auselia/adc_test_board/doc/notes/head_circuit.tex

\documentclass[border=6pt]{standalone}
\usepackage{amsmath}
\usepackage[siunitx,americanvoltage]{circuitikz}
\usepackage{xcolor}
\definecolor{ink}{HTML}{14231B}
\ctikzset{bipoles/length=1.15cm, resistors/scale=0.9, capacitors/scale=0.9, inductors/scale=0.9, voltage/distance from node=.3}
\newcommand{\lab}[3]{\shortstack{$#1$\\{\footnotesize #2}\\{\scriptsize #3}}}
\begin{document}
\sffamily
\begin{circuitikz}[american, color=ink, font=\small]
  % ---------- op-amp U8
  \node[op amp, yscale=1, scale=1.0] (op) at (8,0) {};
  \node[font=\footnotesize, align=left, anchor=west] at ($(op.down)+(0.35,-0.3)$) {U8 OPA365};
  \draw (op.-) -- ++(-1.4,0) coordinate (X) node[circ] {};
  \draw (op.+) -- ++(-1.4,0) coordinate (VP);
  \draw (op.out) -- ++(1.4,0) coordinate (O) node[circ] {};
  \draw (op.up) -- ++(0,0.45) node[vcc, font=\footnotesize] {$V_+$};
  \draw (op.down) -- ++(0,-0.45) node[ground] {};
  % ---------- feedback Rf || Cf
  \coordinate (F1) at ($(X)+(0,1.7)$);
  \coordinate (F2) at ($(X)+(0,3.4)$);
  \draw (X) -- (F2);
  \draw (F1) to[R, l={\lab{R_f}{1\,M$\Omega$}{$\pm1\,\%$}}] (F1 -| O) -- (O);
  \draw (F2) to[C, l={\lab{C_f}{47\,pF C0G}{$\pm5\,\%$}}] (F2 -| O) -- (F1 -| O);
  \node[circ] at (F1) {};
  % ---------- piezo
  \coordinate (P) at ($(X)+(-5.8,0)$);
  \coordinate (Q) at ($(X)+(-3.2,0)$);
  \draw (X) -- (P);
  \node[ground] (g1) at ($(P)+(0,-2.6)$) {};
  \draw (g1) to[isource] (P);
  \node[left, font=\footnotesize, align=right] at ($(P)+(-0.55,-1.3)$) {charge\\source $Q$};
  \node[circ] at (Q) {};
  \draw (Q) to[C, l_={\lab{C_p}{1.6\,nF}{$\pm20\,\%$}}] ($(Q)+(0,-2.6)$) node[ground] {};
  \node[font=\footnotesize, align=center] at ($(P)!0.5!(Q)+(0,0.6)$) {piezo SMD05T04S311\\(5\,mm $\times$ 0.4\,mm)};
  \node[font=\footnotesize, above] at ($(X)+(-1.0,0)$) {$v_x$};
  % ---------- reference divider R29, R30, C35
  \coordinate (D1) at ($(X)+(-1.7,-1.6)$);
  \node[vcc, font=\footnotesize] at (D1) {$V_+$};
  \draw (D1) to[R, l_={\lab{R_{29}}{1\,M$\Omega$}{$\pm1\,\%$}}] ($(D1)+(0,-2.4)$) coordinate (D2);
  \draw (D2) to[R, l_={\lab{R_{30}}{1\,M$\Omega$}{$\pm1\,\%$}}] ($(D2)+(0,-2.4)$) node[ground] {};
  \node[circ] at (D2) {};
  \draw (D2) -- ($(D2)+(1.2,0)$) coordinate (D3);
  \draw (D3) to[C, l={\lab{C_{35}}{10\,$\mu$F X5R}{$\pm20\,\%$}}] ($(D3)+(0,-2.4)$) node[ground] {};
  \node[circ] at (D3) {};
  \draw (D3) -| (X |- VP) -- (VP);
  \node[font=\footnotesize, anchor=east] at ($(D2)+(-0.2,0)$) {$V_{REF}\approx1.45$ V};
  % ---------- output: R31, C38, SMA
  \draw (O) to[R, l={\lab{R_{31}}{49.9\,$\Omega$}{$\pm1\,\%$}}] ($(O)+(2.9,0)$) to[C, l={\lab{C_{38}}{100\,nF X7R}{$\pm10\,\%$}}] ($(O)+(5.7,0)$) coordinate (H) node[circ] {};
  \draw (H) -- ($(H)+(1.3,0)$) node[ocirc] (J) {};
  \node[font=\footnotesize, right, align=left] at (J) {J6 SMA\\to SENSOR IN};
  % ---------- supply from the coax: L1, C36, C37
  \draw (H) to[L, l_={\lab{L_1}{470\,$\mu$H}{$\pm10\,\%$, DCR 22.5\,$\Omega$, SRF 2\,MHz}}] ($(H)+(0,-2.8)$) coordinate (VN) node[circ] {};
  \draw (VN) -- ++(0,-0.5) coordinate (VB);
  \node[font=\footnotesize, left=3pt] at (VN) {$V_+\approx2.9$ V};
  \draw (VB) -- ++(-1.1,0) to[C, l_={\lab{C_{36}}{100\,nF X7R}{$\pm10\,\%$}}] ++(0,-2.3) node[ground] {};
  \draw (VB) -- ++(1.1,0) to[C, l={\lab{C_{37}}{10\,$\mu$F X5R}{$\pm20\,\%$}}] ++(0,-2.3) node[ground] {};
  \node[font=\footnotesize, align=left, anchor=west] at ($(H)+(1.55,-1.5)$) {3.3 V arrives on\\the coax centre};
\end{circuitikz}
\end{document}
