auselia/adc_test_board/doc/notes/slides/s10_circuit.tex

\documentclass[border=6pt]{standalone}
\usepackage{amsmath}
\usepackage[siunitx,americanvoltage]{circuitikz}
\usepackage{xcolor}
\definecolor{ink}{HTML}{14231B}
\ctikzset{bipoles/length=1.15cm, resistors/scale=0.9, capacitors/scale=0.9, inductors/scale=0.9}
\newcommand{\lab}[3]{\shortstack{$#1$\\{\footnotesize #2}\\{\scriptsize #3}}}
\begin{document}
\sffamily
\begin{circuitikz}[american, color=ink, font=\small]
  \node[draw,thick,align=center,font=\footnotesize,minimum width=2.6cm,minimum height=2.2cm] (J) at (1.5,0) {J7\\5-pin header\\(jumper 1--2)};
  \node[font=\footnotesize,anchor=west] at (2.95,1.0){1 Onboard $+$}; 
  \node[font=\footnotesize,anchor=west] at (2.95,0.4){2 Force $+$, 3 Sense $+$};
  \node[font=\footnotesize,anchor=west] at (2.95,-0.2){4 Sense $-$, 5 Force $-$ (GND)};
  \draw (-0.1,1.0) node[left,font=\footnotesize,align=right]{PMOD 6, 12\\3.3 V} -- (0.2,1.0);
  \draw (0.2,0.4) -- (-0.6,0.4) -- (-0.6,-1.6) -- (8.0,-1.6) coordinate (V) node[circ]{} node[above=4pt,font=\footnotesize]{+3V3};
  \draw (V) to[C, l={\lab{C_{23}}{10\,$\mu$F}{X5R}}] ++(0,-2.2) node[ground]{};
  \draw (V) -- ++(2.2,0) to[short] ++(1.2,0) node[above,font=\footnotesize]{JP3} -- ++(1.0,0) coordinate (CAP) node[circ]{} node[above=3pt,font=\footnotesize,xshift=12mm]{+3V3\_C: U1 U2 U3};
  \draw (CAP) -- ++(0,-1.8) to[R, l={\lab{R_{34}}{10\,$\Omega$}{$\pm1\,\%$}}] ++(2.4,0) coordinate (AV) node[circ]{} -- ++(0.8,0) node[right,font=\footnotesize]{AVDD};
  \draw (AV) to[C, l_={\lab{C_{21}}{10\,$\mu$F}{X5R}}] ++(0,-2.2) node[ground]{};
  \draw (V) ++(1.0,0) node[circ]{} -- ++(0,1.8) -- ++(1.6,0) node[right,font=\footnotesize]{+3V3: listener, DVDD};
\end{circuitikz}
\end{document}
