auselia/adc_test_board/doc/notes/slides/s10_power.tex

\documentclass[11pt,a4paper]{article}
\input{common}
\title{\textbf{Slide 10: power and rails}\\\large 3.3 V from the PMOD alone, split by current links}
\author{ADS7057 test board v3 \quad ---\quad study notes}\date{}
\begin{document}\maketitle\vspace{-1.2em}
\section{The power tree}
\begin{center}\end{center}
PMOD pins 6 and 12 bring 3.3 V. There is no regulator, no diode and no USB. The 5-pin header J7 is the power entry: 1 Onboard + (PMOD 3.3 V), 2 Force +, 3 Sense +, 4 Sense $-$, 5 Force $-$. A jumper from 1 to 2 powers the board from the ZedBoard. For a source-measure unit remove the jumper and connect Force to 2 and 5, Sense to 3 and 4: the SMU powers the board and reads its total current. JP3 (closed) joins the capture rail +3V3\_C (U1, U2, U3 and AVDD) to +3V3. Open it to switch or measure the chain alone. The listener and DVDD sit on +3V3.

\section{AVDD is the reference}
The ADS7057 uses AVDD as its reference, so noise on AVDD is noise in the code. AVDD comes from the rail through R34 ($10\,\Omega$) and C21 ($10\,\mu$F). First-order RC:
\[
f_c=\frac1{2\pi R_{34}C_{21}}=\frac{1}{2\pi\cdot10\,\Omega\cdot10\,\mu\text{F}}=\SI{1.59}{kHz}
\]
\[
|H(\SI{250}{kHz})|=\frac1{\sqrt{1+(250/1.59)^2}}=\frac1{157}=-43.9\ \text{dB}.
\]
\begin{center}\end{center}
C18 ($4.7\,\mu$F) and C22 (\SI{100}{nF}) sit at the ADC pin. The DC drop over R34 is small: the ngspice rail shows AVDD at \SI{3.271}{V} against \SI{3.299}{V} on +3V3.

\section{The two mid-rails}
VMID5 (the 1.65 V that the filters and the gain stage reference) is a divider R7, R8 ($2\times10\,$k$\Omega$ from +3V3\_C) with C7 ($1\,\mu$F), copied by U2B and filtered by R9 and C8. The divider and C7 give $\tau=(R_7\parallel R_8)C_7=5\,\text{k}\Omega\times1\,\mu\text{F}=\SI{5}{ms}$, so VMID5 needs about $5\tau=\SI{25}{ms}$ after power-up. VOCM (the driver's centre) is a second divider R14, R15 ($2\times1\,$k$\Omega$ from AVDD) with C13. It follows AVDD by ratio, as the datasheet asks (AVDD/2 $\pm0.1$ V). ngspice: VMID5 1.649 V, VOCM 1.636 V.

\section{Current budget}
\begin{center}\end{center}
The sum of the datasheet typical values is \SI{25.9}{mA}, which is \SI{85}{mW} at 3.3 V. The ngspice netlist with all links closed gives \SI{24.8}{mA}. The four OPA2365 channels dominate. The listener takes only \SI{22}{\micro A}. The 1.65 mA of the VOCM divider is the cheapest saving if the board ever runs from a battery (use $10\,$k$\Omega$ and a larger C13).

\begin{key}
Open item: the noise of the ZedBoard 3.3 V rail is not measured. Probe TP11 (+3V3) and TP12 (AVDD) on the first board.
\end{key}
\end{document}
