auselia/adc_test_board/doc/notes/slides/s08_circuit.tex

\documentclass[border=6pt]{standalone}
\usepackage{amsmath}
\usepackage[siunitx,americanvoltage]{circuitikz}
\usepackage{xcolor}
\definecolor{ink}{HTML}{14231B}
\ctikzset{bipoles/length=1.15cm, resistors/scale=0.9, capacitors/scale=0.9, inductors/scale=0.9}
\newcommand{\lab}[3]{\shortstack{$#1$\\{\footnotesize #2}\\{\scriptsize #3}}}
\begin{document}
\sffamily
\begin{circuitikz}[american, color=ink, font=\small]
  \node[font=\footnotesize,anchor=east] at (0,1.2){DRV\_OUTP}; \node[font=\footnotesize,anchor=east] at (0,-1.2){DRV\_OUTN};
  \draw (0,1.2) to[R, l={\lab{R_{16}}{10\,$\Omega$}{$\pm1\,\%$}}] ++(2.6,0) coordinate (A) node[circ]{} -- ++(3.0,0) node[above,font=\footnotesize,xshift=-6mm]{AINP};
  \draw (0,-1.2) to[R, l_={\lab{R_{17}}{10\,$\Omega$}{$\pm1\,\%$}}] ++(2.6,0) coordinate (B) node[circ]{} -- ++(3.0,0) node[below,font=\footnotesize,xshift=-6mm]{AINM};
  \draw (A) -- ++(0,0) ; \draw (A) to[C, l_={\lab{C_{14}..C_{17}}{4 $\times$ 100\,pF C0G}{400\,pF, $\pm5\,\%$}}] (B);
  \draw[thick,rounded corners=2pt] (5.6,-2.0) rectangle (10.4,2.0);
  \node[align=center,font=\footnotesize] at (8,2.5){U4 ADS7057 sampling input (model)};
  \draw (5.6,1.2) to[R, l={\lab{}{50\,$\Omega$}{}}] (7.6,1.2) to[C, l={\lab{}{16\,pF}{}}] (9.4,1.2) node[ground,rotate=0]{};
  \draw (5.6,-1.2) to[R, l_={\lab{}{50\,$\Omega$}{}}] (7.6,-1.2) to[C, l_={\lab{}{16\,pF}{}}] (9.4,-1.2) node[ground]{};
\end{circuitikz}
\end{document}
