auselia/adc_test_board/doc/notes/slides/s03_circuit.tex

\documentclass[border=6pt]{standalone}
\usepackage{amsmath}
\usepackage[siunitx,americanvoltage]{circuitikz}
\usepackage{xcolor}
\definecolor{ink}{HTML}{14231B}
\ctikzset{bipoles/length=1.15cm, resistors/scale=0.9, capacitors/scale=0.9, inductors/scale=0.9}
\newcommand{\lab}[3]{\shortstack{$#1$\\{\footnotesize #2}\\{\scriptsize #3}}}
\begin{document}
\sffamily
\begin{circuitikz}[american, color=ink, font=\small]
  % head side
  \node[font=\footnotesize, align=right, anchor=east] at (-0.2,0) {U8 output\\ $v_o$};
  \draw (0,0) to[R, l={\lab{R_{31}}{49.9\,$\Omega$}{$\pm1\,\%$}}] (3,0) to[C, l={\lab{C_{38}}{100\,nF X7R}{$\pm10\,\%$}}] (6,0) coordinate (H) node[circ]{};
  \draw (H) to[L, l_={\lab{L_1}{470\,$\mu$H}{$\pm10\,\%$, DCR 22.5\,$\Omega$}}] ($(H)+(0,-3)$) coordinate (VH) node[circ]{};
  \node[font=\footnotesize, left=3pt] at (VH) {$V_+\approx2.9$ V};
  \draw (VH) -- ++(0,-0.5) coordinate (VB);
  \draw (VB) -- ++(-1.0,0) to[C, l_={\lab{C_{36}}{100\,nF}{X7R}}] ++(0,-2.1) node[ground]{};
  \draw (VB) -- ++(1.0,0) to[C, l={\lab{C_{37}}{10\,$\mu$F}{X5R}}] ++(0,-2.1) node[ground]{};
  % coax
  \draw[line width=2.2pt, color=ink!70] (H) -- ++(6.6,0) coordinate (M);
  \node[above, font=\footnotesize] at ($(H)!0.5!(M)+(0,0.1)$) {coax, 50\,$\Omega$};
  \node[circ] at (M) {};
  % main board side
  \draw (M) to[C, l={\lab{C_{33}}{100\,nF X7R}{$\pm10\,\%$}}] ($(M)+(3,0)$) coordinate (S) node[circ]{};
  \draw (S) -- ++(1.3,0) node[right, font=\footnotesize, align=left] {SIG\_IN\\to the high-pass};
  \draw (S) to[R, l_={\lab{R_{27}}{1\,M$\Omega$}{$\pm1\,\%$}}] ($(S)+(0,-2.6)$) node[vcc, rotate=180, font=\footnotesize, anchor=south]{};
  \node[font=\footnotesize, right] at ($(S)+(0.15,-2.9)$) {$V_{MID5}$ 1.65 V};
  \draw (M) to[L, l_={\lab{L_2}{470\,$\mu$H}{$\pm10\,\%$, DCR 22.5\,$\Omega$}}] ($(M)+(0,-3)$) coordinate (P) node[circ]{};
  \node[font=\footnotesize, left=3pt] at (P) {JP1 closed};
  \draw (P) -- ++(0,-0.5) coordinate (PB);
  \draw (PB) -- ++(-1.1,0) to[R, l_={\lab{R_{26}}{47\,$\Omega$}{$\pm1\,\%$}}] ++(0,-2.1) node[vcc, rotate=180]{};
  \node[font=\footnotesize, below=14pt] at ($(PB)+(-1.1,-2.1)$) {3.3\,V};
  \draw (PB) -- ++(1.1,0) to[C, l={\lab{C_{32}}{10\,$\mu$F}{X5R $\pm10\,\%$}}] ++(0,-2.1) node[ground]{};
\end{circuitikz}
\end{document}
