auselia/adc_test_board/doc/notes/head_charge_amp.pdf

## The sensor head, from the equations up

Charge amplifier, OPA365, DC point and noise

ADS7057 test board v3 — study notes

All voltages are deviations from the DC operating point, written in lowercase (v). Capital V is a total or DC value. The Laplace variable is s = jω = j2πf.

## 1 The circuit and its three equations

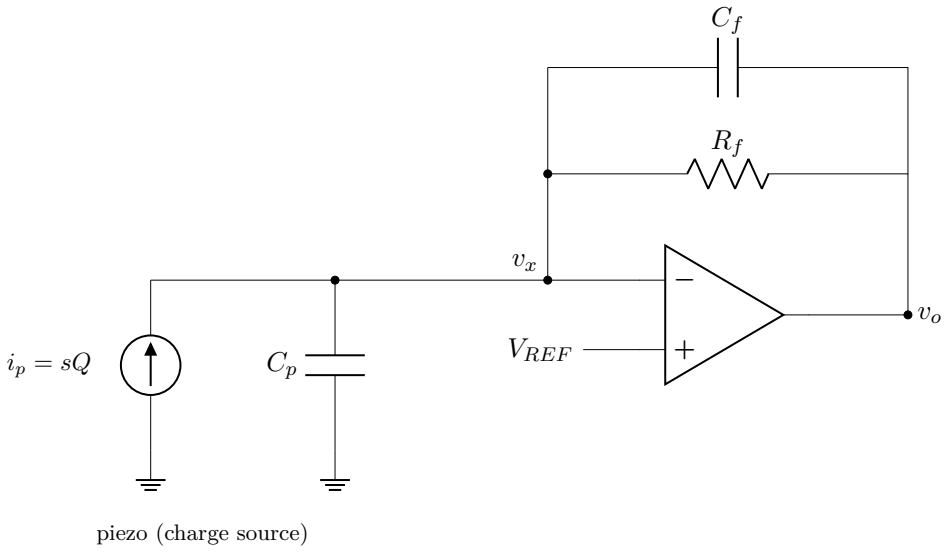
[picture p1: figure]
VREF; piezo (charge source)

The piezo is a charge source Q in parallel with its own capacitance Cp ≈ 1.6 nF. In the head, Cf = 47 pF and Rf = 1 MΩ are in parallel between the output and the summing node, and the + input sits at VREF ≈ 1.45 V.

Feedback impedance:

Zf =

Rf
1 + sRfCf

, Yf =

1
Zf

=

1
Rf

+ sCf .

Three equations describe the whole stage.

(1) Op-amp with finite gain (+ input at VREF , so 0 in deviations):

vo = A (0 − vx) = −A vx.

(2) KCL at the summing node. The piezo current leaves through Cp and through the feedback branch:
ip = sCp vx +

vx − vo
Zf

(3) The piezo:

ip =

dq
dt ←→ ip(s) = s Q(s).

We do not assume a virtual ground. vx is allowed to be non-zero.

## 2 Exact solution

From (1), vx − vo = (1 + A)vx. Putting this in (2):

ip = vx

h
sCp + (1 + A)Yf

i
⇒ vx =

ip
sCp + (1 + A)Yf

Then vo = −A vx:

vo = − ip Zf

1

1 +

1 + sCpZf
A

Read this as ideal result × error factor. The ideal part −ipZf is what you get as A → ∞ (the virtual ground). The numerator of the error term, 1 + sCpZf , is the noise gain.

## 3 Frequency response

A single-pole op-amp is modelled as
A(s) = ωt
s
, | ωt = 2π GBW, | GBW = 50 MHz (OPA365).

Substitute ip = sQ and A = ωt/s:

| vo Q = − | s Zf
| 1 +

s (1 + sCpZf )

| | ωt .

Numerator. With Zf = Rf /(1 + sRfCf ),

sZf =

1
Cf

·

s
s + ωL
| , | ωL =
| | 1 RfCf .

Denominator. For ω ≫ ωL, Zf ≈ 1/(sCf ), so 1 + sCpZf → 1 + Cp/Cf . Define the noise gain

Gn = 1 +

Cp
Cf
, | 1 +
| sGn ωt
= 1 +
| | s ωH
, | ωH =
| | ωt Gn .

Together:
vo
Q

≈ −

| 1 Cf s

# s + ωL | {z }

| high-pass | 1 1 + s/ωH
| {z }
| | low-pass
The head is a band-pass. Mid-band gain is −1/Cf .
Quantity | Formula | Value
Mid-band gain 1/Cf | 21.3 mV per pC
Low corner | fL =
| 1 2πRfCf | 3.39 kHz (τ = 47 µs)
Noise gain | Gn = 1 + Cp/Cf | 1 + 1600/47 = 35.0
High corner | fH = GBW/Gn | 1.43 MHz

At 250 kHz, the middle of the AE band:

s
s+ωL

≈ 0.9999,

1
1+j 250/1430
=

1
√
1 + 0.175²

= 0.985 (−0.13 dB).

The perfboard’s OPA1642 has GBW ≈ 11 MHz, so fH = 11/35 = 0.31 MHz and the factor at
250 kHz is 1/

√
1 + 0.8

2 = 0.78, that is −2.1 dB. This is the 0.2 dB versus 2.2 dB difference between the boards.

## 4 How good is the “virtual ground”?

From the solution, vx = −vo/A. At 250 kHz, A = GBW/f = 200. For a 100 mV output, vx = 0.5 mV. That is small but not zero. The charge that stays on Cp is

Cpvx = (1.6 nF)(0.5 mV) = 0.8 pC.

This is the origin of the error term Gnf /GBW = 0.175.

A large Cp compared with Cf means a large noise gain, less loop gain, and a larger error. A smaller Cf gives more volts per pC but more noise gain and less bandwidth. This is the design trade-off of the head.

## 5 Noise from the same model

Add the op-amp’s input voltage noise en in series with the + input. With the signal off, the loop gives

vo,n = en

1 +

Zf
ZCp
= en (1 + sCpZf )

ω≫ωL −−−−−→ en Gn.

This is the same quantity as in the error factor, which is why it is called the noise gain. With
en = 4.5 nV/

√
Hz:

enGn = 158 nV/

√
Hz, vn,rms = 158 nV/

√
Hz ·

√
400 kHz ≈ 100 µV.
The noise densities are per √
Hz because independent sources add as powers.

Thermal noise of Rf appears as a current noise

in,Rf =

s
4kT
Rf

= 0.129 pA/

√
Hz.
It flows through Zf . At 250 kHz, |Zf | ≈ 1/(2πfCf ) = 13.5 kΩ, so it adds about 1.7 nV/

√
Hz at the
output, about 1 % of the op-amp’s. It can be ignored.

Equivalent noise charge (noise referred to the input):

Qn = vn,rms Cf ≈ 100 µV × 47 pF = 4.7 fC.

The perfboard measurements show about 4 mV rms in the band, 40 times the amplifier’s own noise. So the noise you see comes from elsewhere (plant, cables, pickup), not from the op-amp.

## 6 DC operating point

Set s → 0 in the KCL. Cp and Cf are open circuits, so the only DC path is Rf . A real op-amp also has an input bias current Ib and an input offset voltage Vos:

Vout,DC = VREF

A
1 + A

+ IbRf + Vos ≈ VREF + IbRf + Vos.

For DC the stage is a unity-gain follower.

- With Ib of a few pA and Rf = 1 MΩ, IbRf is of order µV. Negligible.
- If Ib were 160 nA (as in the THS4531), IbRf would be 0.16 V. A high-bias part does not work with a megohm feedback resistor.

The reference comes from the divider R29, R30 (both 1 MΩ):

VREF = V+

R30

R29 + R30

=

2.9 V
2

= 1.45 V.

So the output rests at about 1.45 V, mid-supply. The available swing is about ±1.3 V:

Qmax ≈ 1.3 V × 47 pF ≈ 61 pC,

while events are 2 to 11 pC.

## 7 Supply down the coax (bias-T)

An inductor is the opposite of a capacitor: |ZL| = 2πfL. For L = 470 µH:

|ZL|(250 kHz) = 2π · 250 000 · 470 × 10−6 ≈ 740 Ω ≫ 50 Ω,

and ≈ 0 at DC. So the DC supply flows through the inductor, and the signal goes through the capacitor C38 instead (|ZC| = 1/(2πfC) = 6.4 Ω at 250 kHz for 100 nF). The drop across R26 (47 Ω) and the inductor’s own resistance, at about 4.3 mA, takes roughly 0.4 V off 3.3 V, so V+ at the amplifier is about 2.9 V.

## 8 Stability

The loop gain is T(s) = A(s) β(s) with feedback factor β = 1/Gn. At high frequency β ≈ Cf /(Cf + Cp) = 1/35, which is flat. The crossover (|T| = 1) is at fH = 1.43 MHz. There the op-amp’s single pole has used 90◦ of phase, leaving about 90◦ minus whatever the output stage (R31 and the load) adds. Cf in the feedback path is what keeps this stable: without it, Cp at the − node would add a feedback zero and could peak.

## 9 OPA365: the specs that matter

Spec | Value | Why it matters here
Gain-bandwidth | 50 MHz | Sets the head bandwidth, GBW/Gn = 1.4 MHz. The perfboard’s 11 MHz cost 2 dB.
Input voltage noise | 4.5 nV/

√
| Hz | Sets the noise floor: 100 µV rms at the output, 4.7 fC equivalent.
Supply range | 2.2 to 5.5 V | The head runs at about 2.9 V, inside the range.
Rail-to-rail in/out | yes | The output can use the full swing around 1.45 V.
Zero-crossover input | yes | No offset jump when the input sits near mid- supply, where our reference is.
Quiescent current | about 4.6 mA | Almost all of the head’s 4.3 mA. Reason for the OPA314 (150 µA) low-power option.
Input bias current | pA class (verify) | Allows Rf = 1 MΩ without a DC error.
Input offset voltage | a few hundred µV (verify) | Shifts the rest level slightly. Harmless with AC coupling.
Slew rate | about 25 V/µs (ver- ify) | A 150 mV burst at 250 kHz needs 2πfV = 0.24 V/µs. Large margin.

The entries marked verify are quoted from memory. Check them against the datasheet.

## 10 The design in five steps

1. KCL at the summing node with ip = sQ gives vo = −Q sZf (ideal).
2. Zf = Rf ∥ Cf : mid-band gain −1/Cf , high-pass at 1/(2πRfCf ) = 3.4 kHz.
3. Finite A = ωt/s adds the error factor with noise gain Gn = 1 + Cp/Cf = 35, which gives a low-pass at GBW/Gn = 1.4 MHz.
4. The same Gn multiplies en: about 100 µV rms at the output, 4.7 fC equivalent.
5. DC: a unity-gain follower to VREF , plus IbRf + Vos.
