auselia/adc_test_board/doc/notes/slides/s07_circuit.pdf

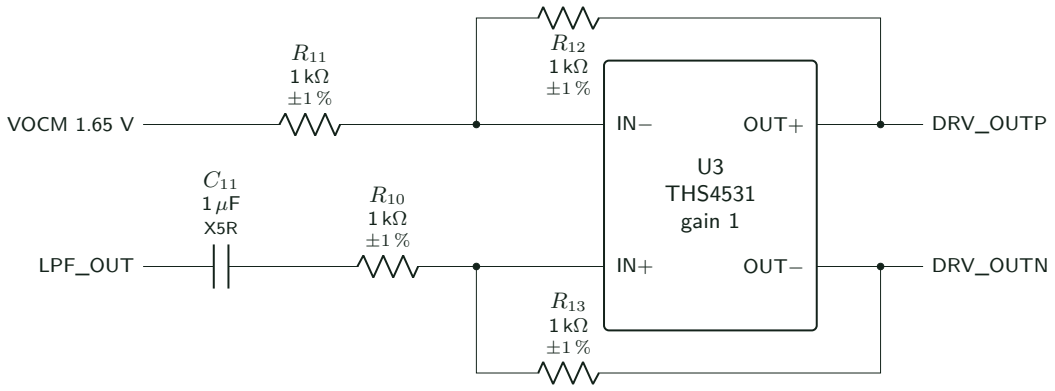
[picture p6: figure]
U3 THS4531 gain 1; OUT; LPF_OUT; VOCM 1.65 V; DRV_OUTP; DRV_OUTN
