auselia/adc_test_board/doc/notes/slides/s07_driver.pdf

## Slide 7: the driver (THS4531)

Turn one wire into the two the ADC needs

ADS7057 test board v3 — study notes

## 1 Why two wires

The ADS7057 measures the difference VAINP − VAINM, not a voltage to ground. Noise that reaches both inputs equally cancels. The low-pass output (LPF_OUT) is one wire. The driver U3 makes the second wire as a mirror image of the first, around the mid-rail VOCM = 1.65 V.

## 2 The circuit

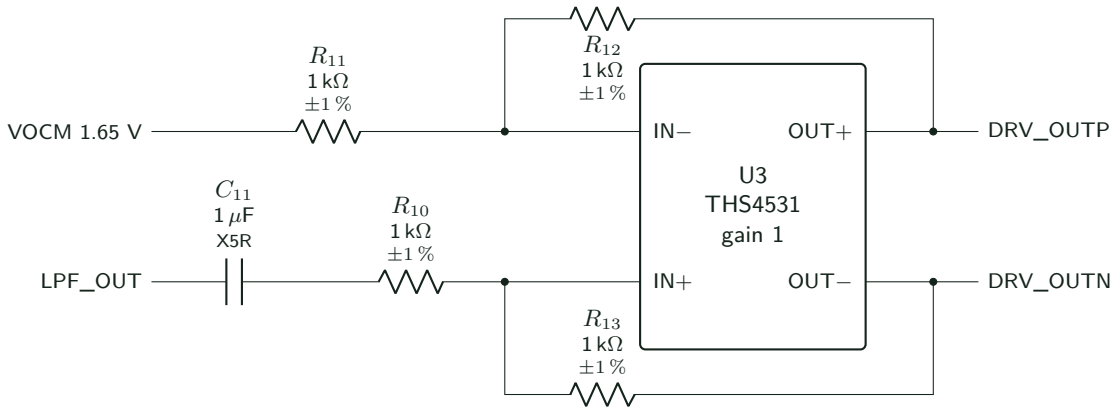
[picture p7: figure]
U3 THS4531 gain 1; OUT+; LPF_OUT; OUT−; VOCM 1.65 V; DRV_OUTP; DRV_OUTN

All four resistors are 1 kΩ. C11 blocks DC. VOCM sets the centre of the two outputs (R14, R15 divide AVDD, C13 smooths it).

## 3 Derivation

An ideal fully differential amplifier keeps its two inputs at the same voltage, vP = vN = v, and forces the average of its outputs to VOCM:

vo+ + vo−
2

= VOCM.

Write the current balance at the two input nodes (R = 1 kΩ for all four resistors, no current enters the amplifier):

node P: vin − v
R

+

vo− − v
R

= 0 node N: VOCM − v
R

+

vo+ − v
R

= 0.

Subtract the second equation from the first. The v terms cancel:

vin − VOCM + vo− − vo+ = 0 ⇒ vo+ − vo− = vin − VOCM

1

For the signal alone (deviation from DC, so VOCM does not move) the differential output equals the input: the gain is R13/R10 = 1. With the common-mode condition each output carries half:

vo± = VOCM ±

vin
2

DC. C11 is open at DC, so only R13 and R11 act. Both outputs sit at VOCM (ngspice: DRV_OUTP and DRV_OUTN at 1.64 V). Nothing is amplified at DC and nothing clips.

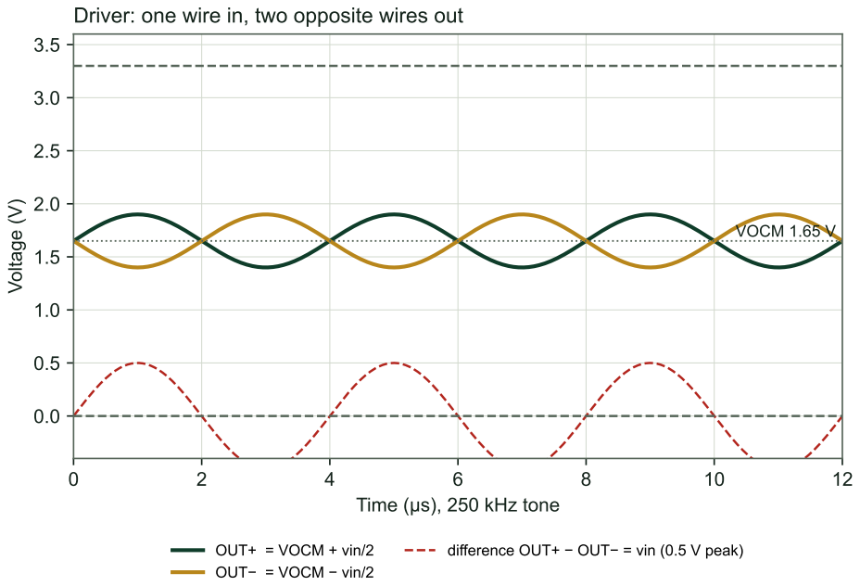
[picture p8: figure]
Time (µs), 250 kHz tone; Voltage (V); VOCM 1.65 V; OUT+ = VOCM + vin/2 OUT− = VOCM − vin/2

Driver: one wire in, two opposite wires out

difference OUT+ − OUT− = vin (0.5 V peak)

## 4 The input corner

The signal source sees C11 in series with the amplifier’s input resistance. The two feedback paths act on both input nodes, so the input resistance is not R10 alone. Solve node P with vo+ = 2v, vo− = −2v (ac, outputs in opposition): v = vin/4, so

iin =

vin − v
R

=

3
4

vin
R

⇒ Rin =

4R
3

= 1.33 kΩ, fc =

1
2πRinC11

= 119 Hz.

Correction to the manual (step 17): it gives 159 Hz, which uses R10 alone. With the feedback included the corner is 119 Hz. Both are far below the 100 kHz band, so nothing else changes.

## 5 Numbers to remember

Item | Value

Supply and VOCM range (3.3 V) 2.5 to 5.5 V; VOCM 0.95 to 2.3 V
Gain, band | differential gain 1; bandwidth far above the band
Event of 120 mV at the head | about 0.5 V between AINP and AINM
Load between the outputs | 400 pF behind 20 Ω, the datasheet suggests about 2 pF
(open risk, slide 13)

2
