auselia/adc_test_board/doc/notes/slides/s09_circuit.pdf

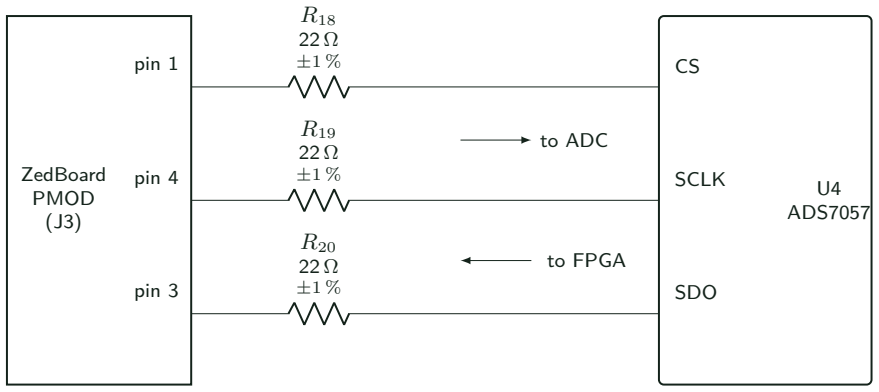
[picture p11: figure]
ZedBoard PMOD (J3); U4 ADS7057; pin 1; pin 4; SCLK; pin 3; SDO; to ADC; to FPGA

PMOD pins 5, 11 GND; 6, 12 3.3 V; 7 BIG_N; 10 WAKE_N; 2, 8, 9 not used
