auselia/adc_test_board/doc/notes/slides/s09_graph.pdf

CS

### SCLK

SDO | 0 | D13 D12 D11 D10 D9 | D8 | D7 | D6 | D5 | D4 | D3 | D2 | D1 | D0 | 0 | 0 | 0

CS falls: the ADC samples here

18 clocks: leading 0, 14 data bits (MSB first), 3 zeros. After the 18th clock CS rises; at least 95 ns of acquisition follow.
