auselia/adc_test_board/doc/notes/slides/s10_graph.pdf

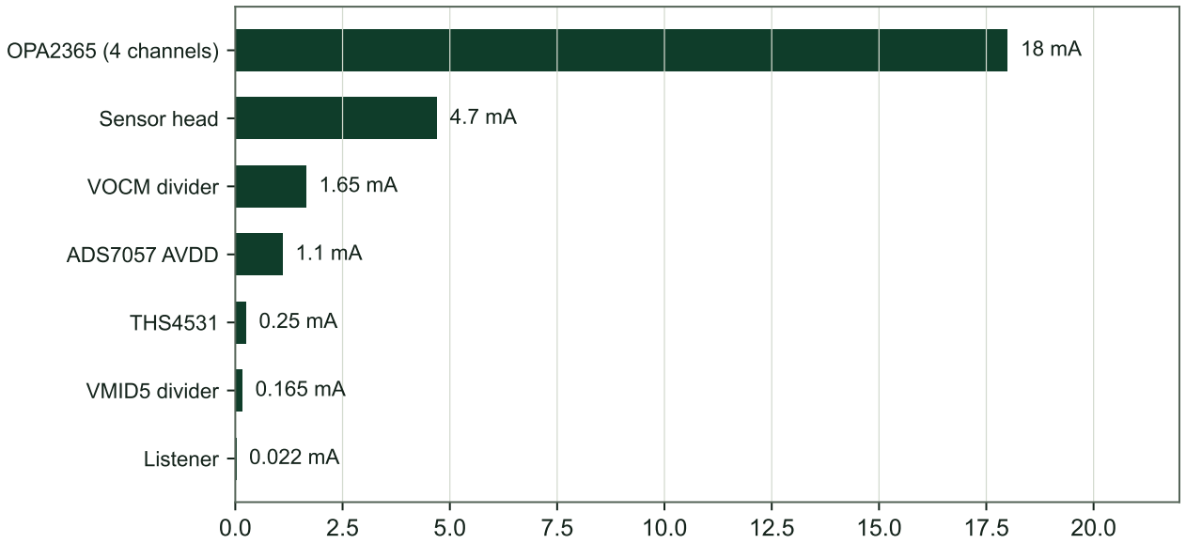
[picture p14: figure]
OPA2365 (4 channels); Sensor head; VOCM divider; ADS7057 AVDD; THS4531; VMID5 divider; Listener

Current from the 3.3 V of the PMOD (mA)

Current budget: 25.9 mA (datasheet typical values), ngspice 24.8 mA
