auselia/adc_test_board/doc/notes/slides/s13_graph.pdf

DC operating point, all rails (18 checks) | PASS | ngspice, as-built netlist
Gain 12.3 dB at 250 kHz; −40.5 dB at 10 kHz; −24 dB at 2 MHz | PASS | ngspice
Listener thresholds: WAKE_N 35 mV, BIG_N 111 mV at SIG_IN | PASS | ngspice, 5 burst levels
ERC, DRC, schematic against board | PASS | KiCad, 0 errors
Head and bias-T at 3.3 V; listener on 25 real captures | SIMULATED | ngspice, Python
ZedBoard 3.3 V rail noise (TP11, TP12) | OPEN | measure
PMOD fit on adjacent ports | OPEN | print 1:1, test
THS4531 stable with 400 pF + 20 Ω | OPEN | LTspice / bench
First board on the bench | OPEN | manual steps 49 to 52

# What is checked and what is open
