auselia/adc_test_board/hw/backplane/out/FMC_Adapter.pdf

1 | 2 | 3 | 4 | 5 | 6 | 7 | 8 | 9 | 10 | 11 | 12 | 13 | 14 | 15 | 16
1 | 2 | 3 | 4 | 5 | 6 | 7 | 8 | 9 | 10 | 11 | 12 | 13 | 14 | 15 | 16

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
## IJK Date: 2026-10-12

Size: A1 | Rev: A
KiCad E.D.A. 10.0.6 | Id: 1/1

# Title: ZedBoard FMC to backplane adapter (3 V level shifters, two 50-pin ribbon outputs)

## File: FMC_Adapter.kicad_sch

## Sheet: /

### Universidad de los Andes - Auselia VCCA 1 DIR 2

A1 3
A2 4
A3 5
A4 6
A5 7
A6 8
A7 9
A8 10 | GND 11 | GND 12 | GND 13 | B8 14 B7 15 B6 16 B5 17 B4 18 B3 19 B2 20 B1 21 OE 22 | VCCB 23 | VCCB 24 U5

SN74LVC8T245

C1
100nF

TP2 +3V3_FMC

TP3

VADJ

TP1 GND | VCCA 1 DIR 2

A1 3
A2 4
A3 5
A4 6
A5 7
A6 8
A7 9
A8 10 | GND 11 | GND 12 | GND 13 | B8 14 B7 15 B6 16 B5 17 B4 18 B3 19 B2 20 B1 21 OE 22 | VCCB 23 | VCCB 24 U1
SN74LVC8T245 | R6 47RR7 47R R5 47R R8 47R

C2

# 100nF R3 47R R2 47R R4 47R

D1

3V3 OK R27 1k | C20

100nF C19

100nF C18

10uF C17

10uF | GND C14 | GND C58 | GND C9
LA06_P C10 | LA06_NC11 GNDC12 | GNDC13
LA10_P C14 | LA10_NC15 GNDC16 | GNDC17
LA14_P C18 | LA14_NC19 GNDC20 | GNDC21
LA18_P_CC C22 | LA18_N_CCC23 GNDC24 | GNDC25
LA27_P C26 | LA27_NC27 GNDC28 | GNDC2932 | GNDC336 | GNDC38 | 3P3V C39 C40 | GND D2 | GND D3 | GND D67
LA01_P_CC D8 | LA01_N_CC GND | D9 D10
LA05_P D11 | LA05_ND12 GNDD13
LA09_P D14 | LA09_ND15 GNDD16
LA13_P D17 | LA13_ND18 GNDD19
LA17_P_CC D20 | LA17_N_CCD21 GNDD22
LA23_P D23 | LA23_ND24 GNDD25
LA26_P D26 | LA26_ND27 GND D28 | TDI D30 | TDO D313P3V D36GND D37 | 3P3V D39 | D3840GND G1 | GND G4 | GND G5
LA00_P_CC G6 | LA00_N_CC G7 GND G8
LA03_P G9 | LA03_NG10 GND G11
LA08_P G12 | LA08_NG13 GND G14
LA12_P G15 | LA12_NG16 GND G17
LA16_P G18 | LA16_NG19 GND G20
LA20_P G21 | LA20_NG22 GND G23
LA22_P G24 | LA22_NG25 GND G26
LA25_P G27 | LA25_NG28 GND G29
LA29_P G30 | LA29_NG31 GND G32
LA31_P G33 | LA31_NG34 GND G35
LA33_P G36 | LA33_NG37 GND G38 | VADJ G39GND G40 | PRSNT_M2C_L H3 | H2 GND H6
LA02_P H7 | LA02_N H8 GND H9
LA04_P H10 | LA04_NH11 GND H12
LA07_P H13 | LA07_NH14 GND H15
LA11_P H16 | LA11_NH17 GND H18
LA15_P H19 | LA15_NH20 GND H21
LA19_P H22 | LA19_NH23 GND H24
LA21_P H25 | LA21_NH26 GND H27
LA24_P H28 | LA24_NH29 GND H30
LA28_P H31 | LA28_NH32 GND H33
LA30_P H34 | LA30_NH35 GND H36
LA32_P H37 | LA32_NH38 GND H39 | VADJ H40

J1

ASP-134602-01 | C15
100nF | VCCA 1 DIR
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
10 | GND 11 | GND 12 | GND 13 | B8

14 B7

15 B6

16 B5

17 B4

18 B3

19 B2

20 B1

21 OE 22 | VCCB 23 | VCCB 24 U8
SN74LVC8T245 | C16

100nF

H4M3 H1M3 | H3M3

C14

100nF C13

# 100nF VCCA 1 DIR

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
10 | GND 11 | GND 12 | GND 13 | B8

14 B7

15 B6

16 B5

17 B4

18 B3

19 B2

20 B1

21 OE 22 | VCCB 23 | VCCB 24 U7
SN74LVC8T245 | R18 47R R17 47R
1 | 2
3 | 4
5 | 6
7 | 8
9 | 10
11 | 12
13 | 14
15 | 16
17 | 18
19 | 20
21 | 22
23 | 24
25 | 26
27 | 28
29 | 30
31 | 32
33 | 34
35 | 36
37 | 38
39 | 40
41 | 42
43 | 44
45 | 46
47 | 48
49 | 50

J3 RIBBON B R1 47R

1 | 2
3 | 4
5 | 6
7 | 8
9 | 10
11 | 12
13 | 14
15 | 16
17 | 18
19 | 20
21 | 22
23 | 24
25 | 26
27 | 28
29 | 30
31 | 32
33 | 34
35 | 36
37 | 38
39 | 40
41 | 42
43 | 44
45 | 46
47 | 48
49 | 50
J2 RIBBON | A

C3

100nF | C4

100nF VCCA 1 DIR
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
10 | GND 11 | GND 12 | GND 13 | B8

14 B7

15 B6

16 B5

17 B4

18 B3

19 B2

20 B1

21 OE 22 | VCCB 23 | VCCB 24 U2
SN74LVC8T245 | R16 47R R14 47R R13 47R R15 47R

R26

100k R25

100k R24

100k R23

# 100k R12 47R R10 47RR11 47R R9 47R

C8

100nF C7

# 100nF VCCA 1 DIR

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
10 | GND 11 | GND 12 | GND 13 | B8

14 B7

15 B6

16 B5

17 B4

18 B3

19 B2

20 B1

21 OE 22 | VCCB 23 | VCCB 24 U4

SN74LVC8T245 C6

# 100nF R20

100k R19

100k C5
100nF | R22

100k R21

# 100k VCCA 1 DIR

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
10 | GND 11 | GND 12 | GND 13 | B8

14 B7

15 B6

16 B5

17 B4

18 B3

19 B2

20 B1

21 OE 22 | VCCB 23 | VCCB 24 U3

SN74LVC8T245 VCCA 1 DIR

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
10 | GND 11 | GND 12 | GND 13 | B8

14 B7

15 B6

16 B5

17 B4

18 B3

19 B2

20 B1

21 OE 22 | VCCB 23 | VCCB 24 U6

SN74LVC8T245 C11

100nF

H2M3

C12

100nF C10

100nF C9

100nF GND | GND

LA08_N
LA07_P
LA07_N

GND

LA12_P
LA12_N
LA11_P
LA11_N GND VADJ | GND GND
RB_WAKE0 RB_WAKE1 RB_WAKE2 RB_WAKE3 RB_WAKE4+3V3_FMC | VADJ GND | +3V3_FMC | +3V3_FMC
RB_BIG5 RB_BIG6 RB_BIG7 GND | +3V3_FMC GND GND

GND
LA16_P
LA16_N
LA15_P
LA15_N GND VADJ RB_WAKE7 | RB_BIG0 RB_BIG1 RB_BIG2 RB_BIG3 RB_BIG4

LA20_P
LA20_N
LA19_P | GND | GND | GND
LA19_N
RB_WAKE6 | GND
RB_WAKE1 RB_WAKE3 RB_WAKE4 RB_WAKE5 | RB_WAKE6 RB_WAKE7 RB_BIG0 RB_BIG2 RB_BIG5 | GND

RB_BIG1 RB_BIG3 RB_BIG4 RB_BIG6 GND

GND

GND
GND
GND

GND
GND
GND
GND VADJ GND | +3V3_FMC | +3V3_FMC
RB_WAKE5 | GND | GND +3V3_FMC | RA_SDO3 +3V3_FMC

GND
LA18_P_CC
LA18_N_CC
LA23_P
LA23_N
LA27_P
LA26_P
LA27_N

# LA26_N GND VADJ

GND

RA_BIG5 RA_BIG6 RA_BIG7 GND | +3V3_FMC GND | GND | GND RA_SDO0 | RA_SDO1 | RA_SDO2 GND | GND VADJ

LA30_N

RA_BIG0 RA_BIG1 RA_BIG2 RA_BIG3 RA_BIG4

LA29_N | VADJ VADJ | +3V3_FMC | +3V3_FMC

GND
LA00_P_CC
LA00_N_CC
LA02_P
LA02_N
LA03_P
LA03_N
LA04_P
LA04_N
LA28_N | GND VADJ | GND | GND | GND

LA27_N

T_RB_CS0
T_RB_CS1
T_RB_CS2
T_RB_CS3
T_RB_CS4

T_RB_CS0

T_RB_CS1

# T_RB_CS7 +3V3_FMC GND

T_RB_CS6

LA26_N

T_RB_CS5
T_RB_CS6
T_RB_CS7

T_RB_CS4

T_RB_CS5

T_RB_CS2 | RB_CS0 RB_CS2 RB_CS1

LA25_N

RB_CS3

LA24_N

LA23_N

LA22_N | GND RB_SDO0 GND | RB_SDO1

LA21_N

LA20_N | GND RB_SDO2 | RB_SDO3 GND

LA19_N

LA18_N_CC

RB_CS5 RB_CS7

LA17_N_CC

RB_CS6

# LA16_N GND

RB_CS4

LA33_N | VADJ GND | +3V3_FMC | +3V3_FMC
RA_WAKE5 RA_WAKE6 RA_WAKE7 GND | GND | GND

LA32_N

# RA_WAKE0 RA_WAKE1 RA_WAKE2 RA_WAKE3 RA_WAKE4+3V3_FMC GND

LA31_N

LA13_N
LA14_N
LA17_P_CC
LA17_N_CC GND VADJ VADJ

GND
LA10_N
LA09_N
LA13_P
LA14_P

# RB_SDO1 GND

GND
GND
GND | GND VADJ

RA_SCLK
RA_SDO0 RA_SDO1 RA_SDO2 RA_SDO3 GND

GND
GND
RA_CS1 GND

RA_CS0 GND

RA_CS3 GND
RA_CS6 RA_CS4 RA_CS5 RA_CS7 RA_WAKE0 RA_WAKE2 | GND

RA_WAKE1 RA_WAKE3 RA_WAKE4 RA_WAKE6 GND

RA_BIG1 RA_BIG3 RA_BIG4 RA_BIG6 GND

GND

GND

# GND+3V3_FMC

GND
GND
GND

RA_SDO0 RA_SDO1 GND

RA_SDO2 RA_SDO3

LA08_P

RB_SDO2 RB_SDO3 | RB_SCLK

GND
GND
GND
GND | GND

RA_SCLK JTAG_BYP

RB_SCLK
RB_SDO0 RB_SDO1 RB_SDO2 RB_SDO3 GND

GND
GND
RB_CS1 RB_CS2 | RB_CS0 GND
| RB_CS3 GND
RB_CS6 RB_CS4 RB_CS5 RB_CS7 RB_WAKE0 RB_WAKE2 JTAG_BYP +3V3_FMC
RA_WAKE5 RA_WAKE7 RA_BIG0 VADJ | +3V3_FMC
RA_BIG2 RA_BIG5 RA_BIG7 GND | GND | GND +3V3_FMC

GND

GND
GND
LA22_P
LA22_N
LA21_P
LA21_N
LA25_P
LA25_N
LA24_P
LA24_N | GND VADJ GND +3V3_FMC | +3V3_FMC
T_RA_SCLK | RB_BIG7
T_RB_SCLK

RA_CS2

RA_CS1

T_RA_SCLK

T_RB_SCLK
VADJ GND

LA29_P
LA29_N
RA_CS2 RA_CS0 RA_CS3 GND | +3V3_FMC GND GND | VADJ | +3V3_FMC | +3V3_FMC

RA_CS7

GND
GND
GND
GND
GND | GND GND
GND | GND VADJ | GND GND GND GND | GND | GND | GND GND | GND | GND

LA00_P_CC
LA01_P_CC
LA02_P
LA03_P
LA04_P
LA05_P
LA06_P
LA07_P
LA08_P
LA09_P
LA10_P
LA11_P
LA12_P
LA13_P

LA29_P
LA30_P
LA31_P
LA32_P
LA33_P | GND | GND | GND

LA14_P
LA15_P
LA16_P
LA17_P_CC
LA18_P_CC
LA19_P
LA20_P
LA21_P
LA22_P
LA23_P
LA24_P
LA25_P
LA26_P
LA27_P
LA28_P | GND | GND | GND | GND

LA00_N_CC

LA02_N

LA01_N_CC

LA03_N
LA04_N
LA05_N
LA06_N
LA07_N
LA08_N
LA09_N
LA10_N
LA11_N
LA12_N
LA13_N
LA14_N
LA15_N GND | GND | GND | GND | GND | GND | GND | GND VADJ VADJ GND | +3V3_FMC GND | GND | GND GND VADJ | +3V3_FMC GND | GND +3V3_FMC | LED_AGND | LED_A | GND

T_RA_CS3

T_RA_CS1

T_RA_CS2

T_RA_CS0 GND

T_RA_CS0
T_RA_CS1
T_RA_CS2
T_RA_CS3
T_RA_CS4

# T_RA_CS7 +3V3_FMC GND

T_RA_CS6 GND GND

T_RA_CS5
T_RA_CS6
T_RA_CS7

T_RA_CS4

T_RA_CS5 GND GND

GND
LA01_P_CC
LA01_N_CC
LA06_P
LA06_N
LA05_P
LA05_N
LA10_P
LA09_P GND | GND GND | +3V3_FMC | GND
RA_CS4 RA_CS6 RA_CS5 VADJ VADJ | +3V3_FMC | +3V3_FMC GND VADJ | GND | GND

RB_SDO0

PRSNT_M2C_L (H2) is grounded and TDI is tied to TDO (D30-D31), as the FMC standard asks a mezzanine without JTAG devices; the ZedBoard adds the FMC to the JTAG chain when it sees PRSNT.

58 lines: 18 outputs (16 chip selects, 2 SCLK) and 40 inputs (16 WAKE_N, 16 BIG_N, 8 SDO lanes). Outputs have 47 R series resistors for the ribbon. SDO lane inputs have 100 k pull-downs (SDO is Hi-Z while no card is selected).

Plugs into the ZedBoard FMC LPC connector (J1 in the ZedBoard schematic). Eight SN74LVC8T245 level shifters: A side = VADJ (any of 1.8 / 2.5 / 3.3 V, so no J18 change is needed), B side = 3.3 V from the FMC 3P3V pins.

FMC adapter for the ADS7057 backplane | R9 47R R11 47R R10 47R R12 47R

R24

100k R25

# 100k R15 47R R13 47RR14 47R R16 47R

J2 RIBBON | A 1 | 2
3 | 4
5 | 6
7 | 8
9 | 10
11 | 12
13 | 14
15 | 16
17 | 18
19 | 20
21 | 22
23 | 24
25 | 26
27 | 28
29 | 30
31 | 32
33 | 34
35 | 36
37 | 38
39 | 40
41 | 42
43 | 44
45 | 46
47 | 48
49 | 50 | R17 47RR18 47R

U7

# SN74LVC8T245 VCCA 1 DIR

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
10 | GND 11 | GND 12 | GND 13 | B8

14 B7

15 B6

16 B5

17 B4

18 B3

19 B2

20 B1

21 OE 22 | VCCB 23 | VCCB 24 R4 47R R2 47RR3 47R R8 47R R5 47R R7 47R R6 47R R1 47R
