auselia/adc_test_board/doc/notes/slides/s03_biast.pdf

## Slide 3: input and bias-T

One coax carries the signal in and the power out

ADS7057 test board v3 — study notes

## 1 What the circuit must do

The sensor head has no battery. It needs about 4.3 mA of DC from the main board. The same coax must also bring the AE signal (100 to 500 kHz) back, without the supply wires loading it. A bias-T does this with two parts that behave in opposite ways:

- an inductor passes DC and blocks AC (|ZL| = 2πfL),
- a capacitor blocks DC and passes AC (|ZC| = 1/2πfC).

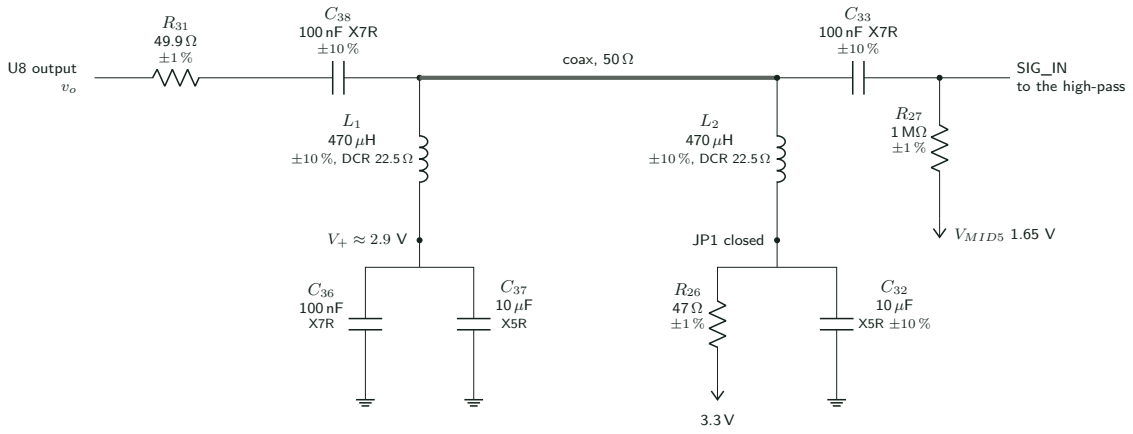
[picture p15: figure]
U8 output vo; L1 470 µH ±10 %, DCR 22.5 Ω; coax, 50 Ω; SIG_IN to the high-pass; VMID5 1.65 V; L2 470 µH ±10 %, DCR 22.5 Ω; JP1 closed

## 2 The DC path: how much voltage reaches the head

DC flows from +3.3 V through R26, the closed jumper JP1, L2, the coax centre, and L1 into the head. At DC the capacitors are open and the inductors are only their winding resistance, DCR = 22.5 Ω each (LCSC C75644). So

RDC = R26+DCRL2+DCRL1 = 47+22.5+22.5 = 92 Ω, ∆V = I RDC = 4.3 mA×92 Ω = 0.40 V,

V+ = 3.3 − 0.40 = 2.90 V.

This is the supply of the OPA365. The head amplifier works from 2.2 to 5.5 V, so there is margin. The inductor is rated 40 mA, ten times the load.

R26 and C32 form a supply filter with a corner at 1/(2π · 47 · 10 µF) = 339 Hz. It removes ripple from the 3.3 V rail before it enters the coax.

1

## 3 The AC path: what the signal sees

The head output drives R31 (49.9 Ω) and C38. Both inductors hang from the coax line to an AC ground (their far ends sit on large capacitors). Two branches Zb = RDCR + jωL are in parallel, so the line is loaded by
ZL =

1/2(RDCR + jωL).
The source impedance is Zs = R31 + 1/(jωC38). The line voltage is a plain divider:

H(s) = ZL
ZL + Zs

=

s

2 LC
2 + s

RC
2
s

2 LC

2 + s C( R

2 + R31)
+ 1

Read it as a second-order high-pass with

ω0 =

√
2
LC , f0 =

1
2π

√
2
470 µH · 100 nF = 32.8 kHz, Q =

1
ω0 C (R/2 + R31)

≈ 0.79.

Below about 33 kHz the inductors short the line to ground, so the bias-T rejects low-frequency noise by itself. At 10 kHz the loss is 18.5 dB by hand and 18.7 dB in ngspice. At 250 kHz, the middle of the AE band, the hand model gives about 0 dB and ngspice gives 0.17 dB. The extra 0.1 dB comes from the cable and the filter loading, which the hand model leaves out.

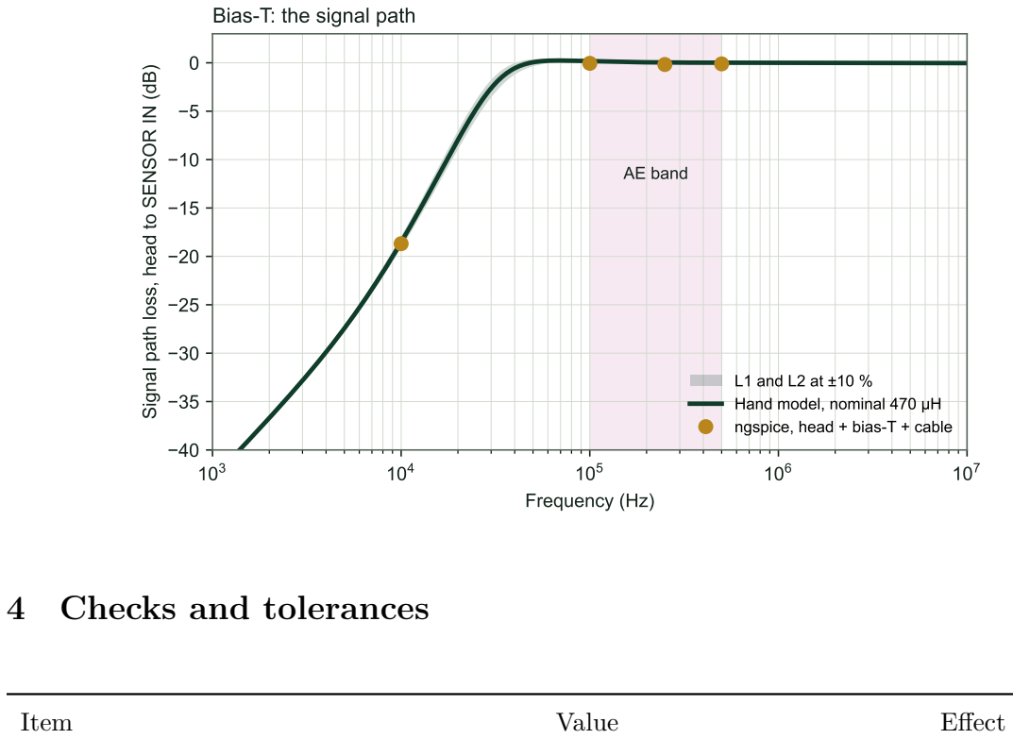
[picture p16: figure]
Frequency (Hz); AE band; Bias-T: the signal path; L1 and L2 at ±10 %; Hand ngspice, head; model, nominal 470 µH; + bias-T +; cable; 4 Checks and tolerances; Item; Value; Effect

Signal path loss, head to SENSOR IN (dB)

L1, L2: 470 µH ±10 % | f0 moves ±5 % (31 to 34.5 kHz) small, shown as the grey band
Wavelength at 250 kHz | about 800 m in the cable | a 1 m cable is a lumped element
Cable capacitance (RG174, about 100 pF/m) 6.4 kΩ at 250 kHz | adds a small load
Inductor self-resonance | 2 MHz | above the band, so L stays an inductor to 500 kHz
C33 and R27 at SIG_IN | 100 nF into 1 MΩ | 1.6 Hz corner, DC blocked

2
