auselia/adc_test_board/doc/notes/slides/s03_graph.pdf

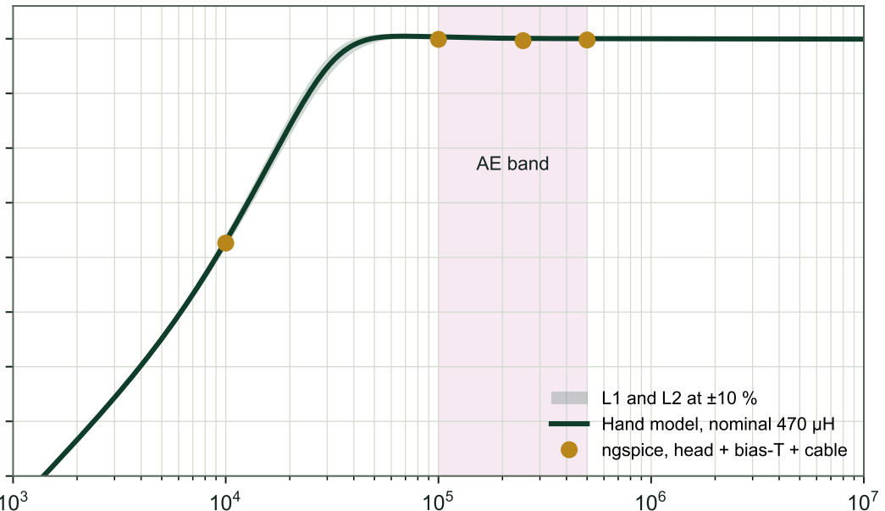
[picture p17: figure]
AE band; Hand ngspice, head; model, nominal 470 µH; + bias-T +; cable

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
### Frequency (Hz)

−40 −35 −30 −25 −20 −15 −10−50
Signal path loss, head to SENSOR IN (dB)

### Bias-T: the signal path

L1 and L2 at ±10 %
