auselia/adc_test_board/doc/notes/slides/s04_circuit.pdf

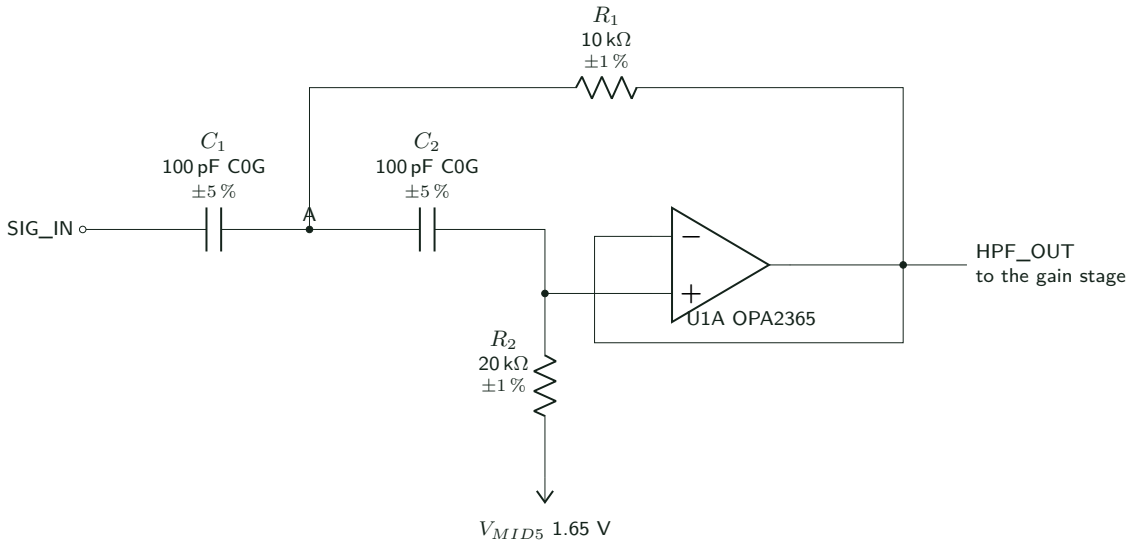
[picture p18: figure]
+ U1A OPA2365; HPF_OUT to the gain stage; SIG_IN; VMID5 1.65 V
