auselia/adc_test_board/doc/notes/slides/s04_hpf.pdf

## Slide 4: high-pass filter

Cut the plant noise below the AE band

ADS7057 test board v3 — study notes

## 1 Why the board needs a high-pass

Eight baseline records, taken with no event, show where the noise sits. Below 100 kHz it is 11.5 to 26.8 mV rms. Inside the AE band (100 to 500 kHz) five records show only 3.7 to 4.6 mV rms. Events are 234 to 275 kHz. A high-pass just under the band removes the large low-frequency noise before the gain stage amplifies it by 4.9.

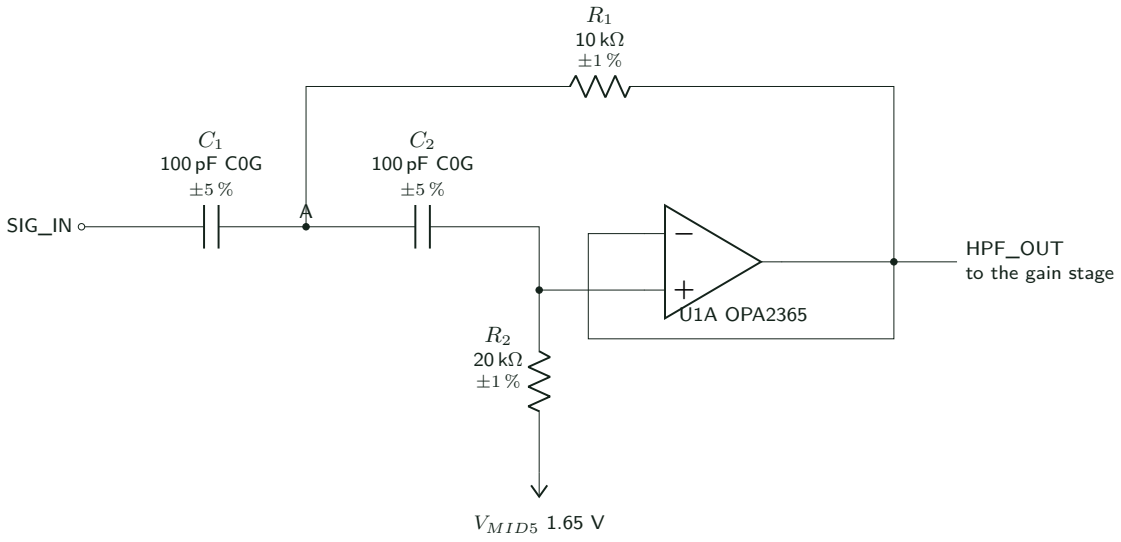
[picture p19: figure]
+ U1A OPA2365; HPF_OUT to the gain stage; SIG_IN; VMID5 1.65 V

## 2 Derivation from the node equations

U1A is a voltage follower, so the output equals the voltage at its + input: Vo = VB. The current into each node must sum to zero (all voltages are deviations from VMID5, so R2 goes to 0).

Node B (the + input draws no current):

(VB − VA) sC2 +

VB
R2

= 0 ⇒ VA = VB

(
1 +

1
sR2C2

)

Node A:
(VA − Vin) sC1 + (VA − VB) sC2 +

VA − Vo
R1

= 0, Vo = VB.

Substitute VA and collect VB:

sC1Vin = VB

[
sC1 +

C1 + C2

R2C2

+

1
sR1R2C2

]

Divide by sC1:

H(s) = VB

Vin

=

s

2

s

2 + s

C1 + C2

R2C1C2

+

1

R1R2C1C2
Compare with the standard second-order form s

2/(s

2 + s ω0/Q + ω
2/0):

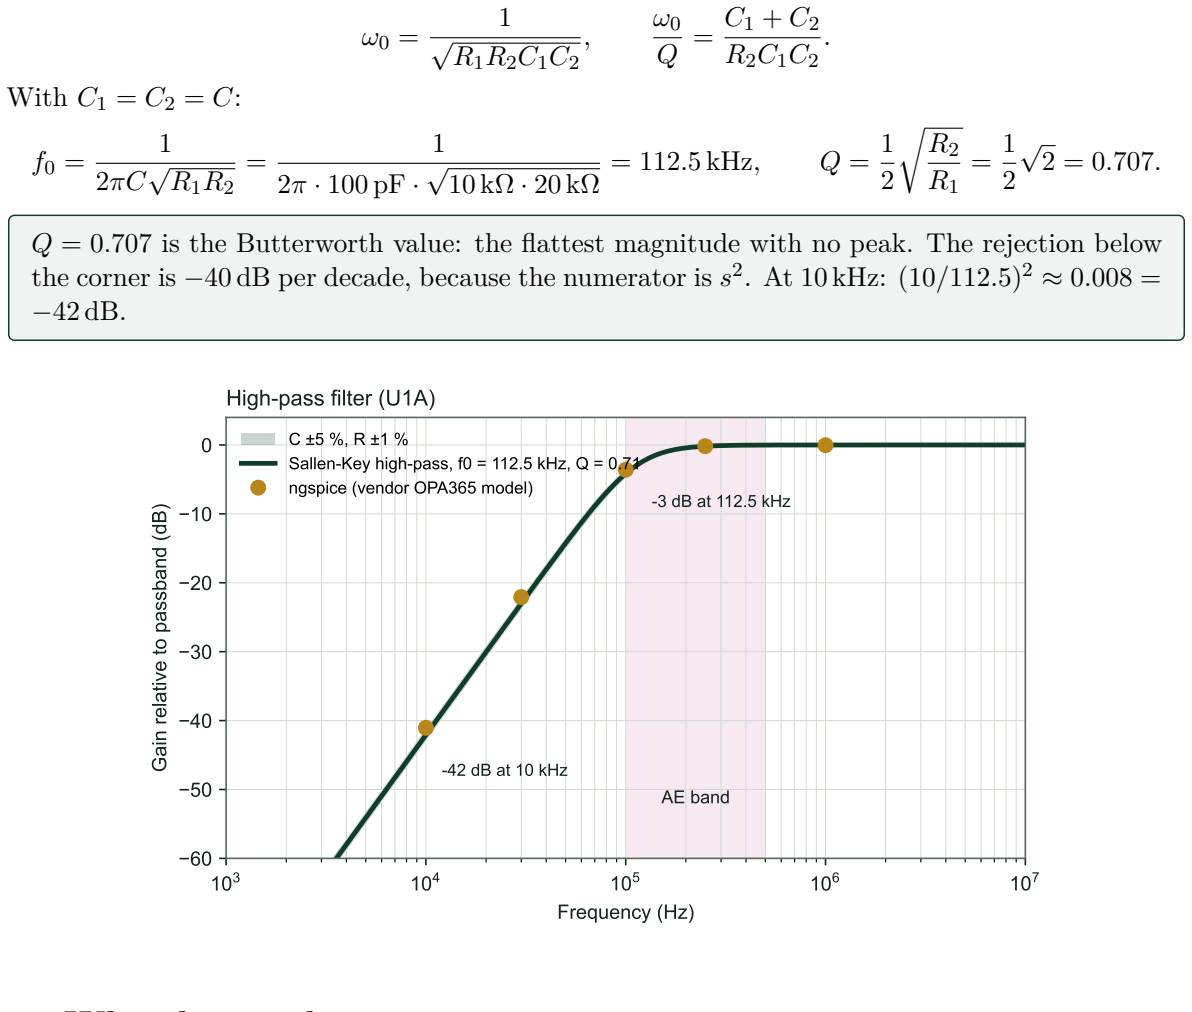
[picture p20: figure]
With C1 = C2 = C:; = 112.5 kHz,; . At 10 kHz: (10/112.5)² ≈ 0.008 =; Frequency (Hz); Gain relative to passband (dB); AE band; -42 dB at 10 kHz; High-pass filter (U1A)

Q = 0.707 is the Butterworth value: the flattest magnitude with no peak. The rejection below the corner is −40 dB per decade, because the numerator is s

Sallen-Key high-pass, f0 = ngspice | | (vendor OPA365 model) | 112.5 kHz, Q = | 0.71 -3 dB at 112.5 kHz

## 3 Why these values

- Corner at 112.5 kHz: just under the AE band. A higher corner would also cut the events. The loss at 250 kHz is only 0.17 dB.
- C1 = C2: then Q depends only on the resistor ratio. Equal C0G capacitors in one value keep the BOM short.
- R2 to VMID5, not ground: the stage rests at 1.65 V, so the single supply never clips the negative half.
- OPA2365, GBW 50 MHz: the follower stays accurate far above the corner. Finite gain changes H by less than 0.01 dB at 250 kHz.

## 4 Tolerances

Capacitors are C0G ±5 % (C14858), resistors ±1 % (C25804, C4184). Over all 16 corner combina-tions of C1, C2, R1, R2:

f0 = 106.1 to 119.7 kHz, Q = 0.699 to 0.714.

The corner moves about ±6 %. Q stays within 1 % of 0.707, so the response keeps its shape. The grey band in the plot is a random sample of these tolerances.
