auselia/adc_test_board/doc/notes/slides/s05_circuit.pdf

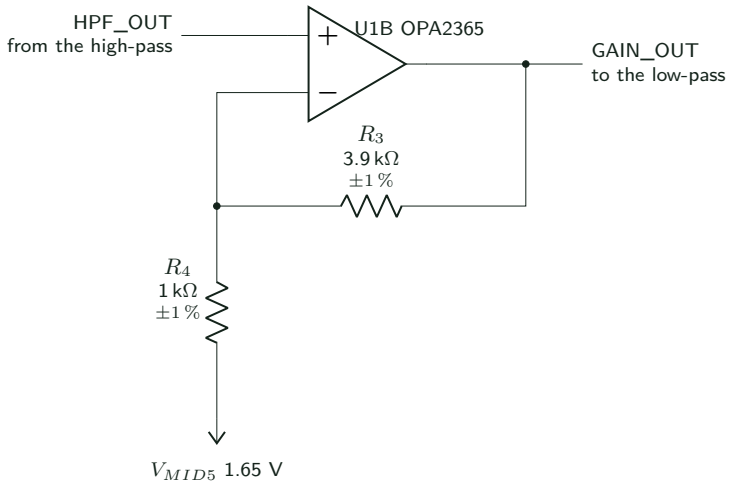
[picture p21: figure]
HPF_OUT; U1B OPA2365; from the high-pass; GAIN_OUT; to the low-pass; VMID5 1.65 V
