auselia/adc_test_board/doc/notes/slides/s05_gain.pdf

## Slide 5: gain stage

Gain of 4.9, referenced to the mid-rail

ADS7057 test board v3 — study notes

## 1 The circuit

U1B is a non-inverting amplifier. R3 feeds part of the output back to the − input and R4 returns the other end to VMID5 (1.65 V), not to ground.

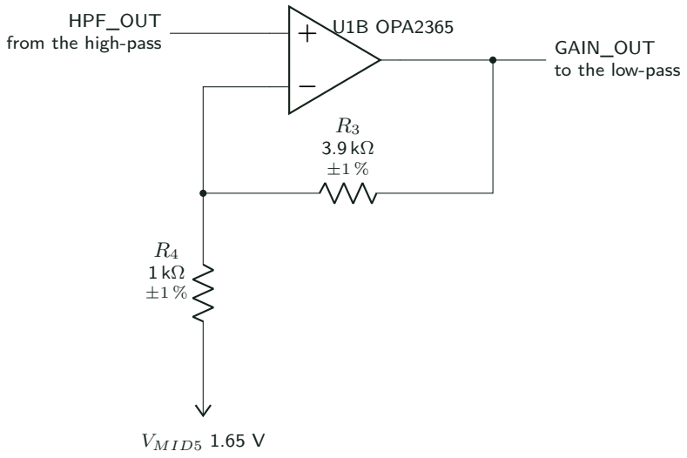
[picture p22: figure]
HPF_OUT; U1B OPA2365; from the high-pass; GAIN_OUT; to the low-pass; VMID5 1.65 V

## 2 Gain from the op-amp equation

Let v be the deviation from VMID5. The feedback divider gives the − input

v− = β vo, β =

R4
R3 + R4

=

1 kΩ
4.9 kΩ

= 0.204.

The op-amp equation with finite gain A is vo = A (vin − v−) = A (vin − βvo). Solve for vo:

vo

vin

=

A
1 + Aβ =

1
β

·

1

1 +

1
Aβ

A→∞ −−−−→ G =

1
β

= 1 +

R3
R4

= 1 +

3.9
1

= 4.9 (13.8 dB).

The DC point. Because R4 returns to VMID5, the deviation equation holds for the total voltages too:

Vo − VMID5 = G (Vin − VMID5).
A signal that rests at VMID5 (the high-pass output does) leaves the output at VMID5 as well. The gain applies only to the burst, and DC passes at ×1. If R4 went to ground, the stage would amplify the 1.65 V rest level to 8.1 V and clip.

1

## 3 Bandwidth

With A = ωt/s (GBW = 50 MHz), the finite-gain factor is 1/(1 + s/(β ωt)). The closed-loop pole is at
β · GBW = 0.204 × 50 MHz = 10.2 MHz.

At 250 kHz the loss is −0.0003 dB. The stage is accurate across the band.

## 4 Headroom: what clips first

The output can swing about 0.1 V from each rail. That gives ±(1.65−0.1) = 1.55 V around VMID5. The largest input amplitude before clipping is

1.55
4.9

= 0.32 V at the gain-stage input.

The simulation, which includes the bias-T, the high-pass and the gain, clips at about 0.35 V at the head output (total gain 4.45 from the head to GAIN_OUT at 250 kHz). A typical recorded event is 120 mV, so the margin is 2.9×. The largest of the seven events was 236 mV peak to peak, about 118 mV peak, on the perfboard. The new head loses less, so it reads about 25 % higher (150 mV). The margin for that event is about 2.3×.

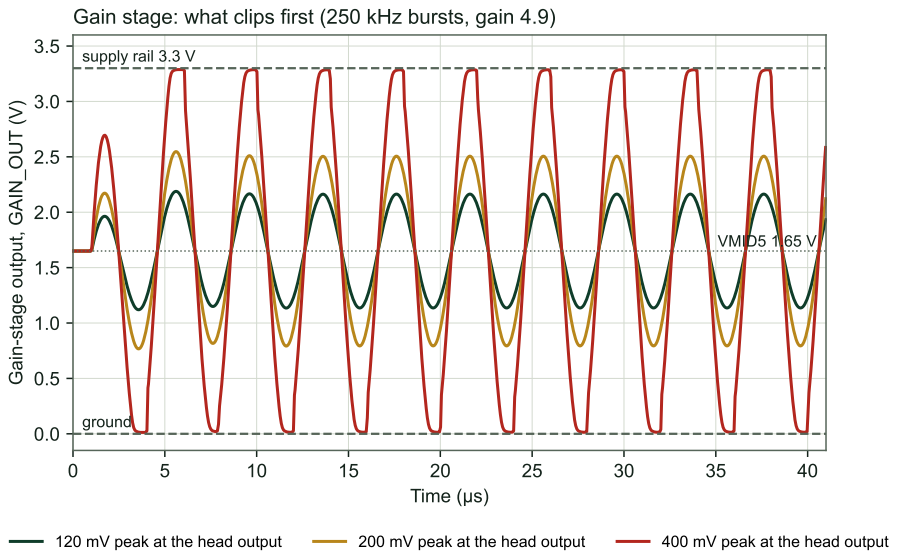
[picture p23: figure]
Time (µs); Gain-stage output, GAIN_OUT (V); supply rail 3.3 V; ground; VMID5 1.65

Gain stage: what clips first (250 kHz bursts, gain 4.9)

120 mV peak at the head output | 200 mV peak at the head output | 400 mV peak at the head output

The 120 mV burst reaches 2.2 V and stays inside the rails. The 200 mV burst reaches 2.55 V. The 400 mV burst flat-tops at both rails.

## 5 Tolerance and noise

- R3, R4 are ±1 % (C23018, C21190). Worst case G = 4.82 to 4.98 (±1.6 %, about ±0.14 dB).
- Noise of this stage, referred to its input: the op-amp 4.5 nV/

√
Hz and R3 ∥ R4 = 0.8 kΩ
(3.6 nV/

√
Hz) add to about 5.8 nV/

√
Hz. Over 400 kHz that is ≈ 3.7 µV. The head’s noise (100 µV at its output) dominates.
- Why 4.9: a 120 mV event fills about 5 times more ADC codes than with unity gain, and the stage still clips only above 0.35 V. A change is one resistor (R3).

2
