auselia/adc_test_board/doc/notes/slides/s06_circuit.pdf

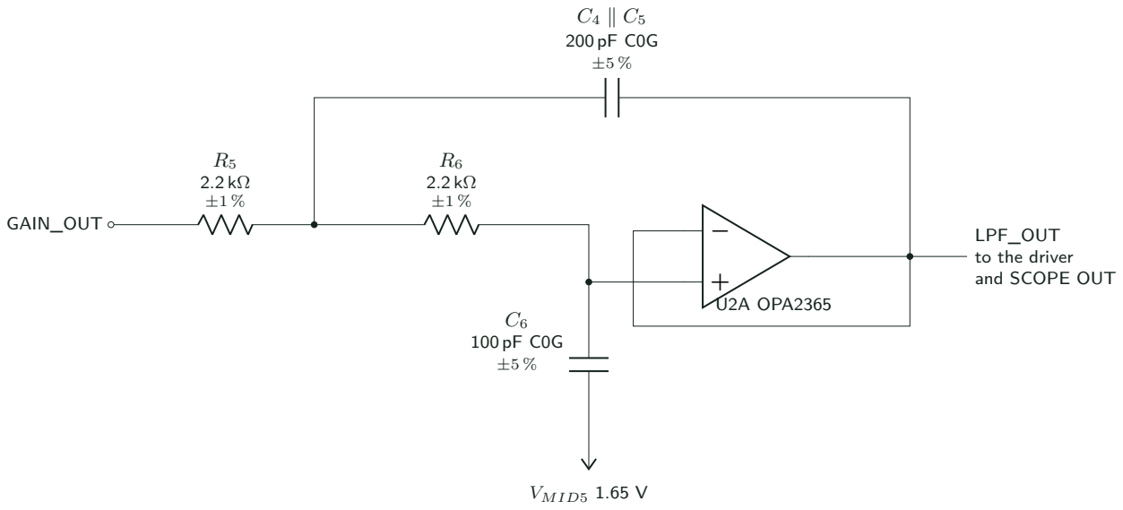
[picture p24: figure]
+ U2A OPA2365; LPF_OUT to the driver and SCOPE OUT; GAIN_OUT; VMID5 1.65 V
