auselia/adc_test_board/doc/notes/slides/s06_lpf.pdf

## Slide 6: low-pass filter and the whole filter chain

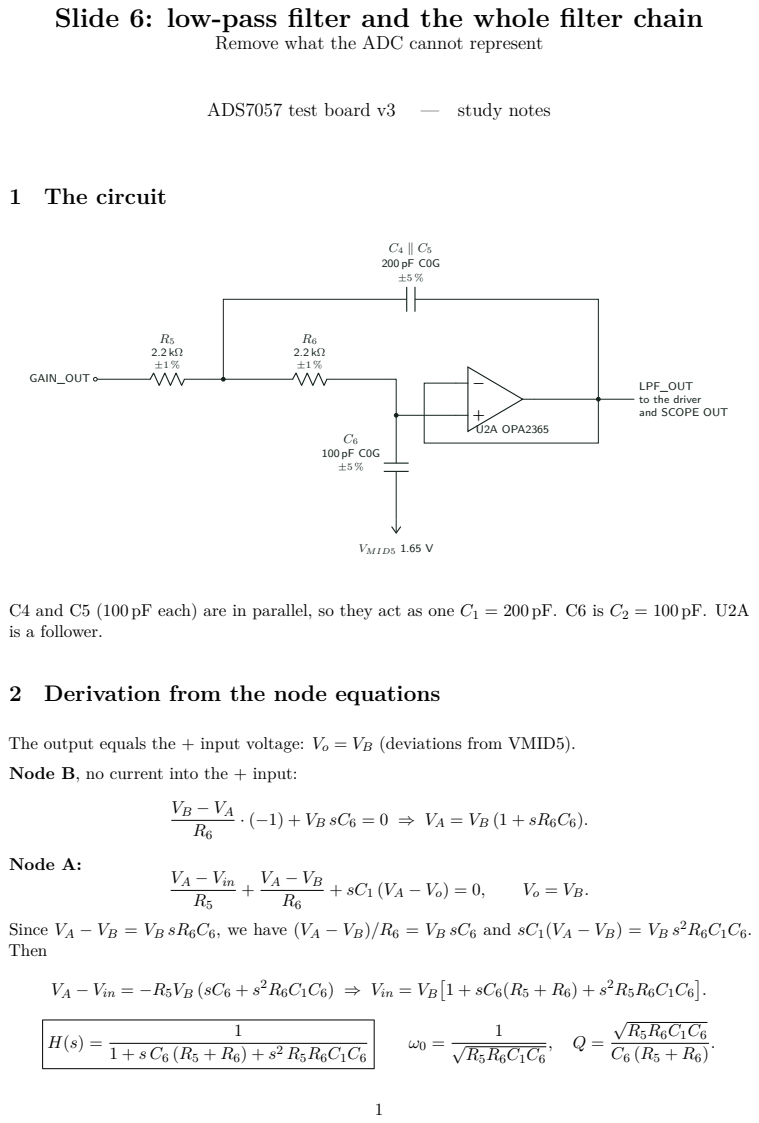
[picture p25: page 1]

Remove what the ADC cannot represent

C4 and C5 (100 pF each) are in parallel, so they act as one C1 = 200 pF. C6 is C2 = 100 pF. U2A
is a follower.

2 Derivation from the node equations

The output equals the + input voltage: Vo = VB (deviations from VMID5).
Node B, no current into the + input:

Since VA − VB = VB sR6C6, we have (VA − VB)/R6 = VB sC6 and sC1(VA − VB) = VB s
Then

With R5 = R6 = 2.2 kΩ, C1 = 200 pF, C6 = 100 pF:

f0 =

1
2π · 2.2 kΩ

√
200 pF · 100 pF

= 511.5 kHz, Q =

2.2k

√
2 × 10−20
100p · 4.4k

= 0.707.

It is the Butterworth low-pass: flat in the band, −3 dB at f0, and −40 dB per decade above.

Frequency | 250 kHz | 500 kHz | 800 kHz | 2 MHz
Loss of the low-pass alone | 0.24 dB | 2.8 dB | 8.4 dB | 23.8 dB

## 3 Aliasing: why a low-pass before the ADC

A sampler at FS cannot tell f from |f − kFS|. The sample rate is about 1.2 MSPS (estimate for a 25 MHz SPI clock), so the fold frequency is FS/2 = 600 kHz:

falias = |f − FS| : | 700 kHz → 500 kHz, | 800 kHz → 400 kHz, | 1 MHz → 200 kHz.

Noise above 600 kHz would land inside the band if the filter did not remove it.

Be honest about the margin: a second-order filter at 512 kHz removes only 8 dB at 800 kHz and 12 dB at 1 MHz. The design relies on two facts. First, the measured event spectra fall steeply above 300 kHz. Part of that fall came from the perfboard amplifier’s own roll-off (its corner was 0.31 MHz), so the real sensor spectrum may extend higher and needs a new measurement. Second, the corner is kept near the top of the band so the pass-band stays flat. A faster SPI clock (up to 2.5 MSPS) moves the fold to 1.25 MHz and adds margin.

## 4 The whole filter chain

The high-pass (slide 4) and the low-pass multiply, so in dB they add. The result is a band-pass with its −3 dB points at 106 kHz and 502 kHz (ngspice, SENSOR IN to ADC). Total gain at 250 kHz is 12.3 dB (×4.1): the gain stage’s 4.9, less the filter and driver losses. Loss at 10 kHz is 40.5 dB and
at 2 MHz 24 dB.

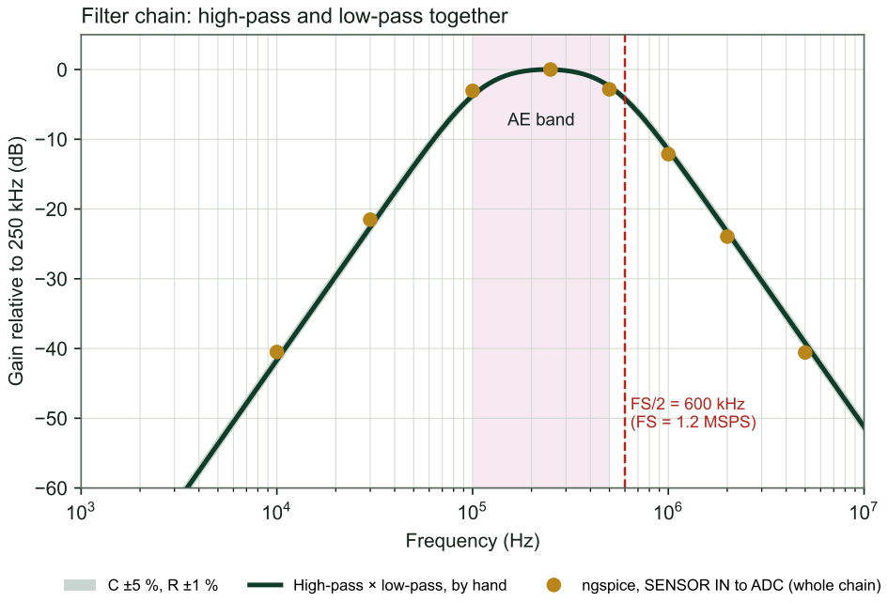
[picture p26: figure]
Frequency (Hz); Gain relative to 250 kHz (dB); FS/2 = 600 kHz (FS = 1.2 MSPS); AE band

Filter chain: high-pass and low-pass together

C ±5 %, R ±1 % | High-pass × low-pass, by hand | ngspice, SENSOR IN to ADC (whole chain)

The hand model (high-pass times low-pass) and the full ngspice chain agree within 1.1 dB at every point shown.

## 5 Tolerances

C0G capacitors ±5 % (C14858), resistors ±1 % (C4190). Over all 16 corners:

f0 = 482 to 544 kHz, Q = 0.673 to 0.743.

The upper corner moves about ±6 % and stays above the band edge. Q changes the shape slightly, with at most about 0.4 dB of droop near the corner.
