auselia/adc_test_board/doc/notes/slides/common.tex

\usepackage[margin=2.2cm]{geometry}
\usepackage{amsmath,amssymb}
\usepackage{siunitx}
\usepackage{booktabs}
\usepackage{xcolor}
\usepackage{microtype}
\usepackage{enumitem}
\usepackage{tcolorbox}
\usepackage{graphicx}
\definecolor{ink}{HTML}{14231B}\definecolor{accent}{HTML}{0F3D2A}
\tcbuselibrary{skins}
\newtcolorbox{key}{colback=accent!6,colframe=accent,boxrule=0.6pt,arc=2pt,left=6pt,right=6pt,top=4pt,bottom=4pt}
\sisetup{per-mode=symbol,group-separator={\,}}
\setlength{\parindent}{0pt}\setlength{\parskip}{6pt}
\renewcommand{\arraystretch}{1.25}
