auselia/adc_test_board/doc/notes/slides/s08_circuit.pdf

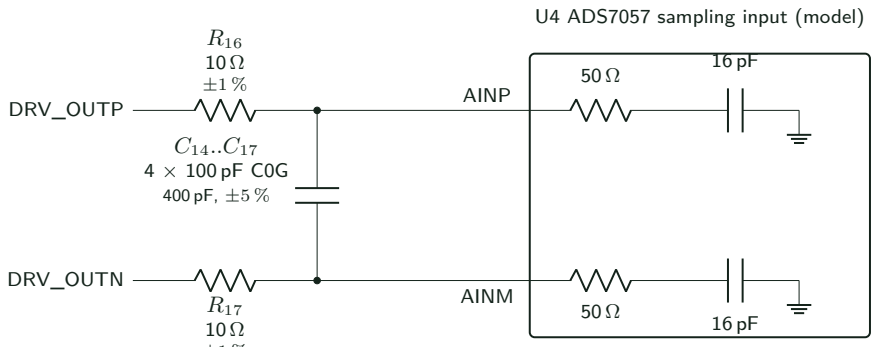
[picture p27: figure]
DRV_OUTP; DRV_OUTN; AINP; AINM; U4 ADS7057 sampling input (model)

±1 %
