auselia/adc_test_board/doc/notes/slides/s11_graph.pdf

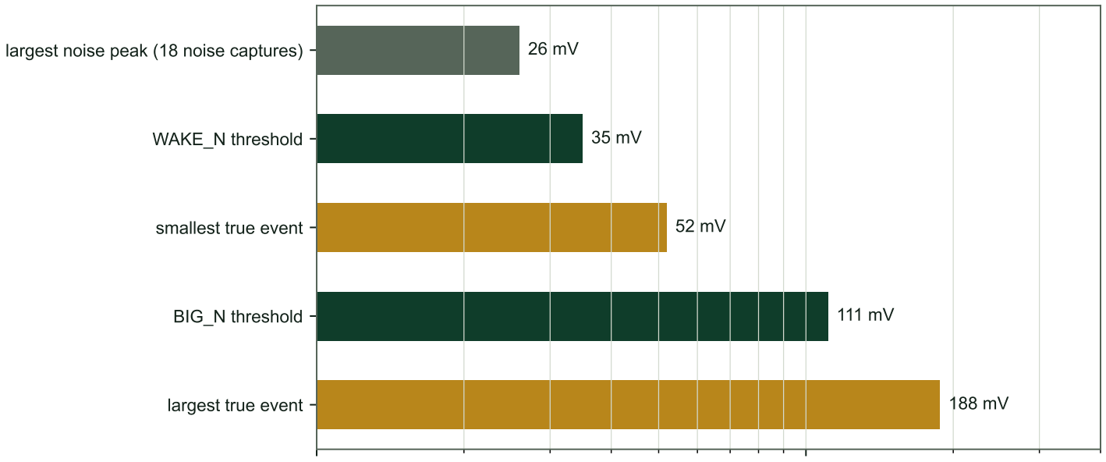
[picture p28: figure]
largest noise peak (18 noise captures); WAKE_N threshold; smallest true event; BIG_N threshold; largest true event

10

1 | 10

2
| Peak amplitude at SIG_IN (mV, log scale)

Listener thresholds against real captures (ESTIMATE, scaled to Cf 47 pF)
