auselia/adc_test_board/doc/assets/head_angled.jpg

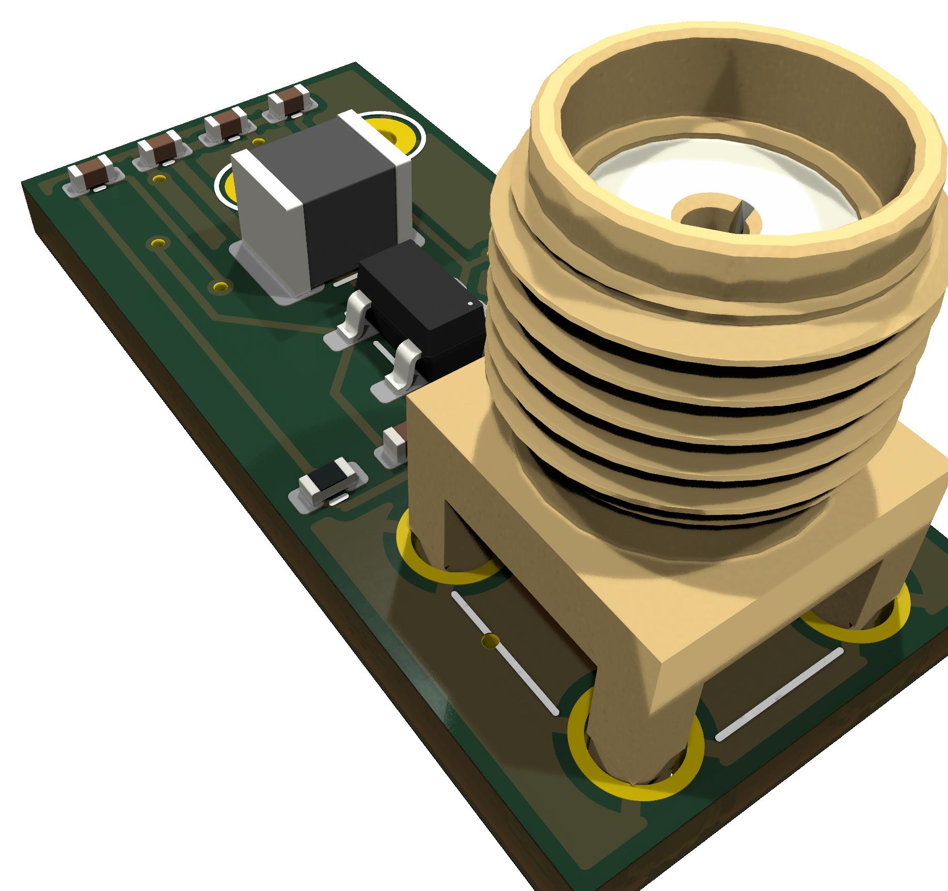
doc/assets/head_angled.jpg
