auselia/adc_test_board/doc/assets/head_back.png

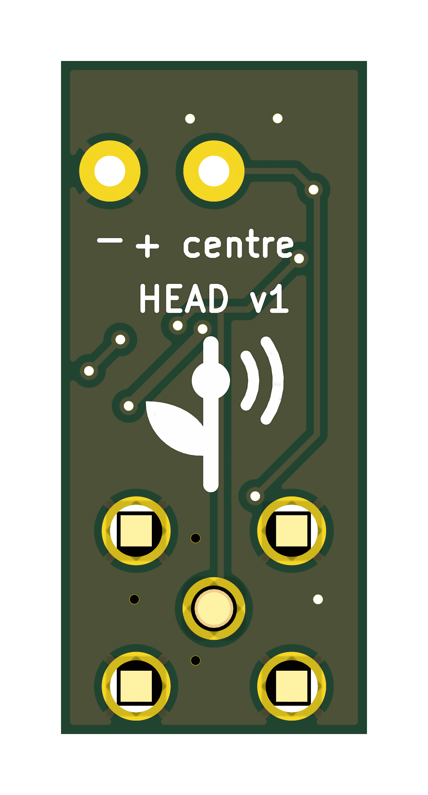
doc/assets/head_back.png
