auselia/adc_test_board/doc/assets/head_top.png

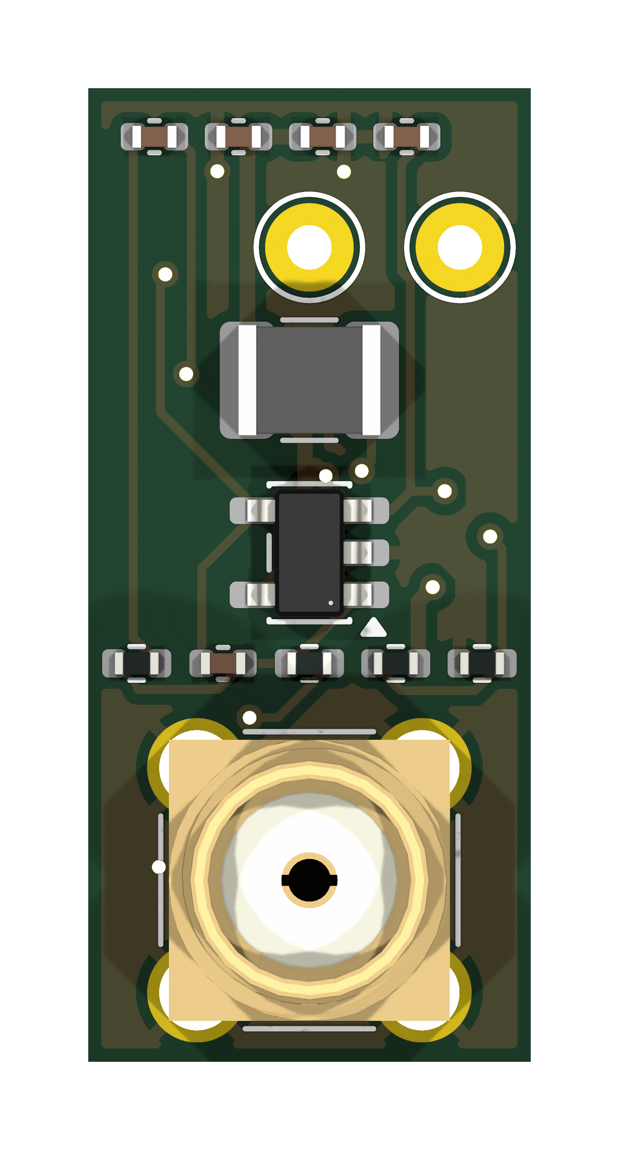
doc/assets/head_top.png
