auselia/adc_test_board/doc/assets/render_angled.jpg

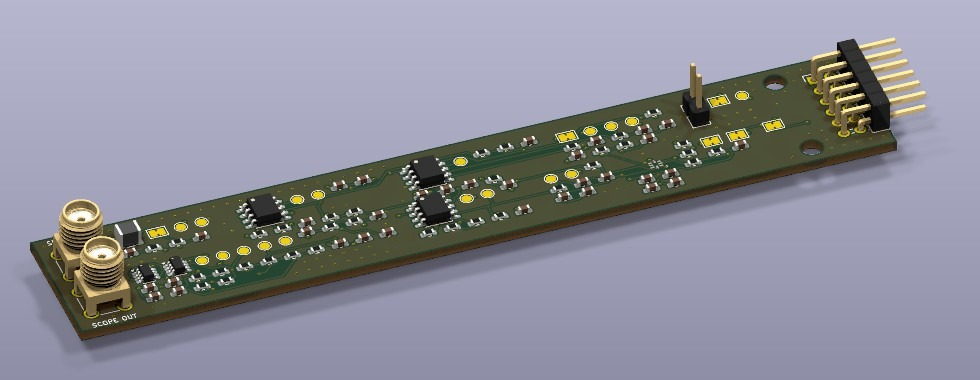
doc/assets/render_angled.jpg
