auselia/adc_test_board/doc/assets/render_top.jpg

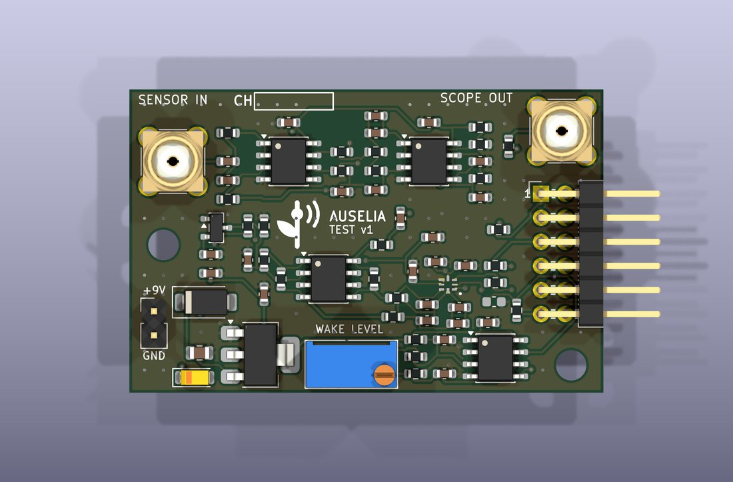
doc/assets/render_top.jpg
