auselia/adc_test_board/doc/assets/top_render.png

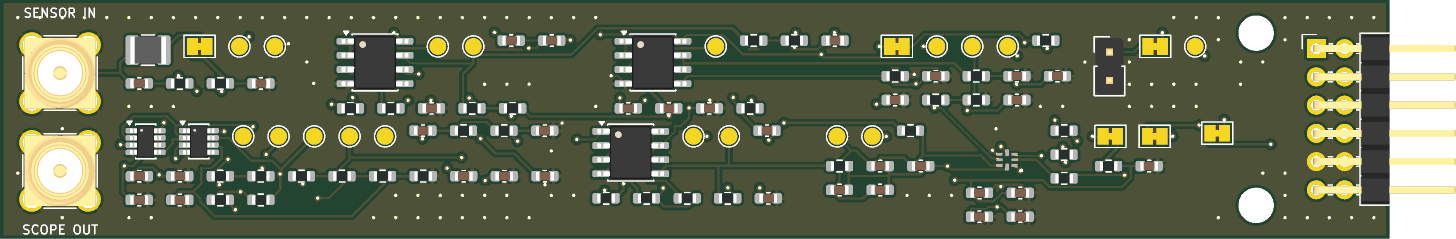
doc/assets/top_render.png
