auselia/adc_test_board/doc/notes/head_bode.png

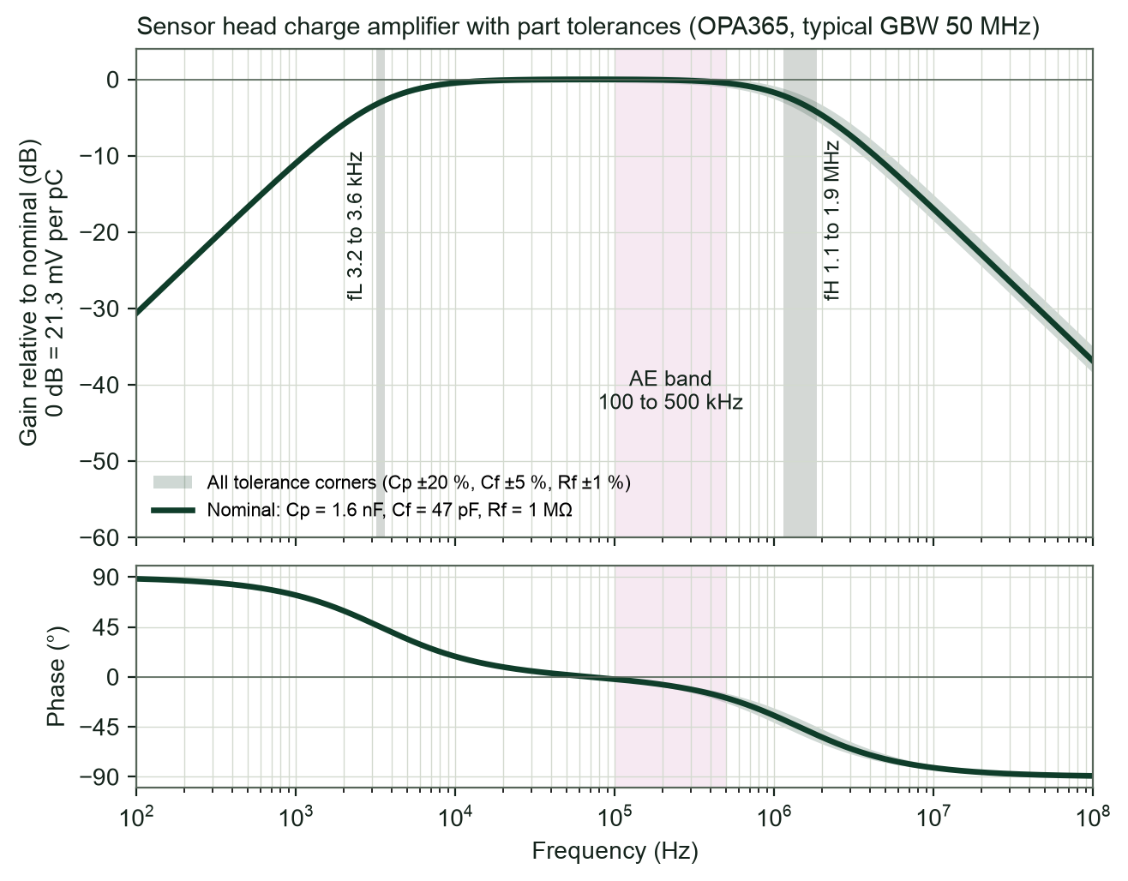
doc/notes/head_bode.png
