auselia/adc_test_board/doc/notes/head_circuit.png

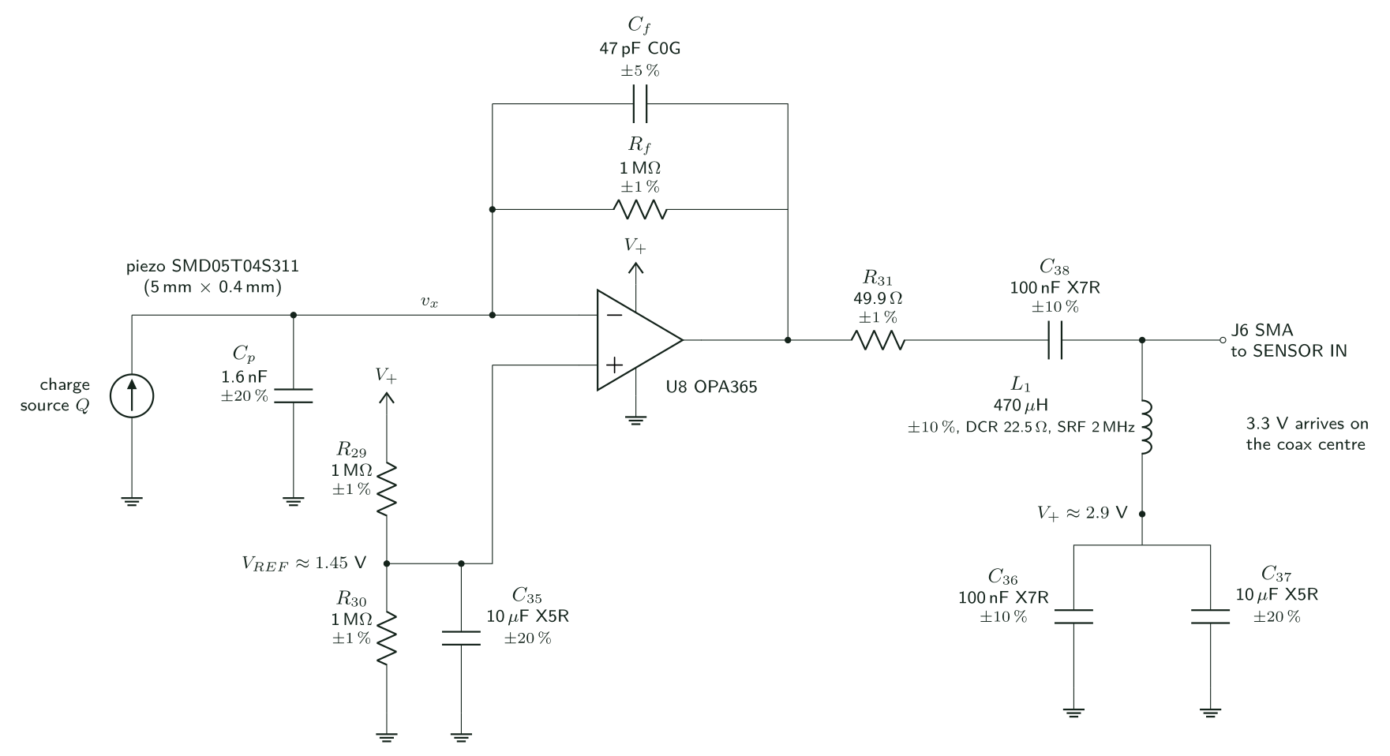
doc/notes/head_circuit.png
