auselia/adc_test_board/doc/notes/slides/s03_circuit.png

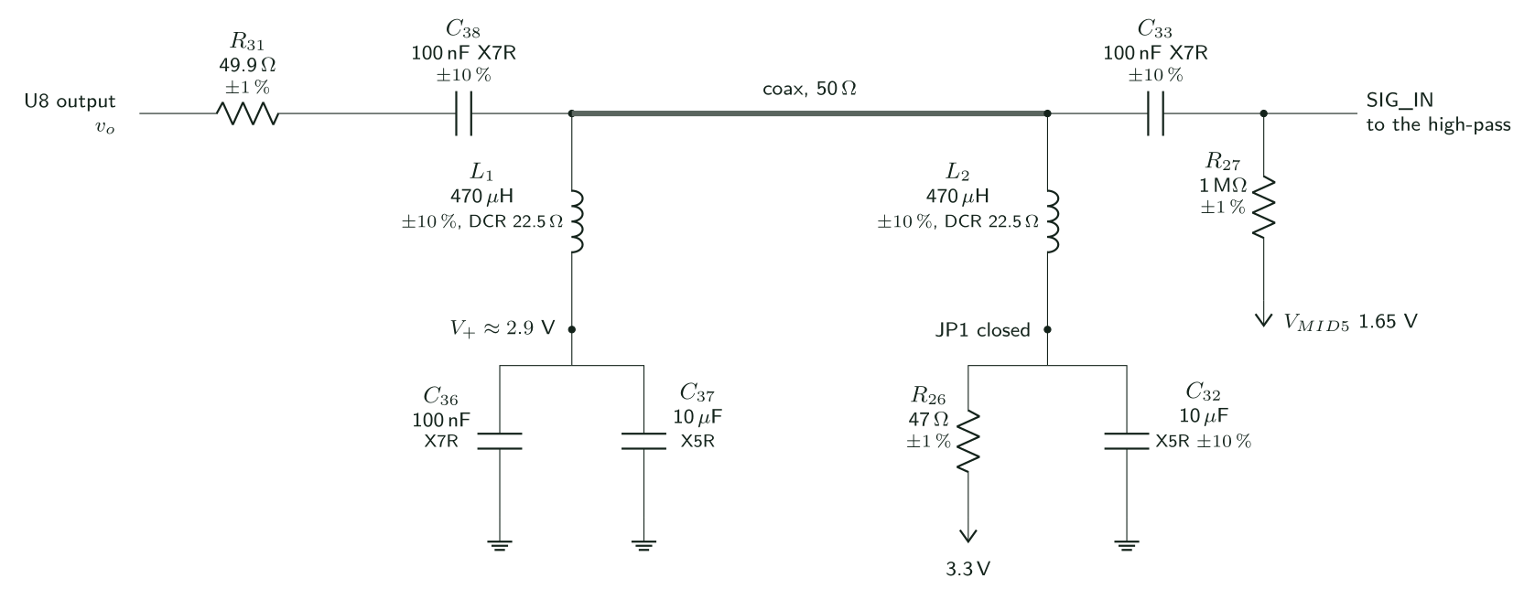
doc/notes/slides/s03_circuit.png
