auselia/adc_test_board/doc/notes/slides/s03_graph.png

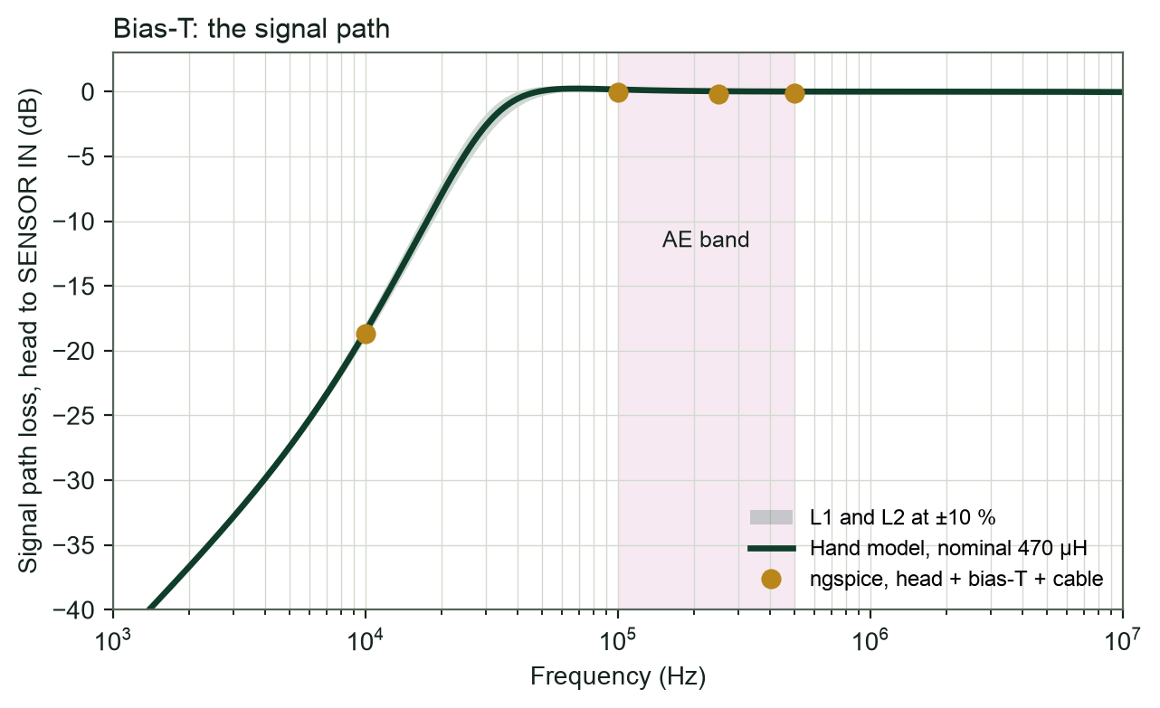
doc/notes/slides/s03_graph.png
