auselia/adc_test_board/doc/notes/slides/s04_graph.png

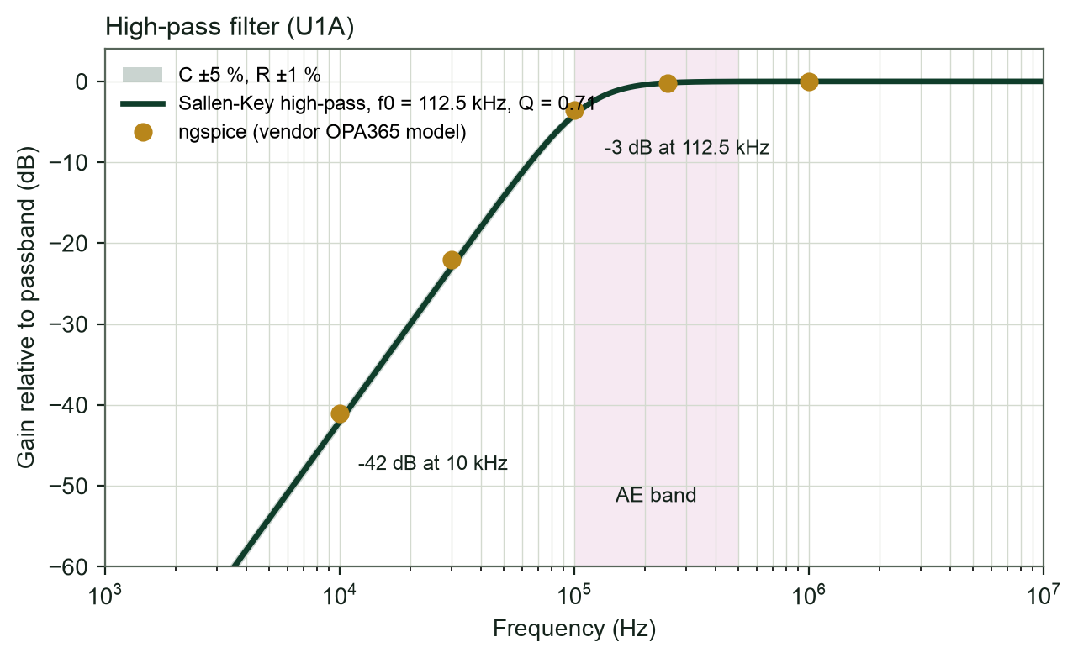
doc/notes/slides/s04_graph.png
