auselia/adc_test_board/doc/notes/slides/s05_graph.png

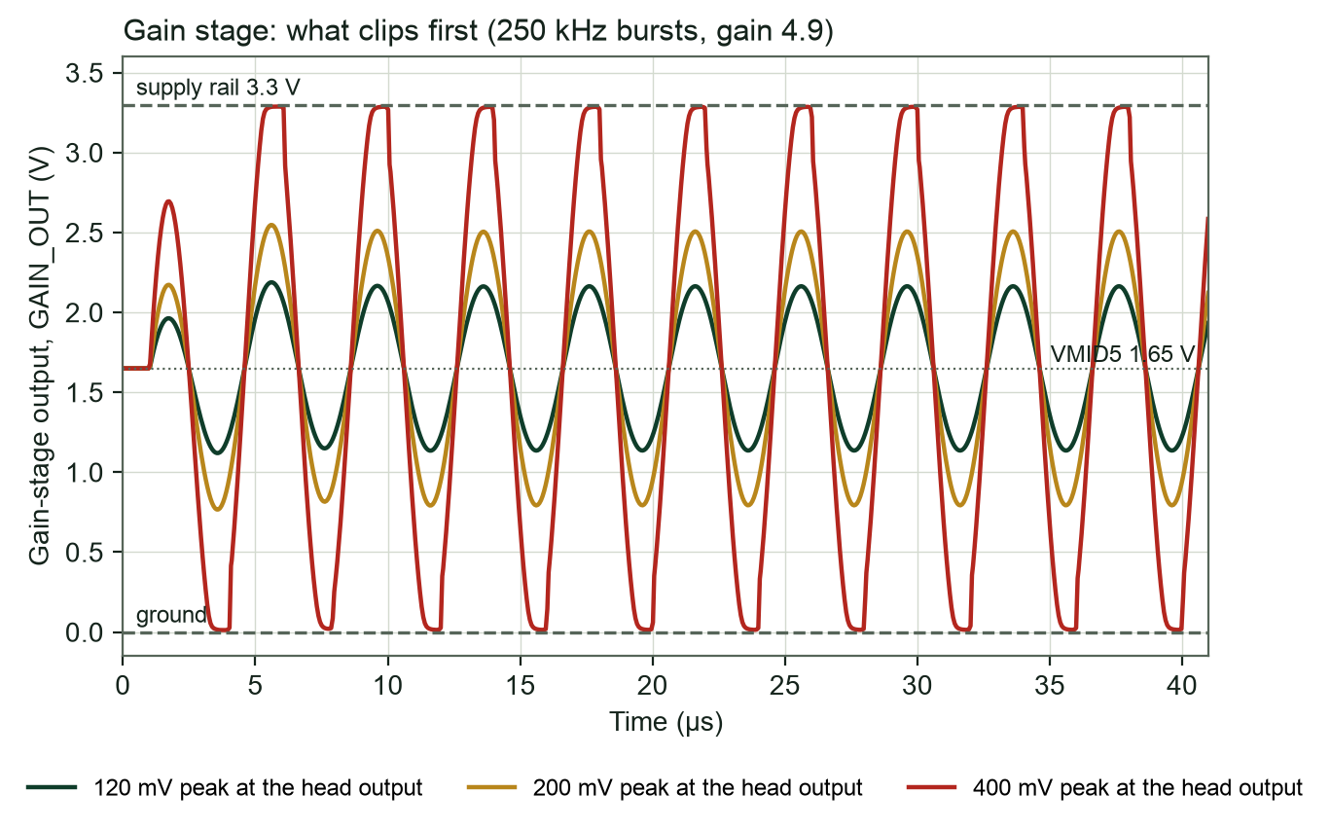
doc/notes/slides/s05_graph.png
