auselia/adc_test_board/doc/notes/slides/s06_graph.png

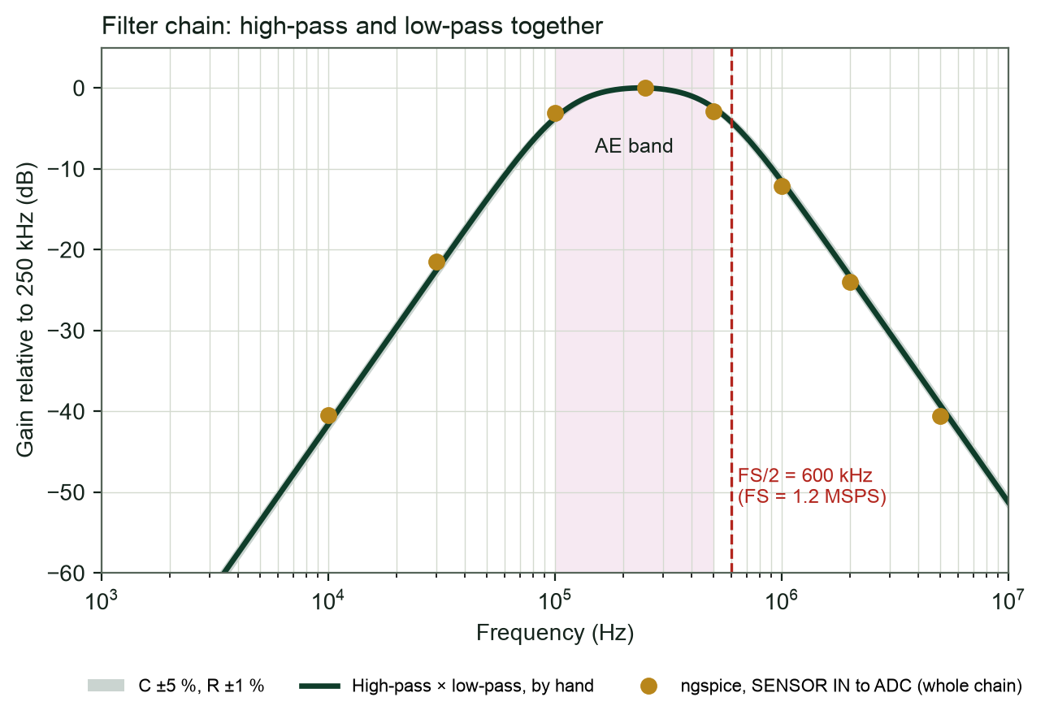
doc/notes/slides/s06_graph.png
