auselia/adc_test_board/doc/notes/slides/s07_graph.png

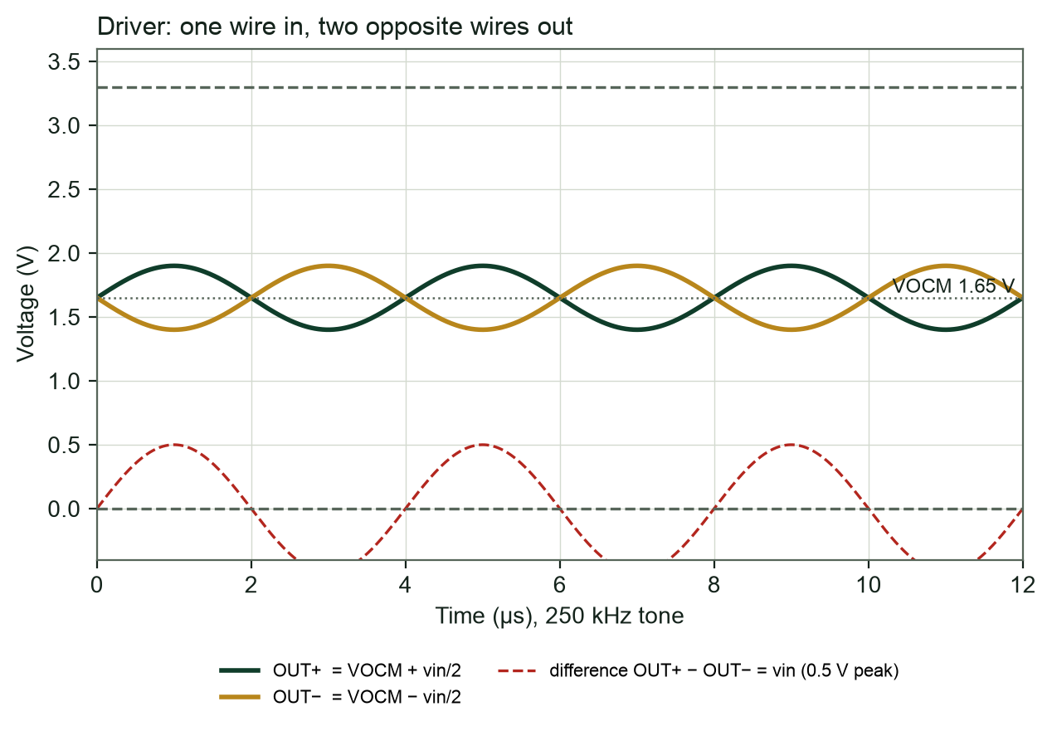
doc/notes/slides/s07_graph.png
