auselia/adc_test_board/doc/notes/slides/s08_circuit.png

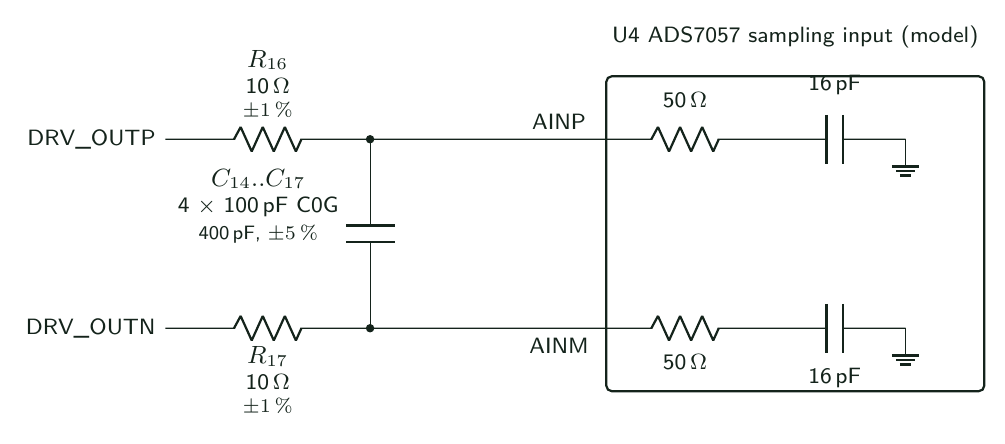
doc/notes/slides/s08_circuit.png
