auselia/adc_test_board/doc/notes/slides/s09_circuit.png

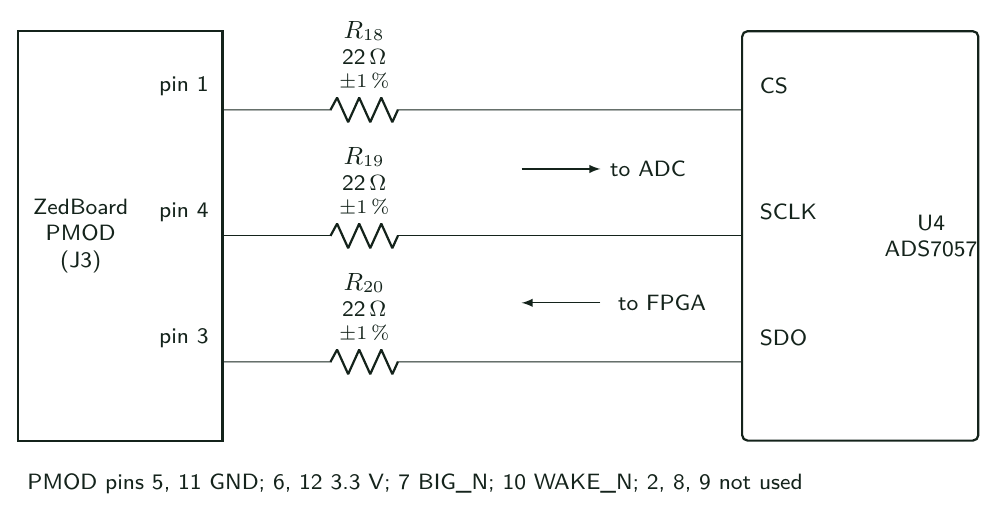
doc/notes/slides/s09_circuit.png
