auselia/adc_test_board/doc/notes/slides/s09_rate.png

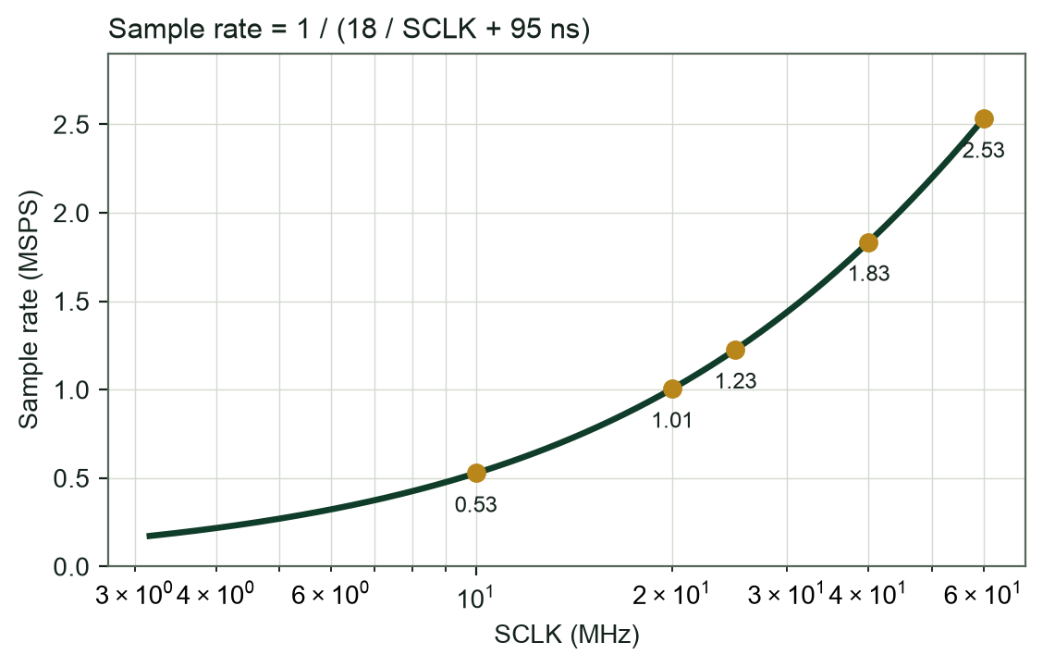
doc/notes/slides/s09_rate.png
