auselia/adc_test_board/doc/notes/slides/s10_avdd.png

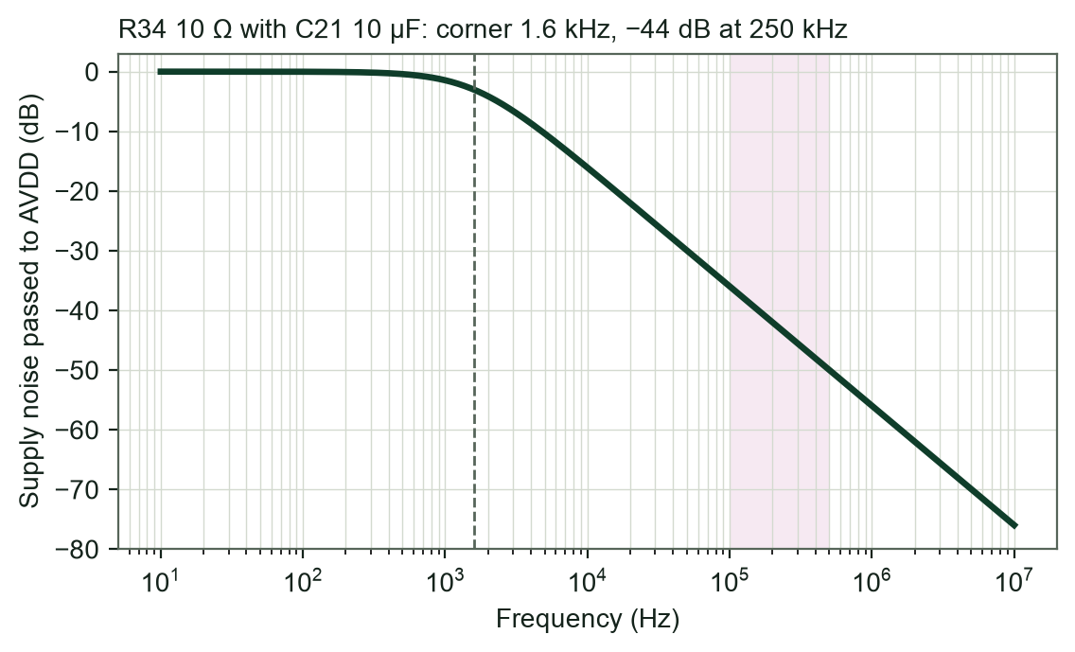
doc/notes/slides/s10_avdd.png
