auselia/adc_test_board/doc/notes/slides/s10_circuit.png

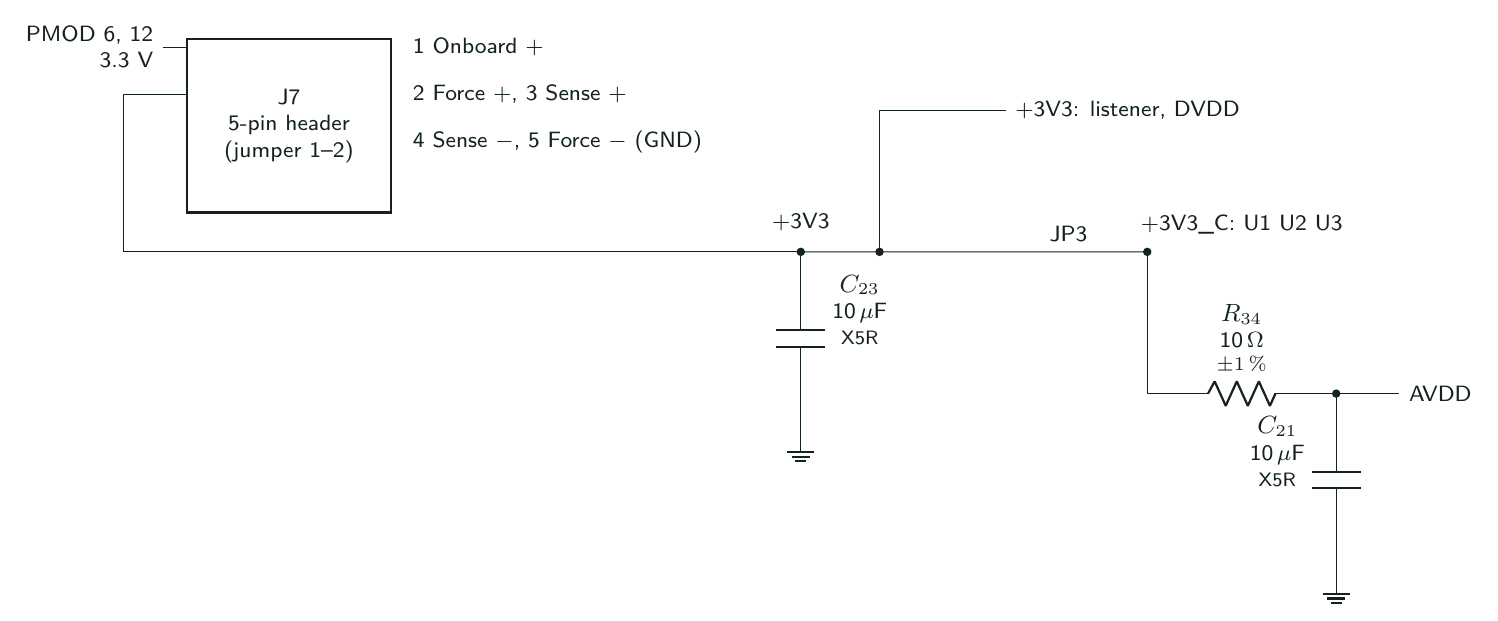
doc/notes/slides/s10_circuit.png
