auselia/adc_test_board/doc/notes/slides/s11_circuit.png

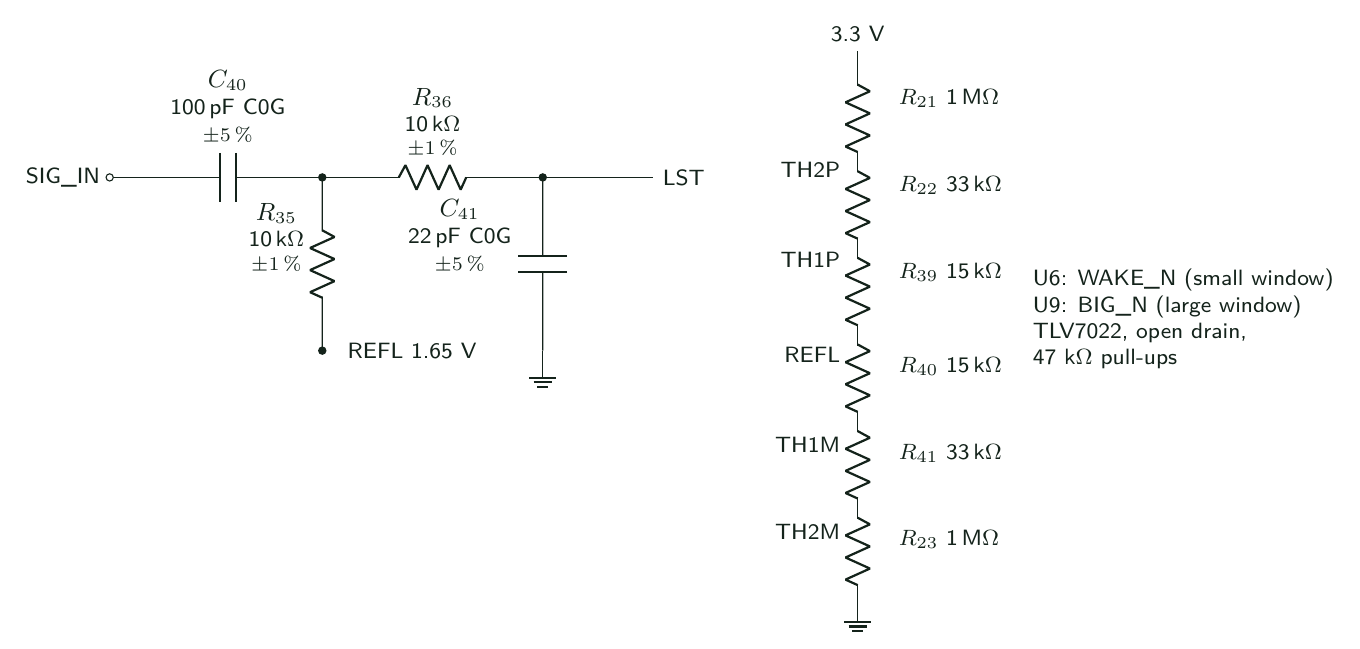
doc/notes/slides/s11_circuit.png
