auselia/adc_test_board/doc/notes/slides/s11_graph.png

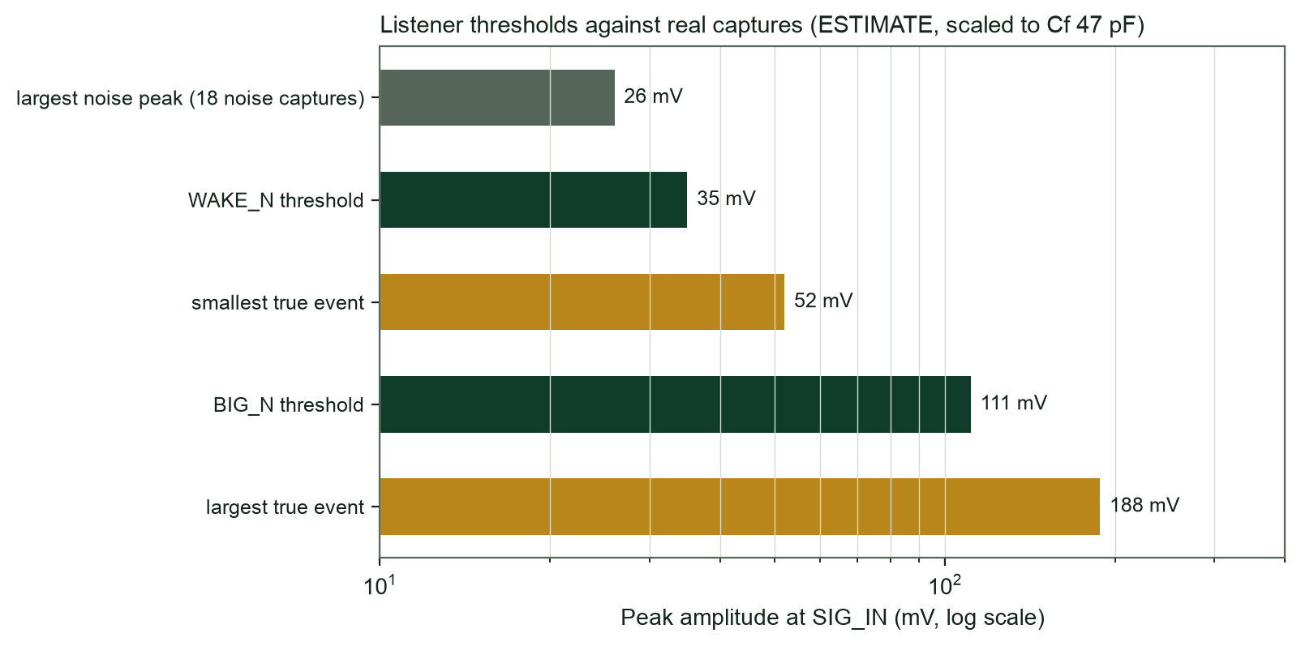
doc/notes/slides/s11_graph.png
