auselia/adc_test_board/doc/notes/slides/s12_circuit.png

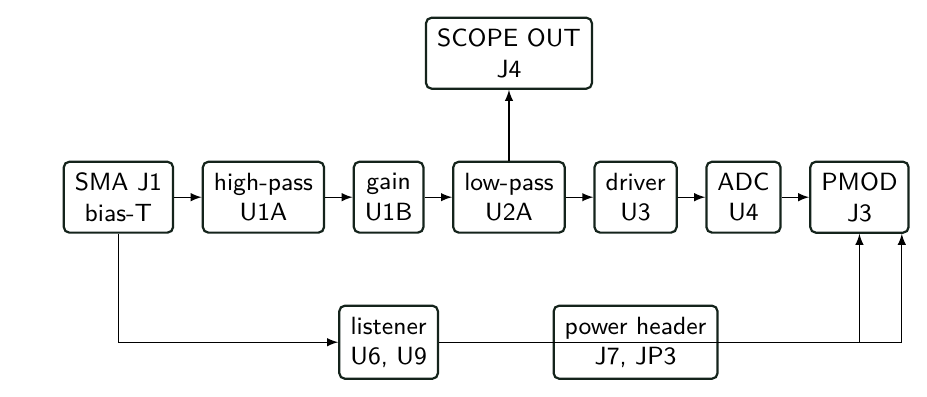
doc/notes/slides/s12_circuit.png
