auselia/adc_test_board/doc/notes/slides/s12_graph.png

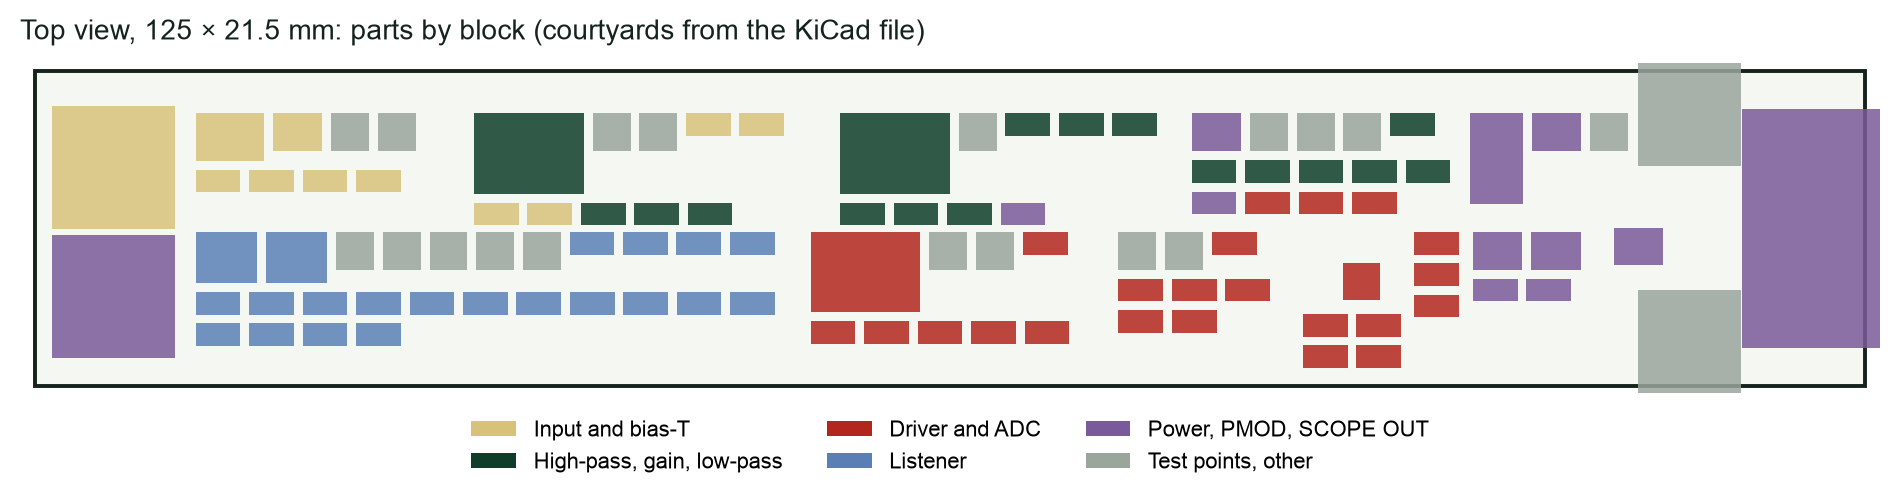
doc/notes/slides/s12_graph.png
