auselia/adc_test_board/doc/notes/slides/s13_circuit.png

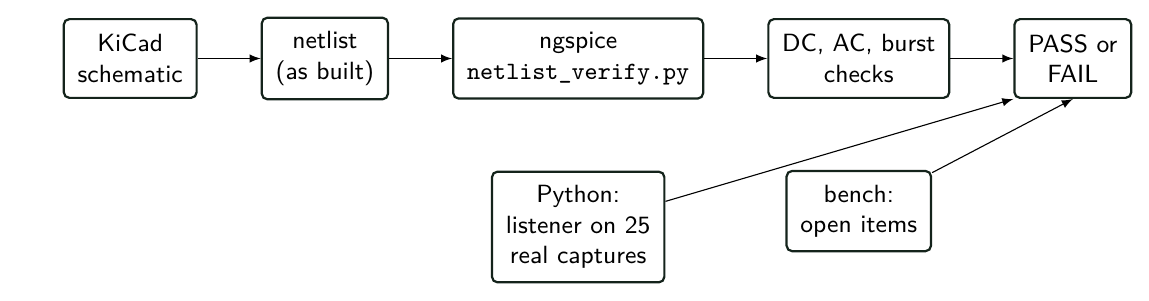
doc/notes/slides/s13_circuit.png
