auselia/adc_test_board/doc/notes/slides/s13_graph.png

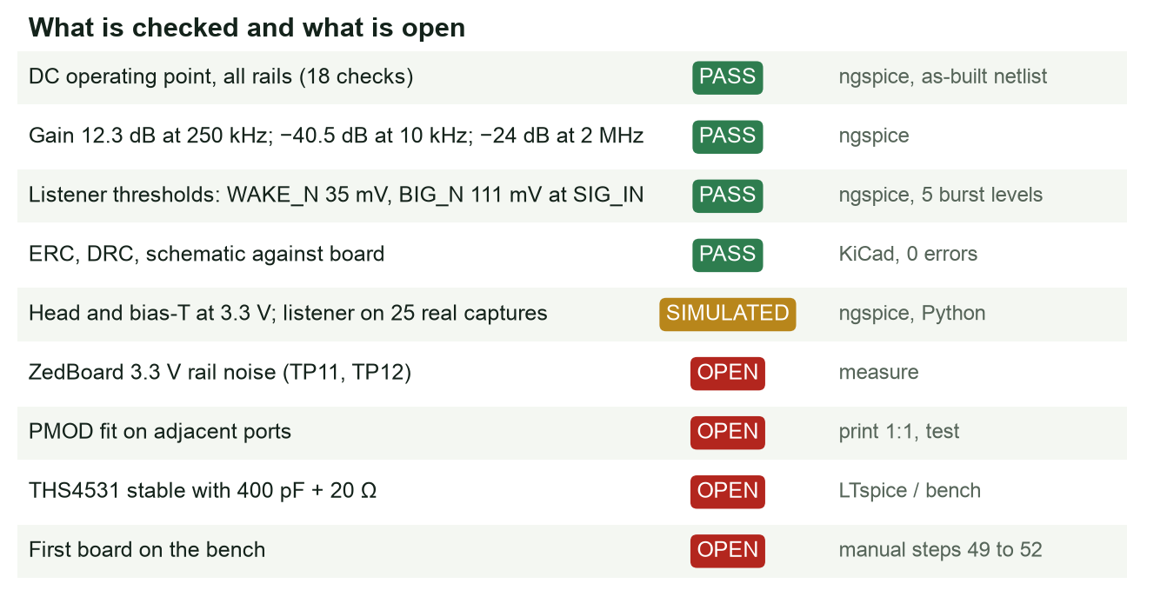
doc/notes/slides/s13_graph.png
