auselia/adc_test_board/hw/backplane/out/BP16_view.png

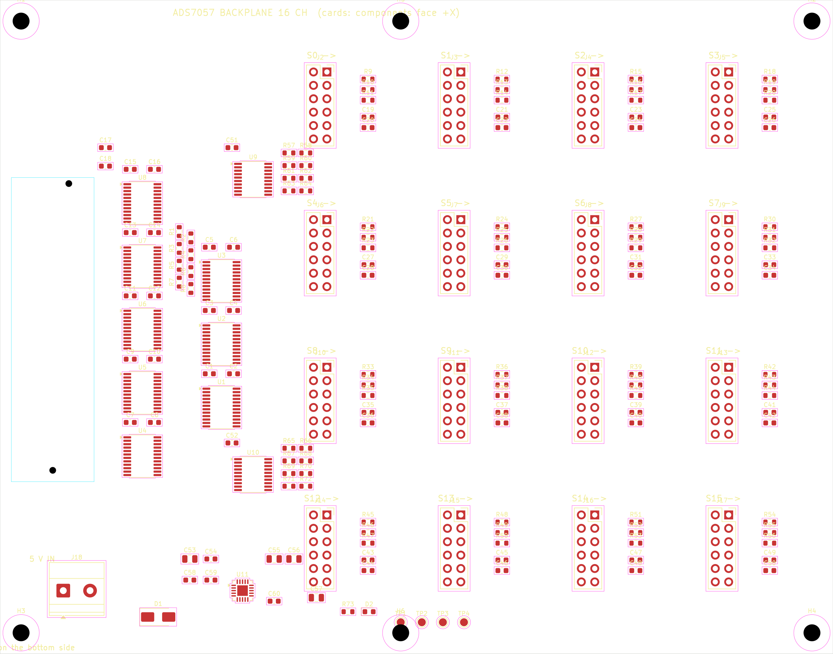
hw/backplane/out/BP16_view.png
