auselia/adc_test_board/hw/backplane/out/BP_Module_view-1.png

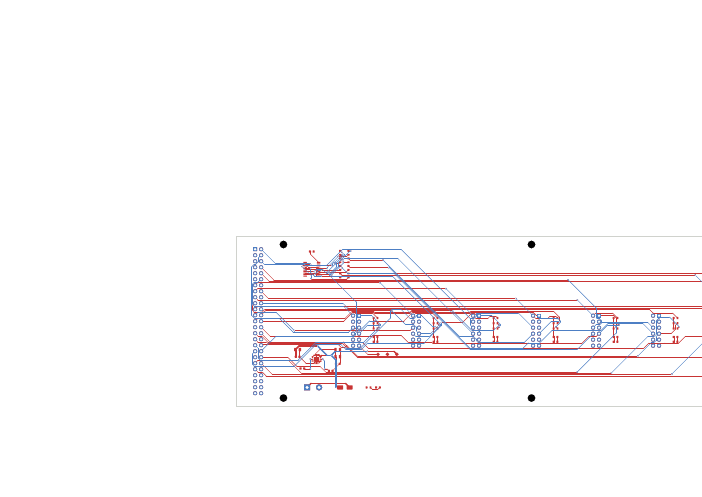
hw/backplane/out/BP_Module_view-1.png
