auselia/adc_test_board/hw/backplane/out/BP_Module_view.png

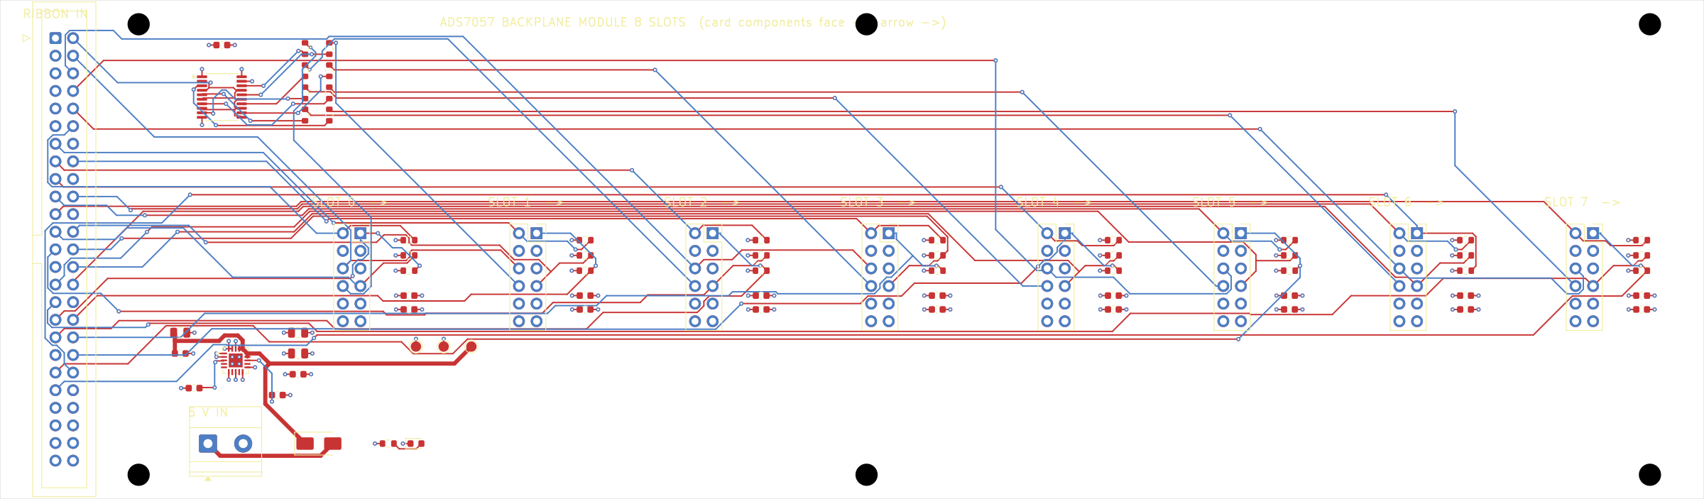
hw/backplane/out/BP_Module_view.png
