auselia/adc_test_board/hw/backplane/out/FMC_Adapter_view.png

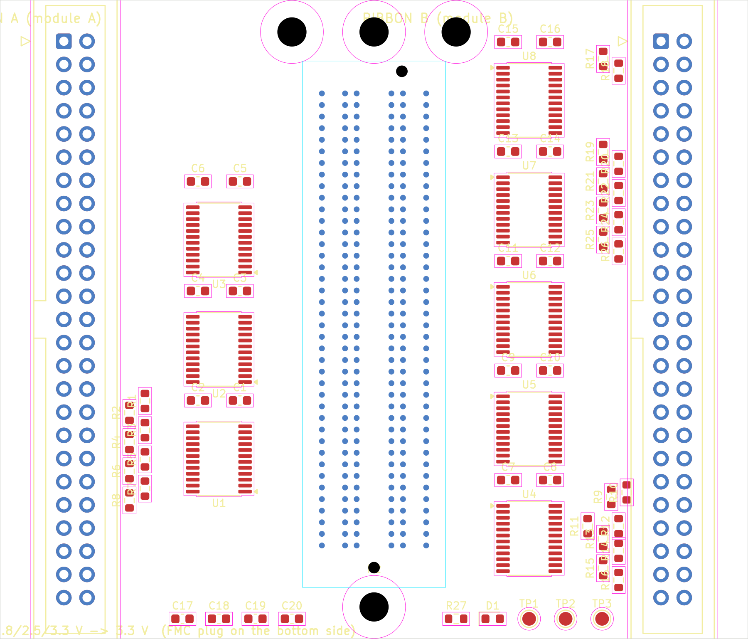
hw/backplane/out/FMC_Adapter_view.png
