auselia/adc_test_board/hw/backplane/out/mod_left.png

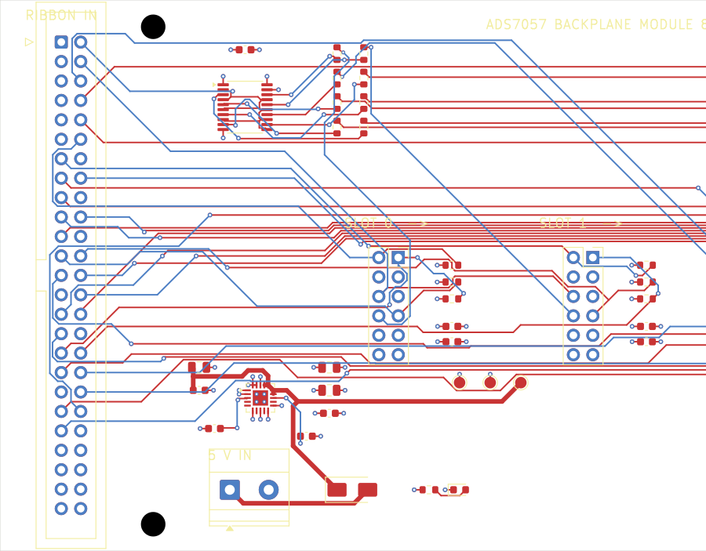
hw/backplane/out/mod_left.png
