auselia/adc_test_board/hw/backplane/out/pg-1.png

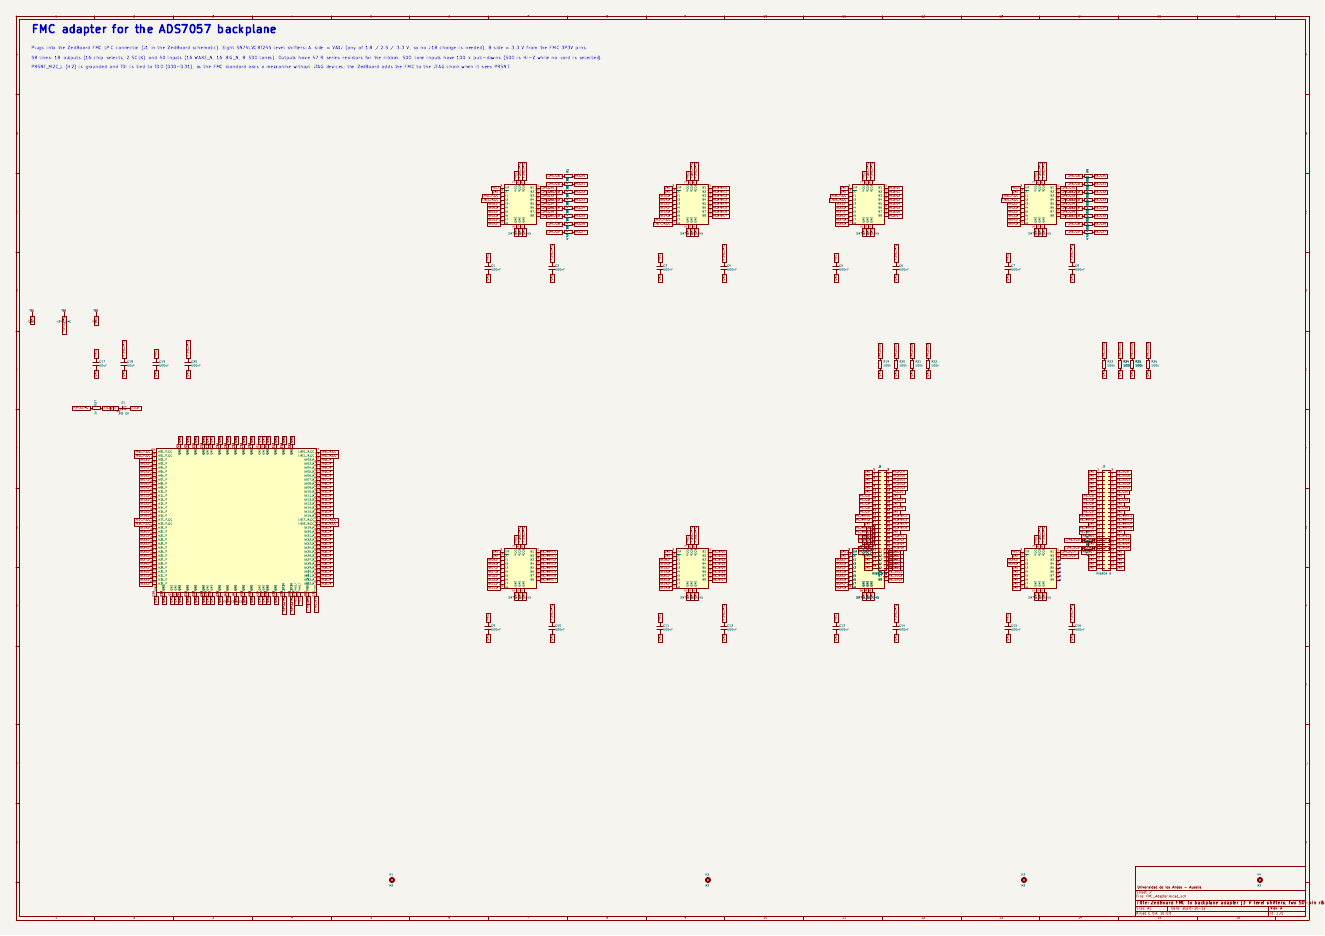
hw/backplane/out/pg-1.png
