auselia/adc_test_board/hw/backplane/out/pgb-1.png

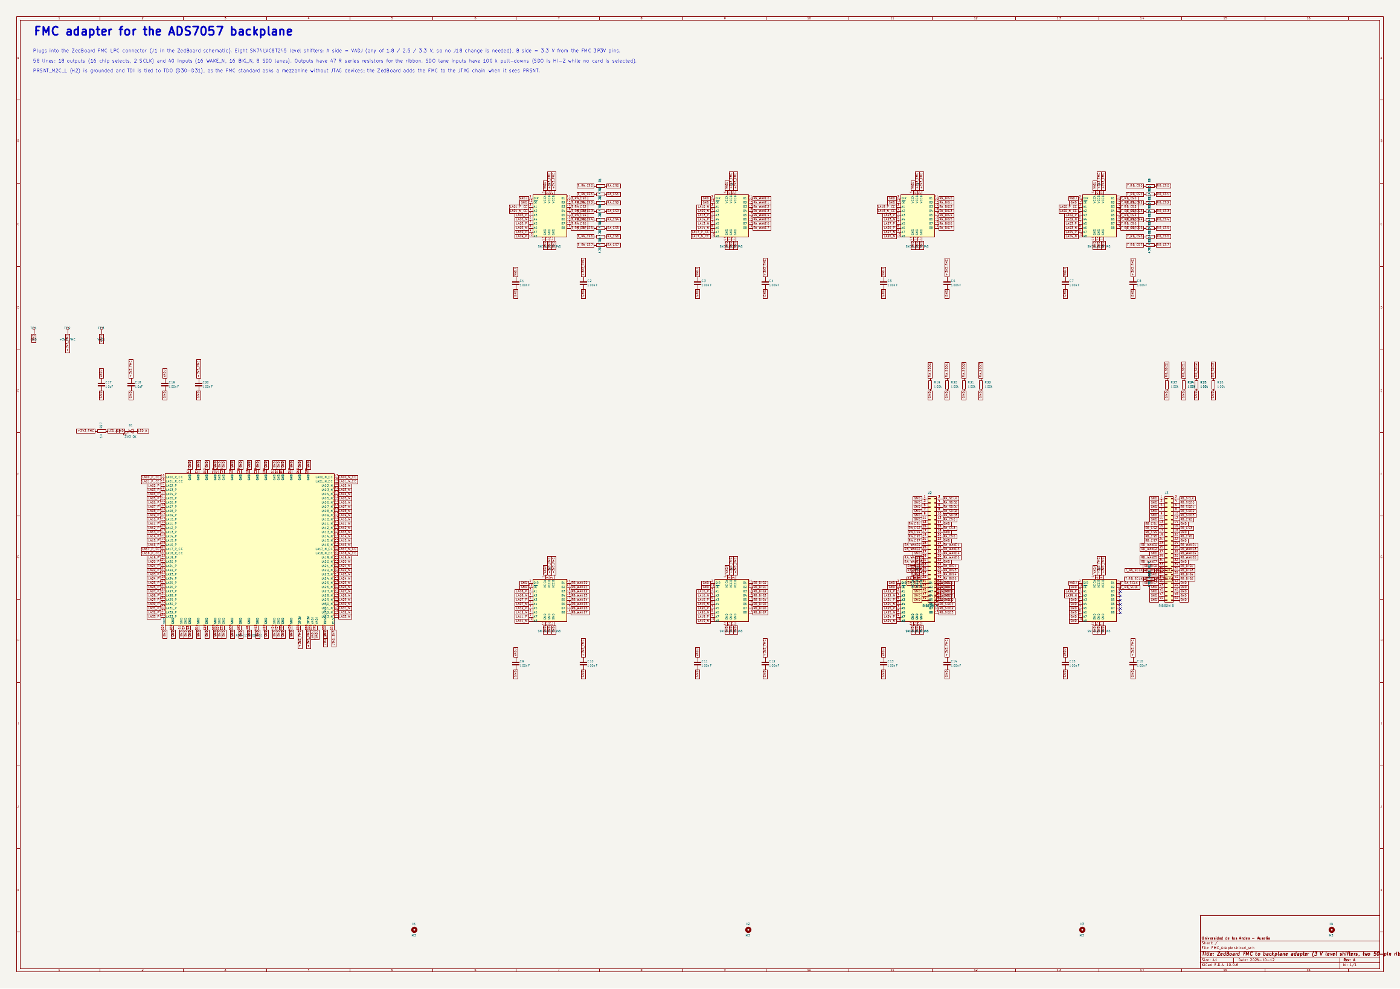
hw/backplane/out/pgb-1.png
