auselia/adc_test_board/hw/preview/ADC_Head_render_angled.png

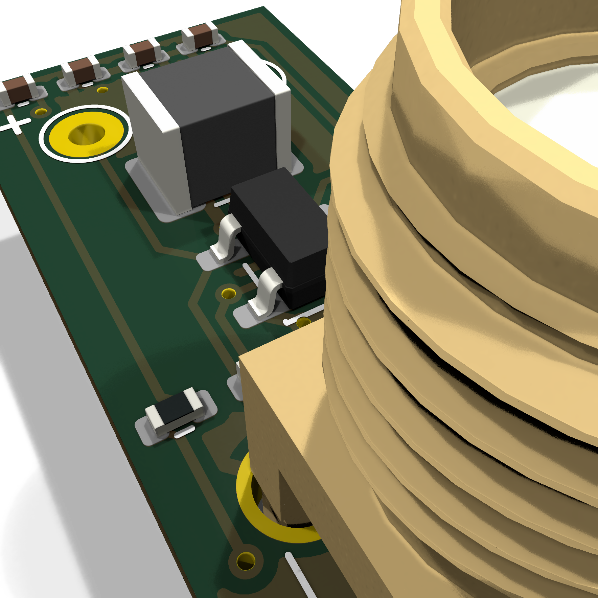
hw/preview/ADC_Head_render_angled.png
