auselia/adc_test_board/hw/preview/ADC_Head_render_top.png

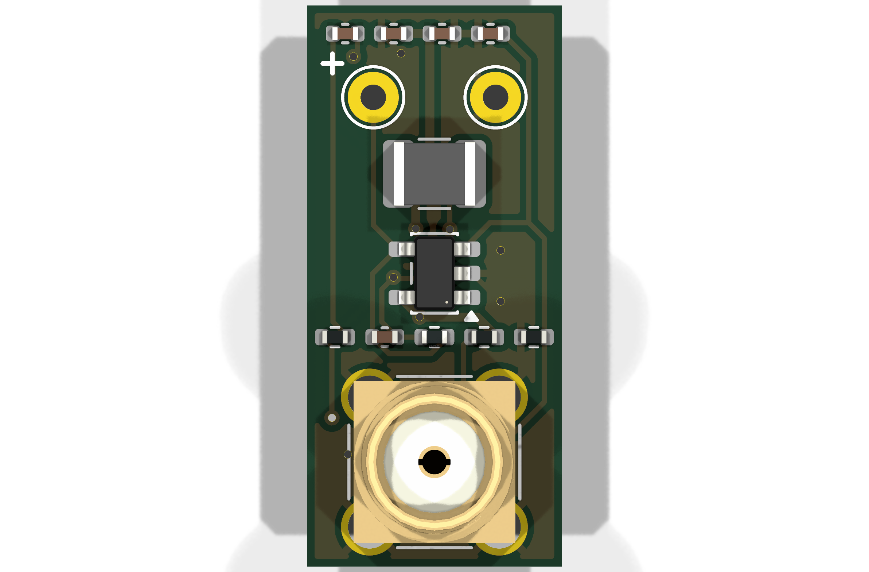
hw/preview/ADC_Head_render_top.png
