auselia/adc_test_board/hw/fab/ADC_Test_BOM_JLC.csv

Comment | Designator | Footprint | LCSC Part #
100pF C0G | C1,C2,C4,C5,C6,C14,C15,C16,C17,C40 | C_0603_1608Metric | C14858
100nF | C3,C9,C10,C12,C20,C22,C26,C27,C28,C33,C43,C44,C45 | C_0603_1608Metric | C14663
1uF | C7,C11,C13,C19,C42 | C_0603_1608Metric | C15849
10uF | C8,C21,C23,C32 | C_0603_1608Metric | C19702
4.7uF | C18 | C_0603_1608Metric | C19666
22pF C0G | C41 | C_0603_1608Metric | C1653
SMA jack | J1,J4 | SMA_Amphenol_132134-11_Vertical | C496549
Header 2x6 right angle | J3 | PinHeader_2x06_P2.54mm_Horizontal | C60565
Header 1x5 | J7 | PinHeader_1x05_P2.54mm_Vertical | C492404
470uH | L2 | L_1210_3225Metric | C75644
10k | R1,R7,R8,R35,R36 | R_0603_1608Metric | C25804
20k | R2 | R_0603_1608Metric | C4184
3.9k | R3 | R_0603_1608Metric | C23018
1.00k | R4,R10,R11,R12,R13,R14,R15 | R_0603_1608Metric | C21190
2.2k | R5,R6 | R_0603_1608Metric | C4190
10R | R9,R16,R17,R34 | R_0603_1608Metric | C22859
22R | R18,R19,R20 | R_0603_1608Metric | C23345
1M | R21,R23,R27 | R_0603_1608Metric | C22935
33k | R22,R41 | R_0603_1608Metric | C4216
47k | R24,R42 | R_0603_1608Metric | C25819
51R | R25 | R_0603_1608Metric | C23197
47R | R26 | R_0603_1608Metric | C23182
15k | R39,R40 | R_0603_1608Metric | C22809
OPA2365 | U1,U2 | SOIC-8_3.9x4.9mm_P1.27mm | C130011
THS4531 | U3 | SOIC-8_3.9x4.9mm_P1.27mm | C705347
ADS7057 | U4 | ADS7057_X2QFN-8_1.5x1.5mm | C2669902
TLV7022 | U6,U9 | SOT-23-8 | C2862588
