auselia/adc_test_board/hw/fab/ADC_Head_BOM_JLC.csv

Comment | Designator | Footprint | LCSC Part #
47pF C0G | C34 | C_0402_1005Metric | C1567
10uF | C35,C37 | C_0402_1005Metric | C15525
100nF | C36,C38 | C_0402_1005Metric | C307331
SMA jack | J6 | SMA_Amphenol_132134-11_Vertical | C496549
470uH | L1 | L_1210_3225Metric | C75644
1M | R28,R29,R30 | R_0402_1005Metric | C26083
49.9R | R31 | R_0402_1005Metric | C25120
OPA365 | U8 | SOT-23-5 | C96626
