auselia/adc_test_board/hw/backplane/fab/BP_Module_BOM_JLC.csv

Comment | Designator | Footprint | LCSC Part #
100nF | C1,C3,C5,C7,C9,C11,C13,C15,C17,C19,C22 | C_0603_1608Metric | C14663
10uF | C2,C4,C6,C8,C10,C12,C14,C16 | C_0603_1608Metric | C19702
22uF 25V | C18,C20,C21 | C_0805_2012Metric | C45783
10nF | C23,C24 | C_0603_1608Metric | C57112
SS14 | D1 | D_SMA | C2480
3V3 OK | D2 | LED_0603_1608Metric | C2286
IDC box header 2x25 | J1 | IDC-Header_2x25_P2.54mm_Vertical | C19193816
Socket 2x6 2.54 mm | J2,J3,J4,J5,J6,J7,J8,J9 | PinSocket_2x06_P2.54mm_Vertical | C36191
Screw terminal 5.08 mm 2P | J10 | TerminalBlock_Phoenix_MKDS-1,5-2-5.08_1x02_P5.08mm_Horizontal | C8465
22R | R1,R2,R3,R4,R5,R6,R7,R8 | R_0603_1608Metric | C23345
100k | R9,R10,R11,R12,R13,R14,R15,R16,R17,R18,R19,R20,R21,R22,R23,R24,R25,R26,R27,R28,R29,R30,R31,R32 | R_0603_1608Metric | C25803
1k | R33 | R_0603_1608Metric | C21190
SN74LVC244A | U1 | TSSOP-20_4.4x6.5mm_P0.65mm | C7668
TPS7A8300 | U2 | QFN-20-1EP_3.5x3.5mm_P0.5mm_EP2x2mm | C544500
