auselia/adc_test_board/hw/backplane/fab/FMC_Adapter_BOM_JLC.csv

Comment | Designator | Footprint | LCSC Part #
100nF | C1,C2,C3,C4,C5,C6,C7,C8,C9,C10,C11,C12,C13,C14,C15,C16,C19,C20 | C_0603_1608Metric | C14663
10uF | C17,C18 | C_0603_1608Metric | C19702
3V3 OK | D1 | LED_0603_1608Metric | C2286
FMC plug ASP-134602-01 | J1 | ASP-134602-01_LPC | C2875619
IDC box header 2x25 | J2,J3 | IDC-Header_2x25_P2.54mm_Vertical | C19193816
47R | R1,R2,R3,R4,R5,R6,R7,R8,R9,R10,R11,R12,R13,R14,R15,R16,R17,R18 | R_0603_1608Metric | C23182
100k | R19,R20,R21,R22,R23,R24,R25,R26 | R_0603_1608Metric | C25803
1k | R27 | R_0603_1608Metric | C21190
SN74LVC8T245 | U1,U2,U3,U4,U5,U6,U7,U8 | TSSOP-24_4.4x7.8mm_P0.65mm | C27643
