auselia/adc_test_board/hw/preview/ADC_Head_print_1to1_letter.pdf

AUSELIA / ADS7057 test board, sensor head / 1:1 print

# Top side: pads and silkscreen

Place the real parts on the pads to check every footprint before you order.

Print at 100 % (actual size). Do not use "fit to page". The bar below must measure 100 mm.

0 | 50 mm | 100 mm

Board outline 10.0 x 22.0 mm. The SMA J6 stands on this side, the piezo goes on the other face.

ADS7057 test board, sensor head / commit 96eed23 / 2026-10-15

# Top side: pads and reference designators

Use it to find a part. The names are the same as in the schematic and the BOM.

Print at 100 % (actual size). Do not use "fit to page". The bar below must measure 100 mm.

0 | 50 mm | 100 mm

Board outline 10.0 x 22.0 mm. The SMA J6 stands on this side, the piezo goes on the other face.

# Bottom side, seen from below (mirrored)

Only the through-hole pins and the ground pour are on this side (on the head board: the face the piezo sits on).

Print at 100 % (actual size). Do not use "fit to page". The bar below must measure 100 mm.

0 | 50 mm | 100 mm

Board outline 10.0 x 22.0 mm. The SMA J6 stands on this side, the piezo goes on the other face.
