auselia/adc_test_board/hw/preview/ADC_Test_print_1to1_letter.pdf

# Top side: pads and silkscreen

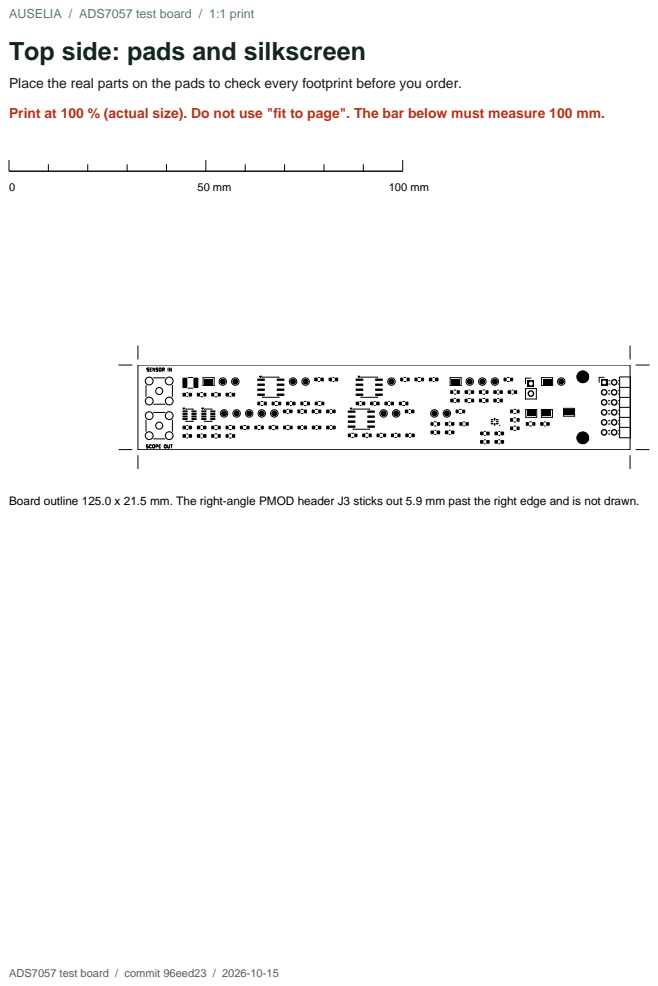
[picture p208: page 1]

AUSELIA / ADS7057 test board / 1:1 print

Place the real parts on the pads to check every footprint before you order.
Print at 100 % (actual size). Do not use "fit to page". The bar below must measure 100 mm.

Board outline 125.0 x 21.5 mm. The right-angle PMOD header J3 sticks out 5.9 mm past the right edge and is not drawn.

ADS7057 test board / commit 96eed23 / 2026-10-15

# Top side: pads and reference designators

Use it to find a part. The names are the same as in the schematic and the BOM.

Print at 100 % (actual size). Do not use "fit to page". The bar below must measure 100 mm.

0 | 50 mm | 100 mm

Board outline 125.0 x 21.5 mm. The right-angle PMOD header J3 sticks out 5.9 mm past the right edge and is not drawn.

# Bottom side, seen from below (mirrored)

Only the through-hole pins and the ground pour are on this side (on the head board: the face the piezo sits on).

Print at 100 % (actual size). Do not use "fit to page". The bar below must measure 100 mm.

0 | 50 mm | 100 mm

Board outline 125.0 x 21.5 mm. The right-angle PMOD header J3 sticks out 5.9 mm past the right edge and is not drawn.
