auselia/adc_test_board/doc/bringup/fig_setup.png

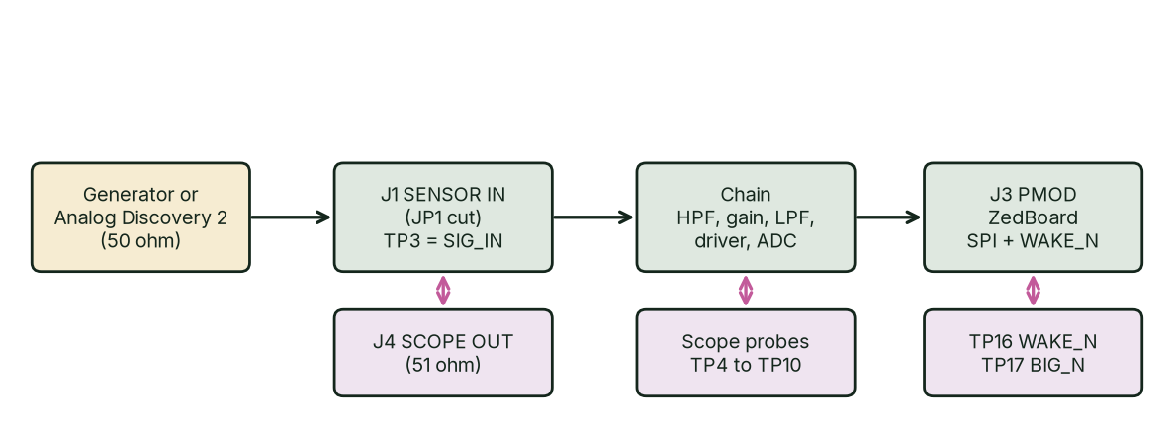
doc/bringup/fig_setup.png
