auselia/adc_test_board/doc/bringup/main.tex

\documentclass[10.5pt,a4paper]{article}
\usepackage[margin=2.3cm,top=2.6cm,bottom=2.4cm]{geometry}
\usepackage{fontspec}
\setmainfont{Inter-Regular.ttf}[Path=../fonts/,BoldFont=Inter-SemiBold.ttf,ItalicFont=Inter-Italic.ttf]
\newfontfamily\titlefont{SpaceGrotesk-Bold.ttf}[Path=../fonts/]
\setmonofont{IBMPlexMono-Regular.ttf}[Path=../fonts/,Scale=0.88]
\usepackage{amsmath,amssymb}
\usepackage{float}\usepackage{xcolor,tikz,graphicx,booktabs,enumitem,tcolorbox,fancyhdr,titlesec,caption,array,microtype,siunitx}
\usetikzlibrary{calc}
\tcbuselibrary{skins}
\sisetup{per-mode=symbol}
\definecolor{ink}{HTML}{1A1A1A}\definecolor{dark}{HTML}{14261C}\definecolor{amber}{HTML}{E8A13A}\definecolor{grn}{HTML}{1B3A2B}\definecolor{mut}{HTML}{5C7A63}\definecolor{bone}{HTML}{F4F1EA}\definecolor{bonetwo}{HTML}{EDE8DC}\definecolor{sap}{HTML}{A9C7A0}
\definecolor{okbg}{HTML}{E1EBDB}\definecolor{badbg}{HTML}{F6E4C4}\definecolor{noteb}{HTML}{EDE8DC}
\color{ink}
\setlength{\parindent}{0pt}\setlength{\parskip}{6pt}\renewcommand{\arraystretch}{1.25}
\titleformat{\section}{\Large\bfseries\color{grn}}{\thesection}{0.7em}{}
\titleformat{\subsection}{\large\bfseries\color{grn}}{\thesubsection}{0.6em}{}
\titlespacing*{\section}{0pt}{16pt}{6pt}\titlespacing*{\subsection}{0pt}{12pt}{4pt}
\captionsetup{font={small},labelfont=bf,labelsep=period,justification=raggedright,singlelinecheck=false}
% Auselia mark: the brand SVGs converted to PDF (platform/brand/mark/svg), never redrawn
\newcommand{\lm}{}
\newcommand{\lmr}[1][1.25cm]{}
\pagestyle{fancy}\fancyhf{}
\renewcommand{\headrulewidth}{0pt}
\newcommand{\faintmark}{\tikz[baseline=-0.9mm]\node[opacity=0.45,inner sep=0]{};}
\fancyfoot[L]{\faintmark\hspace{0.7em}{\ttfamily\fontsize{6.6}{8}\selectfont\color{mut}AUSELIA\ \ /\ \ AFE V1\ \ /\ \ BRING-UP GUIDE\ \ /\ \ VERSION 0.1}}
\fancyfoot[R]{{\ttfamily\fontsize{6.6}{8}\selectfont\color{mut}\thepage}}
\newenvironment{pass}{\begin{tcolorbox}[colback=okbg,colframe=grn,boxrule=0.5pt,arc=2pt,left=6pt,right=6pt,top=3pt,bottom=3pt,title={\textbf{Pass}},coltitle=white,fonttitle=\small,attach boxed title to top left={yshift=-2mm,xshift=2mm},boxed title style={colback=grn,arc=1pt}]}{\end{tcolorbox}}
\newenvironment{fail}{\begin{tcolorbox}[colback=badbg,colframe=amber!85!black,boxrule=0.5pt,arc=2pt,left=6pt,right=6pt,top=3pt,bottom=3pt,title={\textbf{If not}},coltitle=white,fonttitle=\small,attach boxed title to top left={yshift=-2mm,xshift=2mm},boxed title style={colback=amber!85!black,arc=1pt}]}{\end{tcolorbox}}
\newenvironment{warn}{\begin{tcolorbox}[colback=red!6,colframe=red!60!black,boxrule=0.6pt,arc=2pt,left=6pt,right=6pt,top=3pt,bottom=3pt,title={\textbf{Caution}},coltitle=white,fonttitle=\small,attach boxed title to top left={yshift=-2mm,xshift=2mm},boxed title style={colback=red!60!black,arc=1pt}]}{\end{tcolorbox}}
\newcommand{\stepno}[2]{\vspace{4pt}\noindent\tikz[baseline=(n.base)]{\node[fill=grn,text=white,rounded corners=2pt,inner sep=4pt,font=\bfseries\small] (n) {STEP #1};}\hspace{0.6em}{\Large\bfseries #2}\par\vspace{2pt}}
\newcommand{\goal}[1]{{\color{mut}\emph{Goal: #1}}\par}
\newcommand{\tp}[1]{\texttt{TP#1}}
\setlist[enumerate]{leftmargin=2em,itemsep=2pt,topsep=2pt}
\setlist[itemize]{leftmargin=1.4em,itemsep=2pt,topsep=2pt}
\begin{document}
% ---------------- cover (white, printer friendly: mark with signal rings, wordmark above the title)
\thispagestyle{empty}
\begin{tikzpicture}[remember picture,overlay]
 \pgfmathsetmacro{\H}{9.4}\pgfmathsetmacro{\sc}{\H/64}
 \node[anchor=north east,inner sep=0] (m) at ($(current page.north east)+(-1.6cm,-2.6cm)$) {};
 \coordinate (c) at ($(m.north west)+(32.6*\sc cm,-21*\sc cm)$);
 \draw[amber,opacity=0.75,line width=0.5pt] (c) circle (11.1*\sc cm);
 \draw[amber,opacity=0.5,line width=0.5pt] (c) circle (17.6*\sc cm);
 \draw[amber,opacity=0.32,line width=0.5pt] (c) circle (27.9*\sc cm);
 \node[anchor=north west,xshift=2.2cm,yshift=-2.6cm,font=\scriptsize\ttfamily,text=mut] at (current page.north west) {BRING-UP GUIDE\ \ /\ \ VERSION 0.1};
 \node[anchor=north west,xshift=2.2cm,yshift=-13.3cm] at (current page.north west) {\titlefont\fontsize{46}{46}\selectfont\color{grn}AUS\color{amber}ELIA};
 \node[anchor=north west,text width=15.5cm,xshift=2.2cm,yshift=-15.4cm] at (current page.north west) {\titlefont\fontsize{26}{31}\selectfont\color{grn}Analog Front-End (AFE) v1:\\bring-up guide};
 \node[anchor=north west,text width=15cm,xshift=2.2cm,yshift=-19.0cm] at (current page.north west) {\large\color{ink} From the first look at the board to the sensor on the plant.};
 \node[anchor=north west,text width=14cm,xshift=2.2cm,yshift=-21.2cm] at (current page.north west) {\small\color{mut} Each step has a goal, a list of actions, a table of expected values, and a check list for a wrong result. The simulation of the as-built board gives each expected value.};
 \node[anchor=north west,xshift=2.2cm,yshift=-25.2cm,font=\scriptsize\ttfamily,text=mut] at (current page.north west) {Version 0.1\ \ /\ \ November 4, 2026\ \ /\ \ Nicol\'as Villegas};
 \node[anchor=north west,xshift=2.2cm,yshift=-27.6cm,font=\tiny\ttfamily,text=mut] at (current page.north west) {AUSELIA\ \ /\ \ AFE V1\ \ /\ \ BRING-UP GUIDE\ \ /\ \ VERSION 0.1};
\end{tikzpicture}
\clearpage
% ---------------- 1
\section{About this guide}
This guide takes the first AFE boards from the box to a measured result. The steps follow the signal. First, apply power. Then test the chain, the listener, and the SPI (serial peripheral interface) link. Last, test the sensor head and put it on the plant.

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
