auselia/adc_test_board/doc/bringup/fig_ladder.pdf

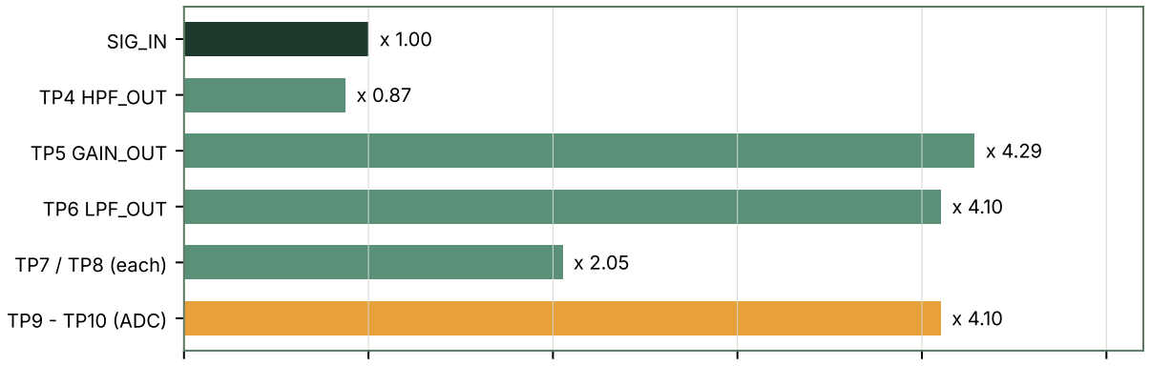
[picture p221: figure]
TP9 - TP10 (ADC); TP7 / TP8 (each); TP6 LPF_OUT; TP5 GAIN_OUT; TP4 HPF_OUT; SIG_IN

0 | 1 | 2 | 3 | 4 | 5

amplitude relative to SIG_IN, 250 kHz (peak of the AC part)
