auselia/adc_test_board/sim/head_bias_t_3v3_results.txt

v(v5h) = 2.897721e+00
v(vref) = 1.448861e+00
v(out) = 1.448829e+00
v(lh) = 2.996104e+00
v(hp) = 3.094488e+00
v(sig) = 1.650000e+00
i(v5) = -8.68444e-03
loss_10k            =  -1.86895e+01
loss_100k           =  -5.47652e-02
loss_250k           =  -1.74951e-01
loss_500k           =  -1.11035e-01
gain_head_250k      =  3.03410e+01
gain_ref_250k       =  3.05160e+01
