auselia/adc_test_board/sim/head_bias_t_results.txt

v(v5h) = 4.167432e+00
v(vref) = 2.083716e+00
v(out) = 2.083704e+00
v(lh) = 4.273223e+00
v(hp) = 4.379014e+00
v(sig) = 2.300000e+00
i(v5) = -9.28591e-03
loss_10k            =  -1.86915e+01
loss_100k           =  -3.53435e-02
loss_250k           =  -1.57070e-01
loss_500k           =  -1.01864e-01
gain_head_250k      =  3.03584e+01
gain_ref_250k       =  3.05155e+01
