auselia/adc_test_board/doc/bringup/fig_flow.png

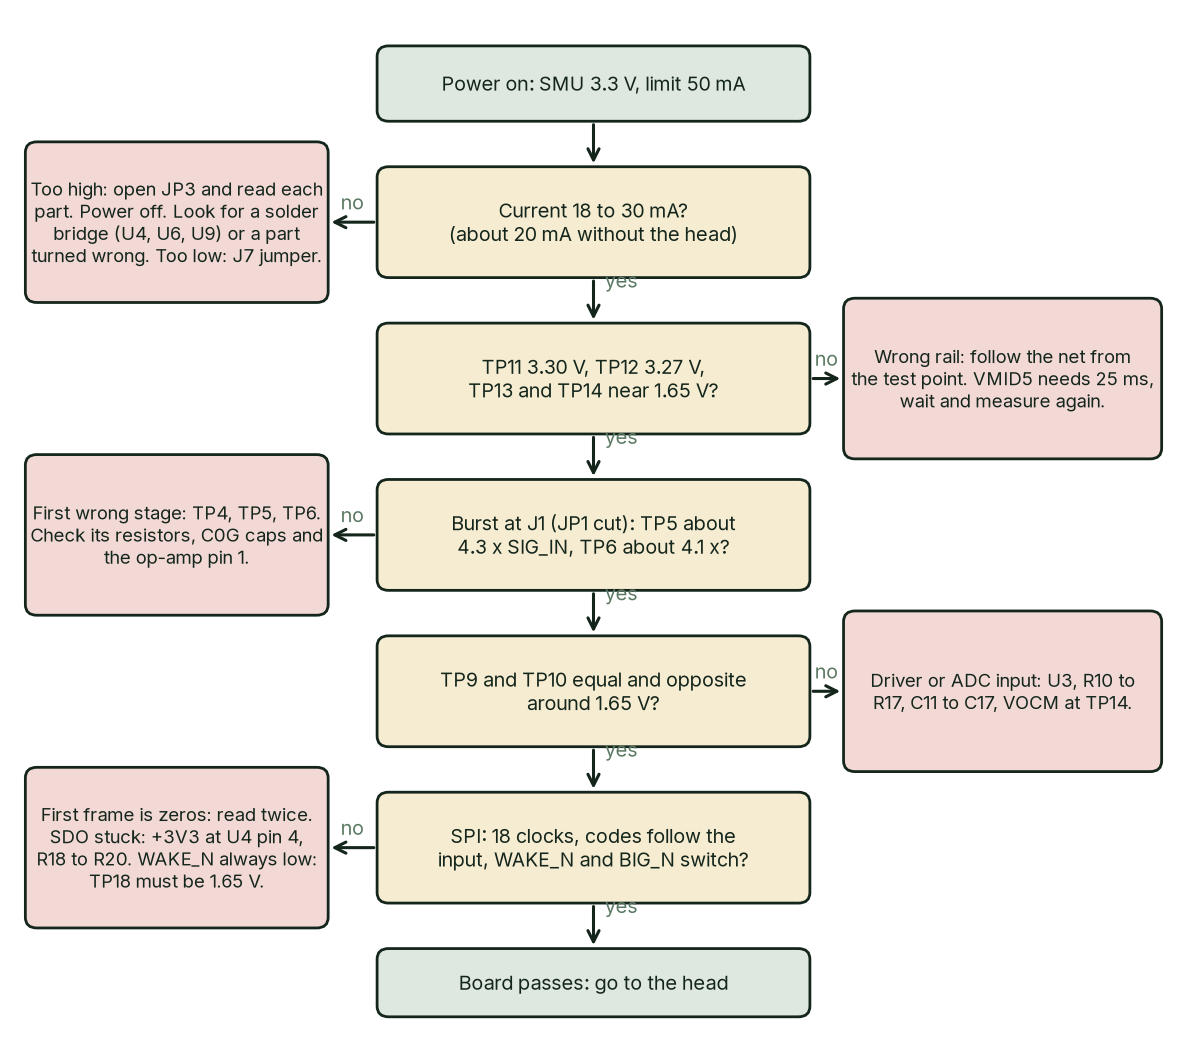
doc/bringup/fig_flow.png
