auselia/adc_test_board/doc/bringup/fig_headmap.png

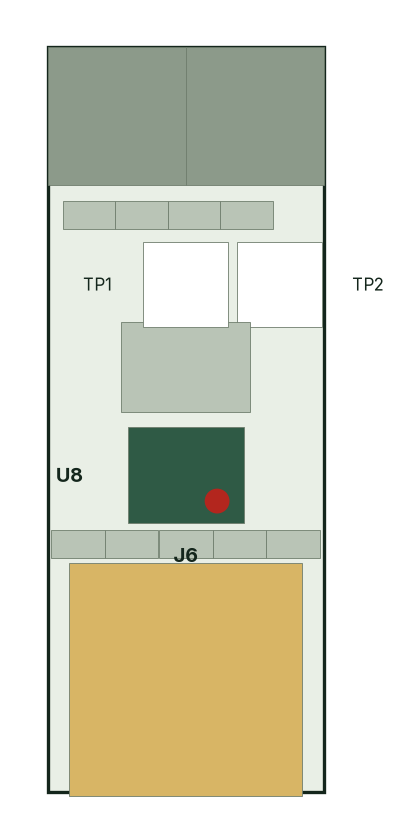
doc/bringup/fig_headmap.png
