auselia/adc_test_board/doc/bringup/fig_j7_pmod.png

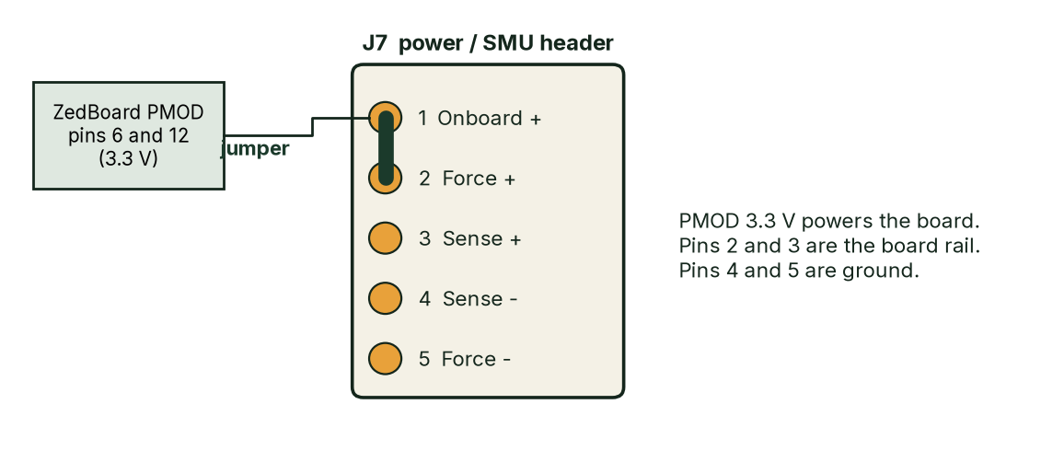
doc/bringup/fig_j7_pmod.png
