auselia/adc_test_board/doc/bringup/fig_j7_smu.png

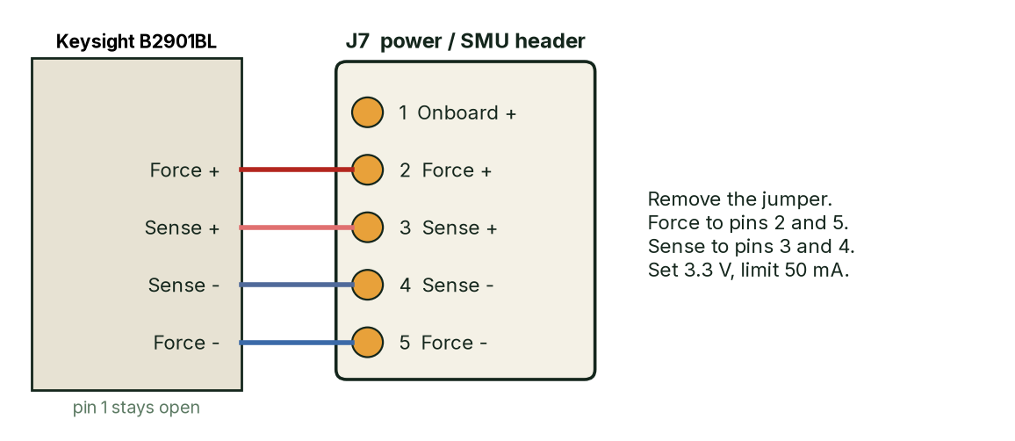
doc/bringup/fig_j7_smu.png
