auselia/adc_test_board/doc/bringup/fig_ladder.png

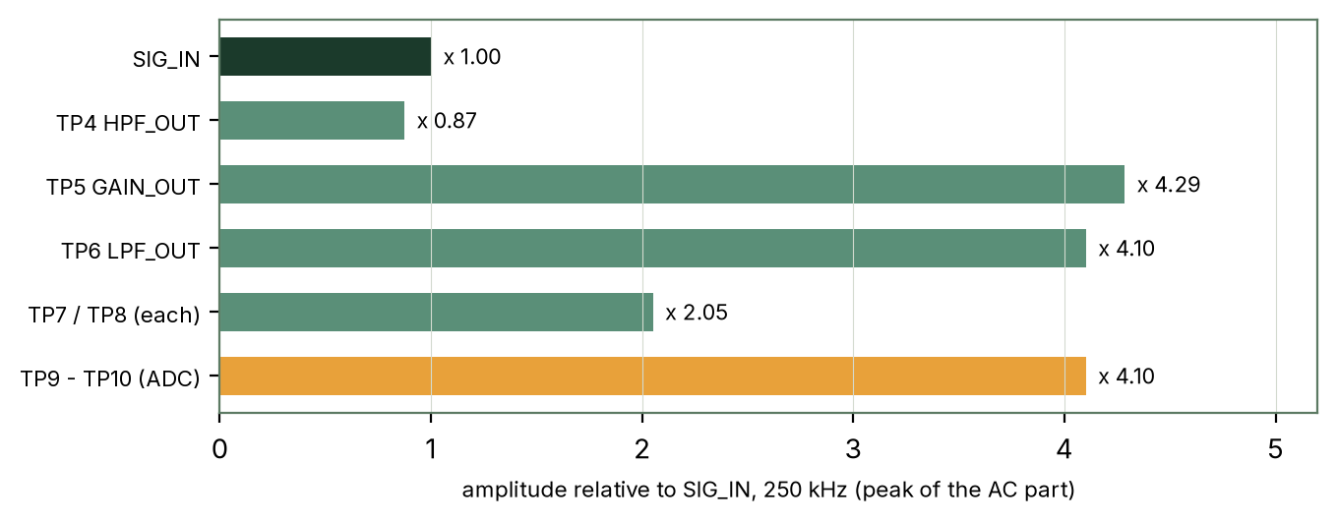
doc/bringup/fig_ladder.png
