auselia/adc_test_board/doc/bringup/fig_waves.png

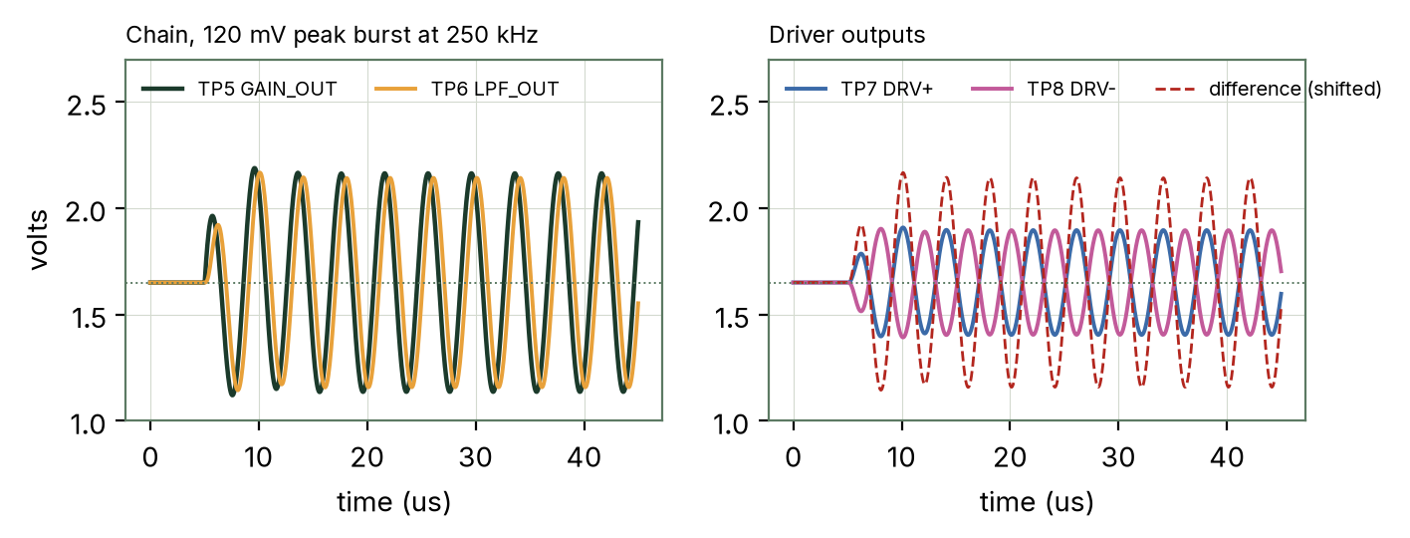
doc/bringup/fig_waves.png
