auselia/adc_test_board/hw/preview/ADC_Test_render_bottom.png

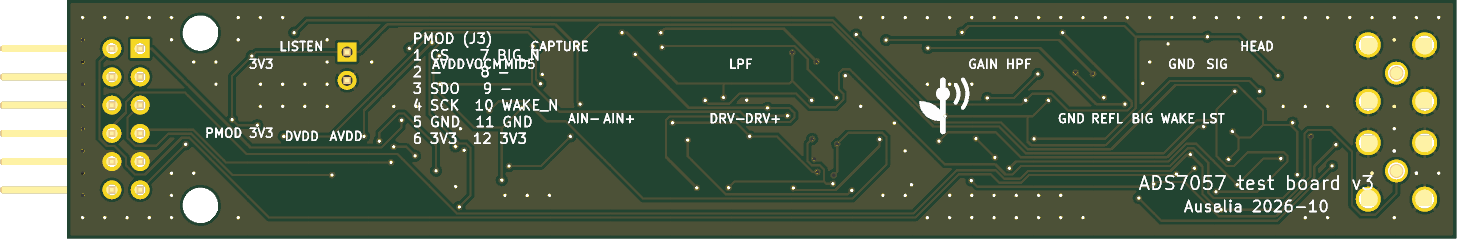
hw/preview/ADC_Test_render_bottom.png
