auselia/adc_test_board/doc/bringup/fig_waves.pdf

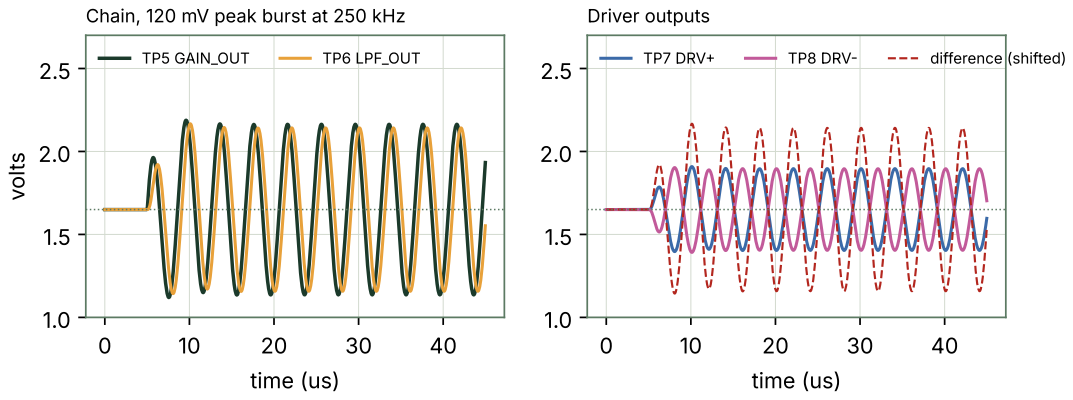
[picture p231: page 1]
time (us); volts; TP5 GAIN_OUT; TP6 LPF_OUT; Driver outputs; TP7 DRV+; TP8 DRV-; difference (shifted)

Chain, 120 mV peak burst at 250 kHz
