auselia/adc_test_board/doc/notes/slides/s07_graph.pdf

2.5

3.0

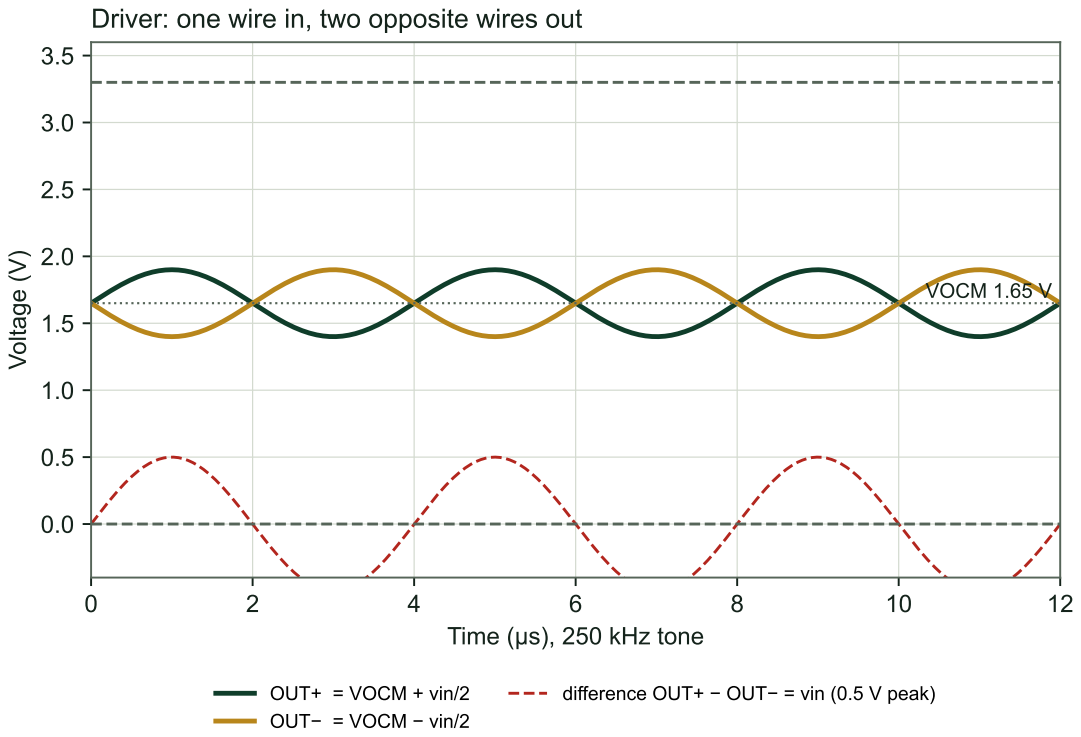
[picture p232: page 1]
Voltage (V); VOCM 1.65 V

Driver: one wire in, two opposite wires out

Time (µs), 250 kHz tone

OUT+ = VOCM + vin/2
OUT− = VOCM − vin/2

difference OUT+ − OUT− = vin (0.5 V peak)
