auselia/adc_test_board/doc/notes/slides/s09_rate.pdf

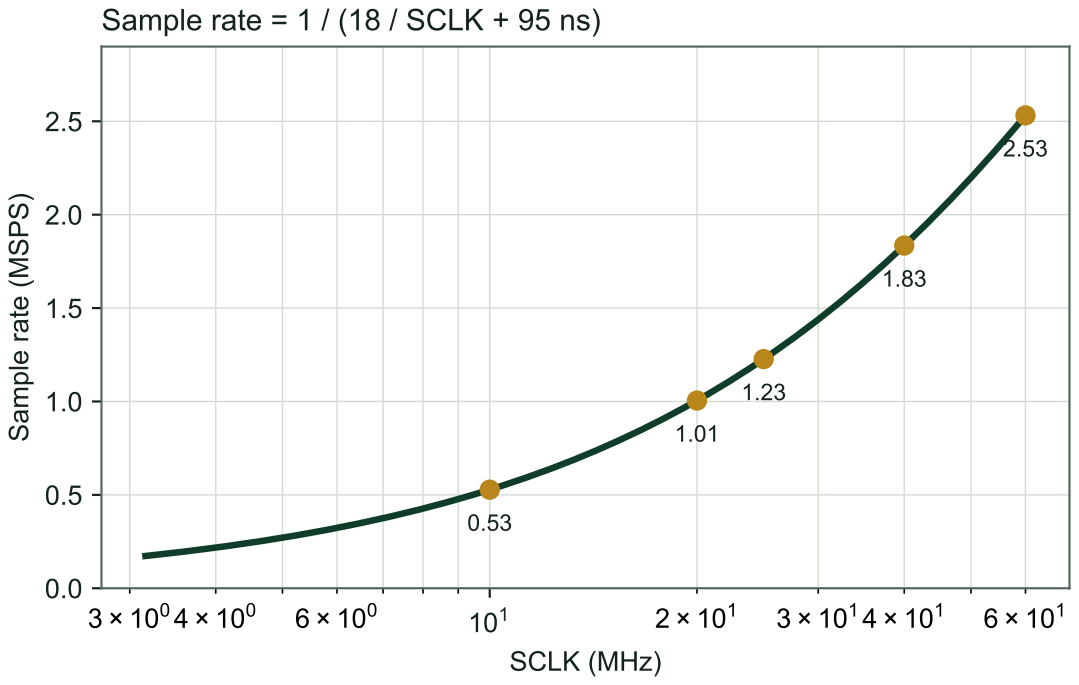
[picture p233: page 1]
SCLK (MHz)

Sample rate = 1 / (18 / SCLK + 95 ns)

Sample rate (MSPS)

1.23
1.01
