auselia/adc_test_board/doc/notes/slides/s13_circuit.pdf

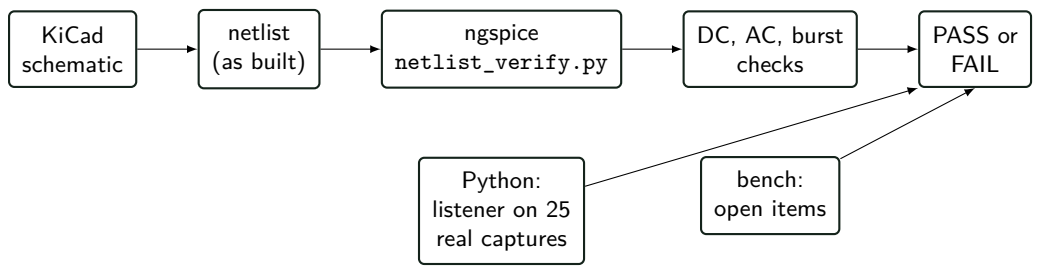
[picture p236: page 1]
KiCad schematic; netlist (as built); ngspice netlist_verify.py; PASS or FAIL; Python: listener on 25 real captures; bench: open items

DC, AC, burst
checks
