auselia/adc_test_board/doc/notes/slides/s04_graph.pdf

−60 −50 −40 −30 −20 −100

### High-pass filter (U1A)

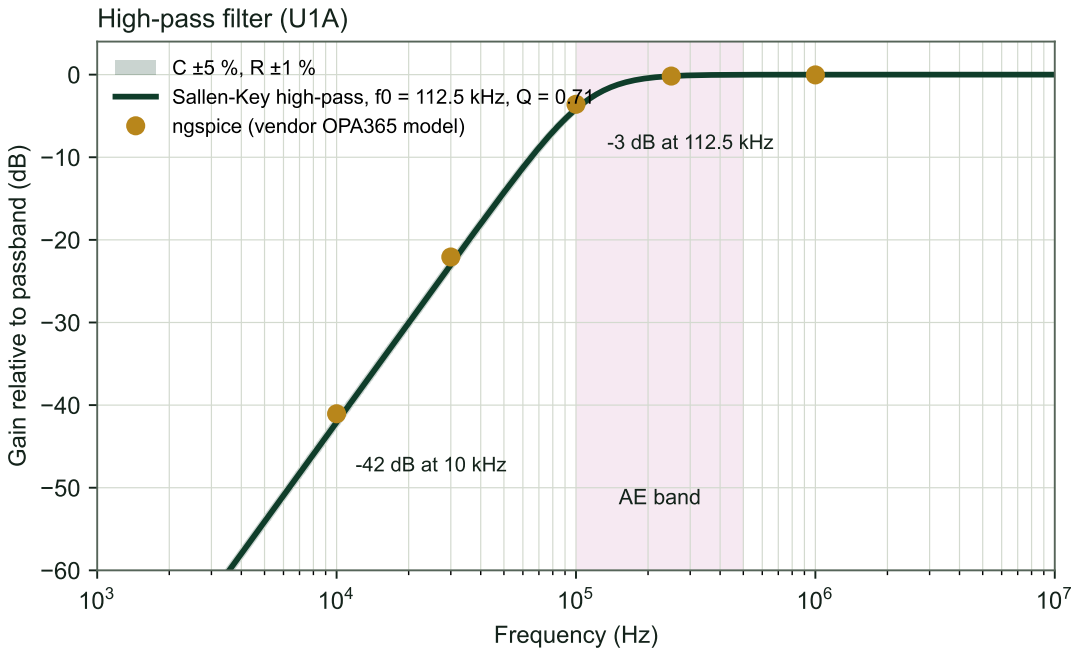
[picture p237: page 1]
Frequency (Hz)

C ±5 %, R ±1 %
Sallen-Key high-pass, f0 = ngspice | (vendor OPA365 model) | 112.5 kHz, Q = | 0.71 | -3 dB at 112.5 kHz

Gain relative to passband (dB)

-42 dB at 10 kHz

AE band
