auselia/adc_test_board/doc/notes/slides/s05_graph.pdf

### Gain stage: what clips first (250 kHz bursts, gain 4.9)

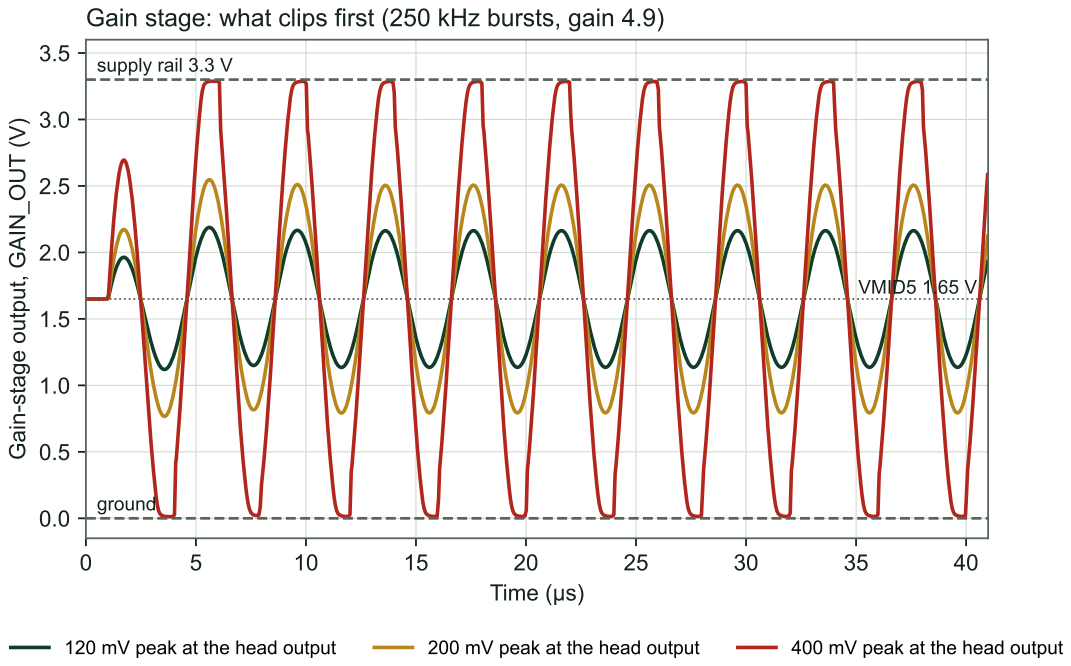
[picture p238: page 1]
Time (µs); supply rail 3.3 V; ground; VMID5 1.65; 120 mV peak at the head output; 200 mV peak at the head output; 400 mV peak at the head output

Gain-stage output, GAIN_OUT (V)
