auselia/adc_test_board/doc/notes/slides/s06_graph.pdf

−10

0

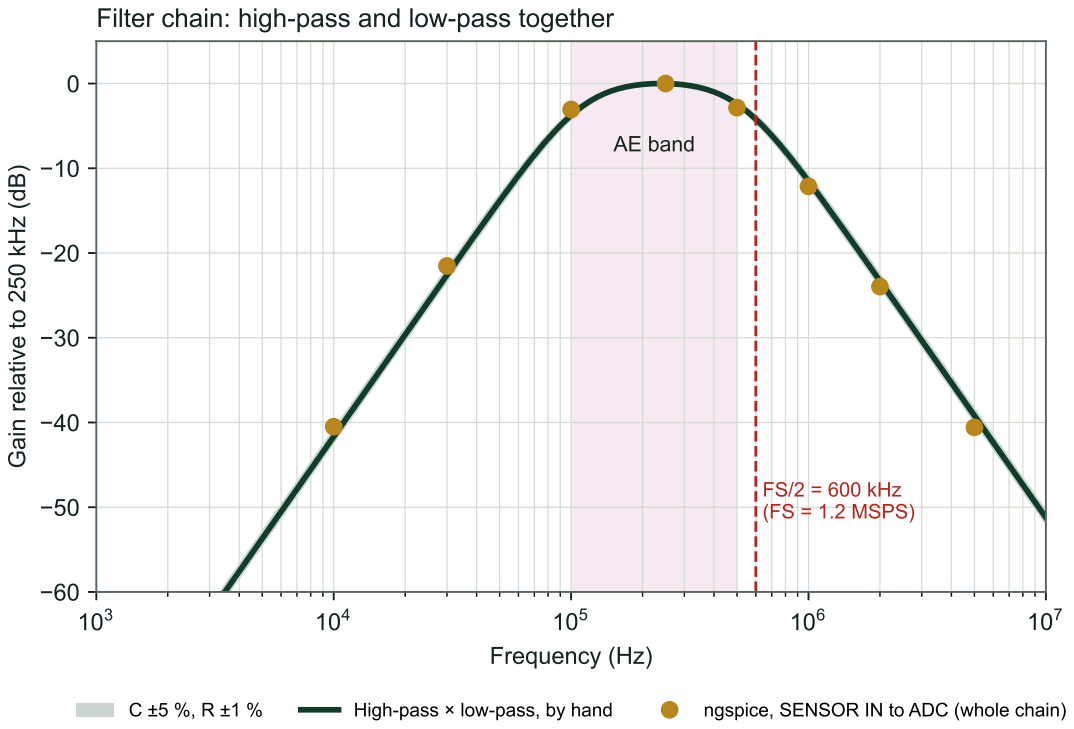
[picture p239: page 1]
Frequency (Hz); AE band; High-pass × low-pass, by hand; ngspice, SENSOR IN to ADC (whole chain)

Filter chain: high-pass and low-pass together

Gain relative to 250 kHz (dB)

FS/2 = 600 kHz
(FS = 1.2 MSPS)
