auselia/adc_test_board/doc/bringup/fig_boardmap.pdf

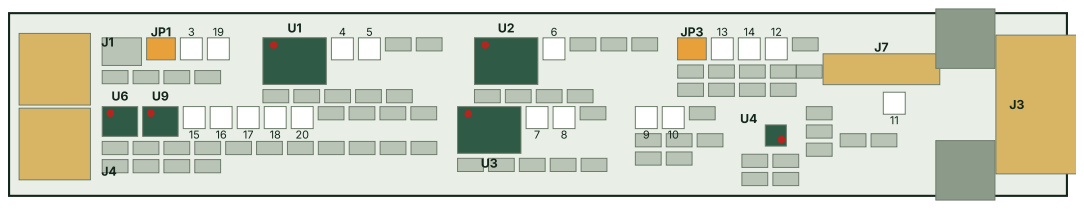
[picture p240: page 1]
