auselia/adc_test_board/doc/bringup/fig_setup.pdf

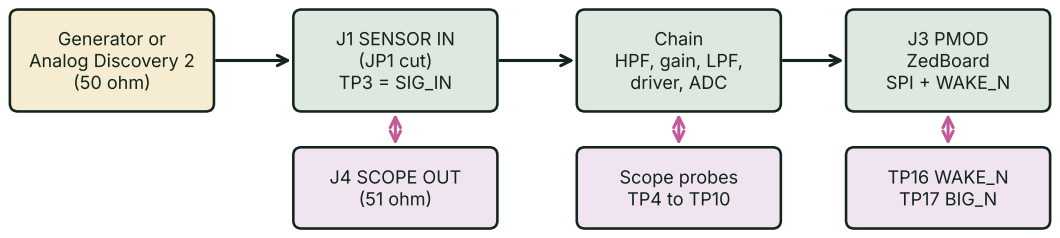
[picture p241: page 1]
