auselia/adc_test_board/doc/notes/head_circuit.pdf

±1 %

±5 %

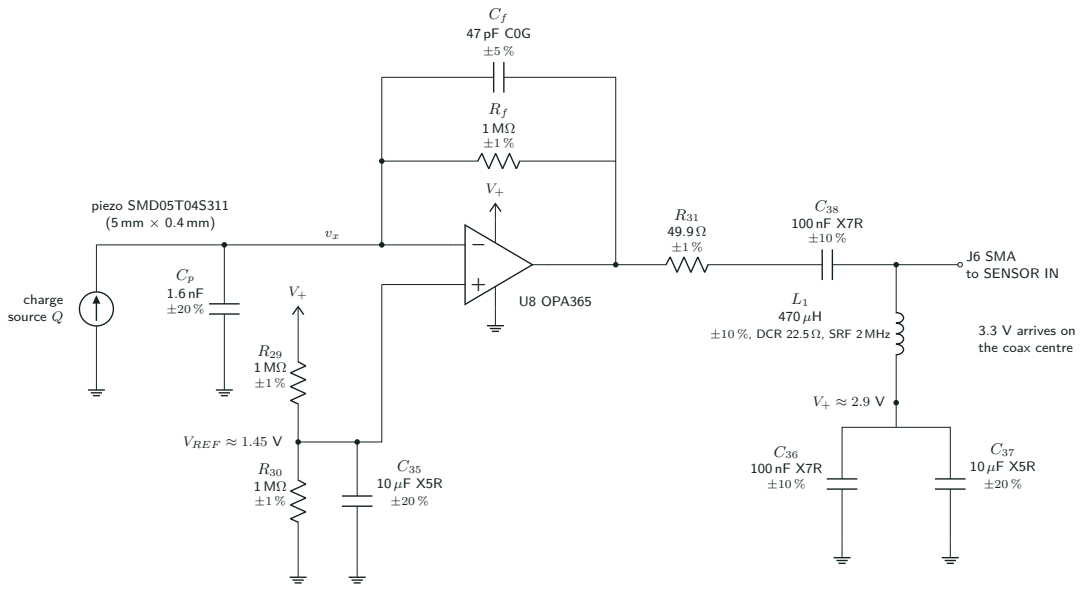
[picture p242: page 1]
