auselia/adc_test_board/doc/notes/slides/s10_circuit.pdf

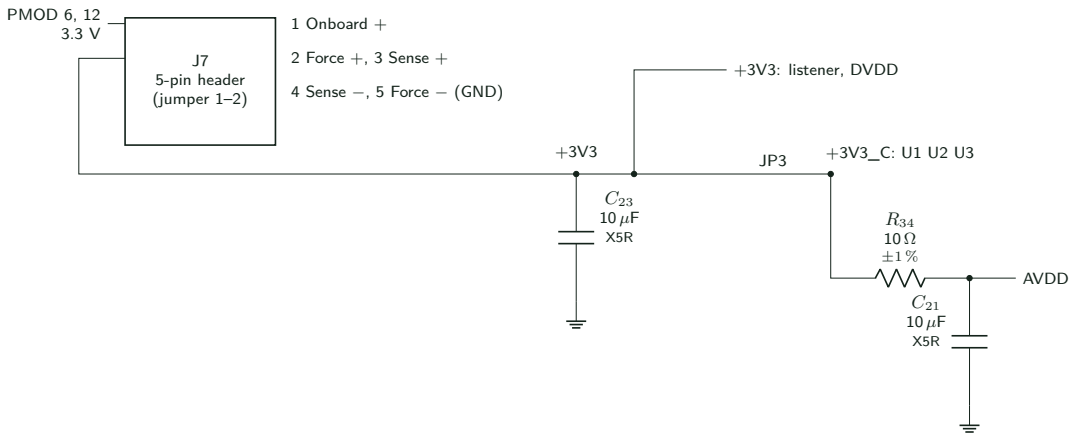
[picture p243: page 1]
