auselia/adc_test_board/doc/notes/slides/s12_circuit.pdf

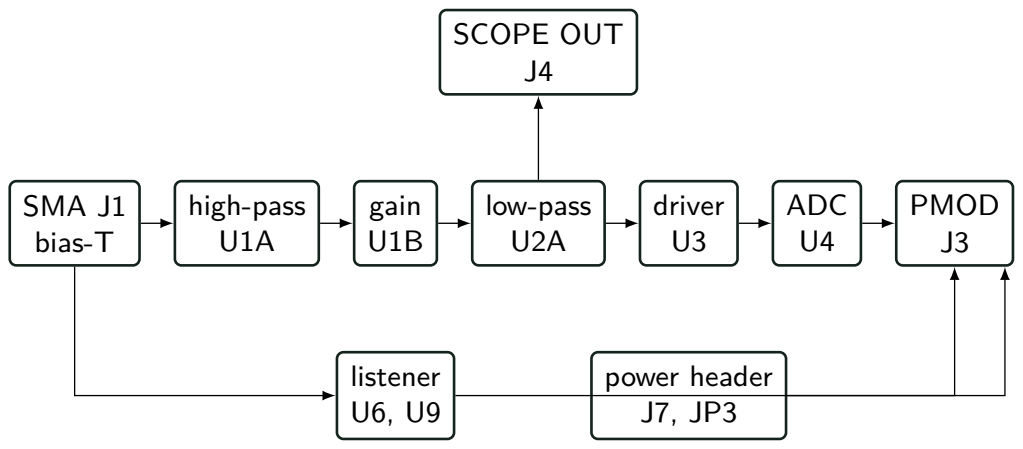
[picture p244: page 1]
