auselia/adc_test_board/doc/notes/slides/s11_circuit.pdf

±5 %
±1 %

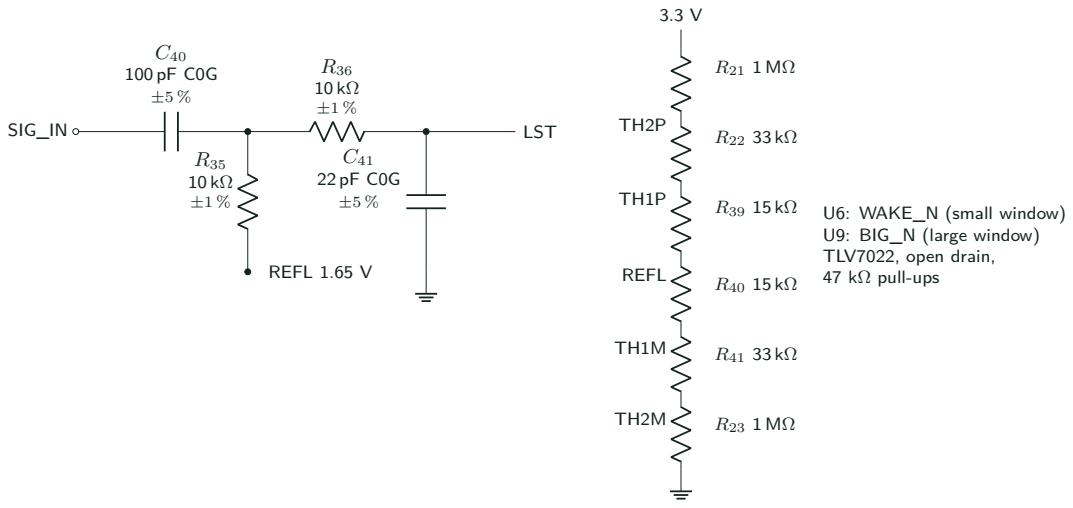
[picture p245: page 1]
