auselia/adc_test_board/hw/backplane/out/BP_Module.pdf

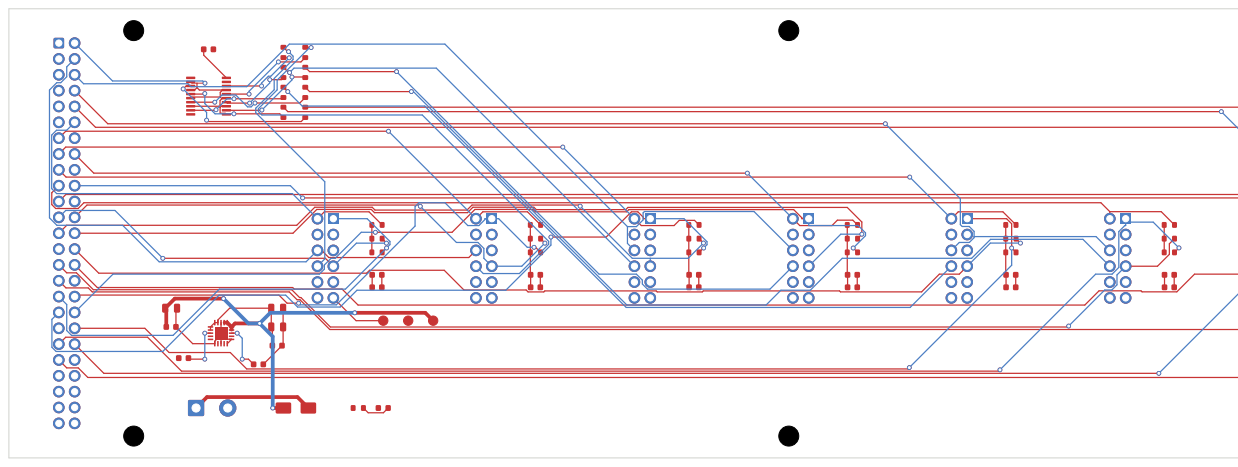
[picture p246: page 1]
