auselia/adc_test_board/doc/notes/slides/s03_circuit.pdf

±1 %

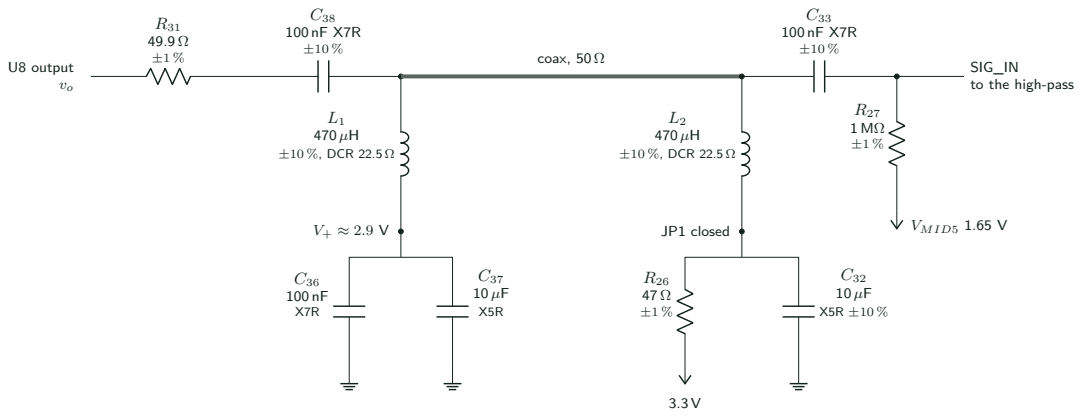
[picture p247: page 1]

SIG_IN
to the high-pass
