auselia/adc_test_board/hw/ADC_Test.kicad_pcb

## KiCad design hw/ADC_Test.kicad_pcb (2026-10-26)

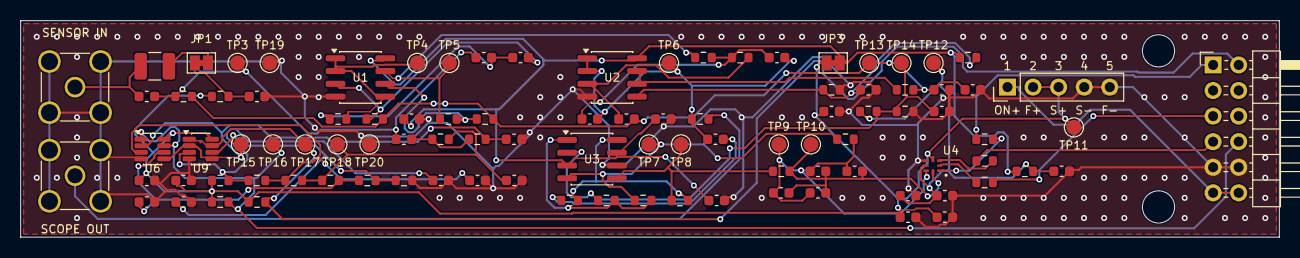
[picture p248: board ADC_Test.kicad_pcb from above]

Board: 2 copper layers, 125.0 x 21.5 mm, 101 parts (0 on the bottom side), 44 nets.

Parts:
C1, C2, C4, C5, C6, C14, C15, C16, C17, C40: 100pF C0G; C_0603_1608Metric
C3, C9, C10, C12, C20, C22, C26, C27, C28, C33, C43, C44, C45: 100nF; C_0603_1608Metric
C7, C11, C13, C19, C42: 1uF; C_0603_1608Metric
C8, C21, C23, C32: 10uF; C_0603_1608Metric
C18: 4.7uF; C_0603_1608Metric
C41: 22pF C0G; C_0603_1608Metric
H1, H2: M3; MountingHole_3.2mm_M3
J1: SMA SENSOR IN; SMA_Amphenol_132134-11_Vertical
J3: PMOD (ZedBoard); PinHeader_2x06_P2.54mm_Horizontal
J4: SMA MON; SMA_Amphenol_132134-11_Vertical
J7: POWER / SMU; PinHeader_1x05_P2.54mm_Vertical
JP1: HEAD PWR; SolderJumper-2_P1.3mm_Bridged_Pad1.0x1.5mm
JP3: CAPTURE LINK; SolderJumper-2_P1.3mm_Bridged_Pad1.0x1.5mm
L2: 470uH; L_1210_3225Metric
R1, R7, R8, R35, R36: 10k; R_0603_1608Metric
R2: 20k; R_0603_1608Metric
R3: 3.9k; R_0603_1608Metric
R4, R10, R11, R12, R13, R14, R15: 1.00k; R_0603_1608Metric
R5, R6: 2.2k; R_0603_1608Metric
R9, R16, R17, R34: 10R; R_0603_1608Metric
R18, R19, R20: 22R; R_0603_1608Metric
R21, R23, R27: 1M; R_0603_1608Metric
R22, R41: 33k; R_0603_1608Metric
R24, R42: 47k; R_0603_1608Metric
R25: 51R; R_0603_1608Metric
R26: 47R; R_0603_1608Metric
R39, R40: 15k; R_0603_1608Metric
TP3: SIG_IN; TestPoint_Pad_D1.5mm
TP4: HPF_OUT; TestPoint_Pad_D1.5mm
TP5: GAIN_OUT; TestPoint_Pad_D1.5mm
TP6: LPF_OUT; TestPoint_Pad_D1.5mm
TP7: DRV_OUTP; TestPoint_Pad_D1.5mm
TP8: DRV_OUTN; TestPoint_Pad_D1.5mm
TP9: AINP; TestPoint_Pad_D1.5mm
TP10: AINM; TestPoint_Pad_D1.5mm
TP11: +3V3; TestPoint_Pad_D1.5mm
TP12: AVDD; TestPoint_Pad_D1.5mm
TP13: VMID5; TestPoint_Pad_D1.5mm
TP14: VOCM; TestPoint_Pad_D1.5mm
TP15: LST; TestPoint_Pad_D1.5mm
TP16: WAKE_N; TestPoint_Pad_D1.5mm
TP17: BIG_N; TestPoint_Pad_D1.5mm
TP18: REFL; TestPoint_Pad_D1.5mm
TP19, TP20: GND; TestPoint_Pad_D1.5mm
U1, U2: OPA2365; SOIC-8_3.9x4.9mm_P1.27mm
U3: THS4531; SOIC-8_3.9x4.9mm_P1.27mm
U4: ADS7057; ADS7057_X2QFN-8_1.5x1.5mm
U6, U9: TLV7022; SOT-23-8

Connections:
+3V3: C19.1, C20.1, C23.1, C28.1, C45.1, J7.2, J7.3, JP3.1, R21.1, R24.1, R26.1, R42.1, TP11.1, U4.4, U6.8, U9.8
+3V3_C: C3.1, C10.1, C12.1, JP3.2, R7.1, R34.1, U1.8, U2.8, U3.3, U3.7
+3V3_PMOD: J3.11, J3.12, J7.1
AINM: C14.2, C15.2, C16.2, C17.2, R17.2, TP10.1, U4.8
AINP: C14.1, C15.1, C16.1, C17.1, R16.2, TP9.1, U4.7
AVDD: C18.1, C21.1, C22.1, R14.1, R34.2, TP12.1, U4.6
BIG_N: J3.2, R42.2, TP17.1, U9.1, U9.7
CS: J3.1, R18.1
CS_A: R18.2, U4.1
DRV_A: C11.2, R10.1
DRV_INN: R11.2, R12.2, U3.1
DRV_INP: R10.2, R13.2, U3.8
DRV_OUTN: R13.1, R17.1, TP8.1, U3.5
DRV_OUTP: R12.1, R16.1, TP7.1, U3.4
GAIN_OUT: R3.1, R5.1, TP5.1, U1.7
GND: C3.2, C7.2, C8.2, C9.2, C10.2, C12.2, C13.2, C18.2, C19.2, C20.2, C21.2, C22.2, C23.2, C26.2, C27.2, C28.2, C32.2, C41.2, C42.2, C43.2, C44.2, C45.2, J1.2, J3.9, J3.10, J4.2, J7.4, J7.5, R8.2, R15.2, R23.2, TP19.1, TP20.1, U1.4, U2.4, U3.6, U4.5, U6.4, U9.4
GN_FB: R3.2, R4.1, U1.6
HEAD_LINE: C33.1, J1.1, L2.1
HEAD_PWR: C32.1, JP1.1, R26.2
HEAD_PWR_L: JP1.2, L2.2
HPF_OUT: R1.2, TP4.1, U1.1, U1.2, U1.5
HP_A: C1.2, C2.1, R1.1
HP_B: C2.2, R2.1, U1.3
LPF_OUT: C4.2, C5.2, C11.1, R25.1, TP6.1, U2.1, U2.2
LP_A: C4.1, C5.1, R5.2, R6.1
LP_B: C6.1, R6.2, U2.3
LST: C41.1, R36.2, TP15.1, U6.2, U6.5, U9.2, U9.5
LST_A: C40.2, R35.1, R36.1
MON: J4.1, R25.2
REFL: C42.1, R35.2, R39.2, R40.1, TP18.1
SCLK: J3.7, R19.1
SCLK_A: R19.2, U4.3
SDO: J3.5, R20.2
SDO_A: R20.1, U4.2
SIG_IN: C1.1, C33.2, C40.1, R27.1, TP3.1
TH1M: C27.1, R40.2, R41.1, U6.6
TH1P: C26.1, R22.2, R39.1, U6.3
TH2M: C44.1, R23.1, R41.2, U9.6
TH2P: C43.1, R21.2, R22.1, U9.3
VMID5: C6.2, C8.1, C9.1, R2.2, R4.2, R9.2, R27.2, TP13.1
VMID_BUF: R9.1, U2.6, U2.7
VMID_DIV: C7.1, R7.2, R8.1, U2.5
VOCM: C13.1, R11.1, R14.2, R15.1, TP14.1, U3.2
WAKE_N: J3.8, R24.2, TP16.1, U6.1, U6.7
