auselia/adc_test_board/hw/ADC_Head.kicad_pcb

## KiCad design hw/ADC_Head.kicad_pcb (2026-10-26)

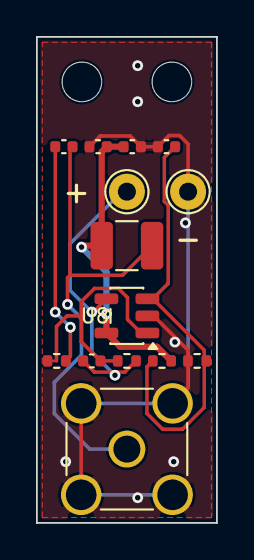
[picture p249: board ADC_Head.kicad_pcb from above]

Board: 2 copper layers, 10.0 x 27.0 mm, 16 parts (0 on the bottom side), 7 nets.

Parts:
C34: 47pF C0G; C_0402_1005Metric
C35, C37: 10uF; C_0402_1005Metric
C36, C38: 100nF; C_0402_1005Metric
H3, H4: M2; MountingHole_2.2mm_M2
J6: SMA HEAD OUT; SMA_Amphenol_132134-11_Vertical
L1: 470uH; L_1210_3225Metric
R28, R29, R30: 1M; R_0402_1005Metric
R31: 49.9R; R_0402_1005Metric
TP1: PIEZO +; TestPoint_THTPad_D2.0mm_Drill1.0mm
TP2: PIEZO -; TestPoint_THTPad_D2.0mm_Drill1.0mm
U8: OPA365; SOT-23-5

Connections:
HAC: C38.1, R31.2
HGND: C35.2, C36.2, C37.2, J6.2, R30.2, TP2.1, U8.2
HLINE: C38.2, J6.1, L1.1
HOUT: C34.2, R28.2, R31.1, U8.1
HREF: C35.1, R29.2, R30.1, U8.3
HSUM: C34.1, R28.1, TP1.1, U8.4
HV: C36.1, C37.1, L1.2, R29.1, U8.5
