auselia/adc_test_board/hw/backplane/BP16.kicad_pcb

## KiCad design hw/backplane/BP16.kicad_pcb (2026-10-20)

Schematic: BP16.kicad_sch, ADS7057 backplane, 16 channels: FMC plug, level shifters, 4…

Parts:
C1, C2, C3, C4, C5, C6, C7, C8, C9, C10, C11, C12, C13, C14, C15, C16, C18, C20, C22, C24, C26, C28, C30, C32, C34, C36, C38, C40, C42, C44, C46, C48, C50, C51, C52, C54, C58: 100nF; C_0603_1608Metric; LCSC C14663
C17, C19, C21, C23, C25, C27, C29, C31, C33, C35, C37, C39, C41, C43, C45, C47, C49: 10uF; C_0603_1608Metric; LCSC C19702
C53, C55, C56, C57: 22uF 25V; C_0805_2012Metric; LCSC C45783
C59, C60: 10nF; C_0603_1608Metric; LCSC C57112
D1: SS14; D_SMA; LCSC C2480
D2: 3V3 OK; LED_0603_1608Metric; LCSC C2286
H1, H2, H3, H4, H5, H6: M3; MountingHole_3.2mm_M3
J1: ASP-134602-01; ASP-134602-01_LPC; LCSC C2875619
J2: SLOT 0; PinSocket_2x06_P2.54mm_Vertical; LCSC C36191
J3: SLOT 1; PinSocket_2x06_P2.54mm_Vertical; LCSC C36191
J4: SLOT 2; PinSocket_2x06_P2.54mm_Vertical; LCSC C36191
J5: SLOT 3; PinSocket_2x06_P2.54mm_Vertical; LCSC C36191
J6: SLOT 4; PinSocket_2x06_P2.54mm_Vertical; LCSC C36191
J7: SLOT 5; PinSocket_2x06_P2.54mm_Vertical; LCSC C36191
J8: SLOT 6; PinSocket_2x06_P2.54mm_Vertical; LCSC C36191
J9: SLOT 7; PinSocket_2x06_P2.54mm_Vertical; LCSC C36191
J10: SLOT 8; PinSocket_2x06_P2.54mm_Vertical; LCSC C36191
J11: SLOT 9; PinSocket_2x06_P2.54mm_Vertical; LCSC C36191
J12: SLOT 10; PinSocket_2x06_P2.54mm_Vertical; LCSC C36191
J13: SLOT 11; PinSocket_2x06_P2.54mm_Vertical; LCSC C36191
J14: SLOT 12; PinSocket_2x06_P2.54mm_Vertical; LCSC C36191
J15: SLOT 13; PinSocket_2x06_P2.54mm_Vertical; LCSC C36191
J16: SLOT 14; PinSocket_2x06_P2.54mm_Vertical; LCSC C36191
J17: SLOT 15; PinSocket_2x06_P2.54mm_Vertical; LCSC C36191
J18: 5 V IN; TerminalBlock_Phoenix_MKDS-1,5-2-5.08_1x02_P5.08mm_Horizont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; LCSC C8465
R1, R2, R3, R4, R5, R6, R7, R8, R9, R10, R11, R12, R13, R14, R15, R16, R17, R18, R19, R20, R21, R22, R23, R24, R25, R26, R27, R28, R29, R30, R31, R32, R33, R34, R35, R36, R37, R38, R39, R40, R41, R42, R43, R44, R45, R46, R47, R48, R49, R50, R51, R52, R53, R54, R55, R56: 100k; R_0603_1608Metric; LCSC C25803
R57, R58, R59, R60, R61, R62, R63, R64, R65, R66, R67, R68, R69, R70, R71, R72: 22R; R_0603_1608Metric; LCSC C23345
R73: 1k; R_0603_1608Metric; LCSC C21190
TP1: +3V3; TestPoint_Pad_D1.5mm
TP2: GND; TestPoint_Pad_D1.5mm
TP3: +5V; TestPoint_Pad_D1.5mm
TP4: VADJ; TestPoint_Pad_D1.5mm
U1, U2, U3, U4, U5, U6, U7, U8: SN74LVC8T245; TSSOP-24_4.4x7.8mm_P0.65mm; LCSC C27643
U9, U10: SN74LVC244A; TSSOP-20_4.4x6.5mm_P0.65mm; LCSC C7668
U11: TPS7A8300; QFN-20-1EP_3.5x3.5mm_P0.5mm_EP2x2mm; LCSC C544500

Connections:
+3V3: C2.1, C4.1, C6.1, C8.1, C10.1, C12.1, C14.1, C16.1, C19.1, C20.1, C21.1, C22.1, C23.1, C24.1, C25.1, C26.1, C27.1, C28.1, C29.1, C30.1, C31.1, C32.1, C33.1, C34.1, C35.1, C36.1, C37.1, C38.1, C39.1, C40.1, C41.1, C42.1, C43.1, C44.1, C45.1, C46.1, C47.1, C48.1, C49.1, C50.1, C51.1, C52.1, C55.1, C56.1, C57.1, C58.1, C60.1, J2.11, J2.12, J3.11, J3.12, J4.11, J4.12, J5.11, J5.12, J6.11, J6.12, J7.11, J7.12, J8.11, J8.12, J9.11, J9.12, J10.11, J10.12, J11.11, J11.12, J12.11, J12.12, J13.11, J13.12, J14.11, J14.12, J15.11, J15.12, J16.11, J16.12, J17.11, J17.12, R9.1, R10.1, R11.1, R12.1, R13.1, R14.1, R15.1, R16.1, R17.1, R18.1, R19.1, R20.1, R21.1, R22.1, R23.1, R24.1, R25.1, R26.1, R27.1, R28.1, R29.1, R30.1, R31.1, R32.1, R33.1, R34.1, R35.1, R36.1, R37.1, R38.1, R39.1, R40.1, R41.1, R42.1, R43.1, R44.1, R45.1, R46.1, R47.1, R48.1, R49.1, R50.1, R51.1, R52.1, R53.1, R54.1, R55.1, R56.1, R73.1, TP1.1, U1.23 (VCCB), U1.24 (VCCB), U2.23 (VCCB), U2.24 (VCCB), U3.23 (VCCB), U3.24 (VCCB), U4.23 (VCCB), U4.24 (VCCB), U5.23 (VCCB), U5.24 (VCCB), U6.23 (VCCB), U6.24 (VCCB), U7.23 (VCCB), U7.24 (VCCB), U8.23 (VCCB), U8.24 (VCCB), U9.20 (VCC), U10.20 (VCC), U11.1 (OUT), U11.2 (SNS), U11.19 (OUT), U11.20 (OUT)
+5V: C53.1, C54.1, D1.1 (K), TP3.1, U11.14 (EN), U11.15 (IN), U11.16 (IN), U11.17 (IN)
+5V_IN: D1.2 (A), J18.1
BIG0: J2.1, R11.2, U3.21 (B1)
BIG1: J3.1, R14.2, U3.20 (B2)
BIG2: J4.1, R17.2, U3.19 (B3)
BIG3: J5.1, R20.2, U3.18 (B4)
BIG4: J6.1, R23.2, U3.17 (B5)
BIG5: J7.1, R26.2, U3.16 (B6)
BIG6: J8.1, R29.2, U3.15 (B7)
BIG7: J9.1, R32.2, U3.14 (B8)
BIG8: J10.1, R35.2, U6.21 (B1)
BIG9: J11.1, R38.2, U6.20 (B2)
BIG10: J12.1, R41.2, U6.19 (B3)
BIG11: J13.1, R44.2, U6.18 (B4)
BIG12: J14.1, R47.2, U6.17 (B5)
BIG13: J15.1, R50.2, U6.16 (B6)
BIG14: J16.1, R53.2, U6.15 (B7)
BIG15: J17.1, R56.2, U6.14 (B8)
CS0: J2.2, R9.2, U1.21 (B1)
CS1: J3.2, R12.2, U1.20 (B2)
CS2: J4.2, R15.2, U1.19 (B3)
CS3: J5.2, R18.2, U1.18 (B4)
CS4: J6.2, R21.2, U1.17 (B5)
CS5: J7.2, R24.2, U1.16 (B6)
CS6: J8.2, R27.2, U1.15 (B7)
CS7: J9.2, R30.2, U1.14 (B8)
CS8: J10.2, R33.2, U4.21 (B1)
CS9: J11.2, R36.2, U4.20 (B2)
CS10: J12.2, R39.2, U4.19 (B3)
CS11: J13.2, R42.2, U4.18 (B4)
CS12: J14.2, R45.2, U4.17 (B5)
CS13: J15.2, R48.2, U4.16 (B6)
CS14: J16.2, R51.2, U4.15 (B7)
CS15: J17.2, R54.2, U4.14 (B8)
FB: C60.2, U11.3 (FB)
LA00_N_CC: J1.G7 (LA00_N_CC), U4.4 (A2)
LA00_P_CC: J1.G6 (LA00_P_CC), U4.3 (A1)
LA01_N_CC: J1.D9 (LA01_N_CC), U1.4 (A2)
LA01_P_CC: J1.D8 (LA01_P_CC), U1.3 (A1)
LA02_N: J1.H8 (LA02_N), U4.6 (A4)
LA02_P: J1.H7 (LA02_P), U4.5 (A3)
LA03_N: J1.G10 (LA03_N), U4.8 (A6)
LA03_P: J1.G9 (LA03_P), U4.7 (A5)
LA04_N: J1.H11 (LA04_N), U4.10 (A8)
LA04_P: J1.H10 (LA04_P), U4.9 (A7)
LA05_N: J1.D12 (LA05_N), U1.8 (A6)
LA05_P: J1.D11 (LA05_P), U1.7 (A5)
LA06_N: J1.C11 (LA06_N), U1.6 (A4)
LA06_P: J1.C10 (LA06_P), U1.5 (A3)
LA07_N: J1.H14 (LA07_N), U5.6 (A4)
LA07_P: J1.H13 (LA07_P), U5.5 (A3)
LA08_N: J1.G13 (LA08_N), U5.4 (A2)
LA08_P: J1.G12 (LA08_P), U5.3 (A1)
LA09_N: J1.D15 (LA09_N), U2.4 (A2)
LA09_P: J1.D14 (LA09_P), U1.10 (A8)
LA10_N: J1.C15 (LA10_N), U2.3 (A1)
LA10_P: J1.C14 (LA10_P), U1.9 (A7)
LA11_N: J1.H17 (LA11_N), U5.10 (A8)
LA11_P: J1.H16 (LA11_P), U5.9 (A7)
LA12_N: J1.G16 (LA12_N), U5.8 (A6)
LA12_P: J1.G15 (LA12_P), U5.7 (A5)
LA13_N: J1.D18 (LA13_N), U2.7 (A5)
LA13_P: J1.D17 (LA13_P), U2.5 (A3)
LA14_N: J1.C19 (LA14_N), U2.8 (A6)
LA14_P: J1.C18 (LA14_P), U2.6 (A4)
LA15_N: J1.H20 (LA15_N), U6.6 (A4)
LA15_P: J1.H19 (LA15_P), U6.5 (A3)
LA16_N: J1.G19 (LA16_N), U6.4 (A2)
LA16_P: J1.G18 (LA16_P), U6.3 (A1)
LA17_N_CC: J1.D21 (LA17_N_CC), U2.10 (A8)
LA17_P_CC: J1.D20 (LA17_P_CC), U2.9 (A7)
LA18_N_CC: J1.C23 (LA18_N_CC), U3.4 (A2)
LA18_P_CC: J1.C22 (LA18_P_CC), U3.3 (A1)
LA19_N: J1.H23 (LA19_N), U6.10 (A8)
LA19_P: J1.H22 (LA19_P), U6.9 (A7)
LA20_N: J1.G22 (LA20_N), U6.8 (A6)
LA20_P: J1.G21 (LA20_P), U6.7 (A5)
LA21_N: J1.H26 (LA21_N), U7.6 (A4)
LA21_P: J1.H25 (LA21_P), U7.5 (A3)
LA22_N: J1.G25 (LA22_N), U7.4 (A2)
LA22_P: J1.G24 (LA22_P), U7.3 (A1)
LA23_N: J1.D24 (LA23_N), U3.6 (A4)
LA23_P: J1.D23 (LA23_P), U3.5 (A3)
LA24_N: J1.H29 (LA24_N), U7.10 (A8)
LA24_P: J1.H28 (LA24_P), U7.9 (A7)
LA25_N: J1.G28 (LA25_N), U7.8 (A6)
LA25_P: J1.G27 (LA25_P), U7.7 (A5)
LA26_N: J1.D27 (LA26_N), U3.10 (A8)
LA26_P: J1.D26 (LA26_P), U3.8 (A6)
LA27_N: J1.C27 (LA27_N), U3.9 (A7)
LA27_P: J1.C26 (LA27_P), U3.7 (A5)
LA28_N: J1.H32 (LA28_N)
LA28_P: J1.H31 (LA28_P)
LA29_N: J1.G31 (LA29_N), U8.4 (A2)
LA29_P: J1.G30 (LA29_P), U8.3 (A1)
LA30_N: J1.H35 (LA30_N)
LA30_P: J1.H34 (LA30_P)
LA31_N: J1.G34 (LA31_N)
LA31_P: J1.G33 (LA31_P)
LA32_N: J1.H38 (LA32_N)
LA32_P: J1.H37 (LA32_P)
LA33_N: J1.G37 (LA33_N)
LA33_P: J1.G36 (LA33_P)
LED_A: D2.2 (A), R73.2
NR: C59.1, U11.13 (NR/SS)
SB0: R57.1, U9.18 (1Y1)
SB1: R58.1, U9.16 (1Y2)
SB2: R59.1, U9.14 (1Y3)
SB3: R60.1, U9.12 (1Y4)
SB4: R61.1, U9.9 (2Y1)
SB5: R62.1, U9.7 (2Y2)
SB6: R63.1, U9.5 (2Y3)
SB7: R64.1, U9.3 (2Y4)
SB8: R65.1, U10.18 (1Y1)
SB9: R66.1, U10.16 (1Y2)
SB10: R67.1, U10.14 (1Y3)
SB11: R68.1, U10.12 (1Y4)
SB12: R69.1, U10.9 (2Y1)
SB13: R70.1, U10.7 (2Y2)
SB14: R71.1, U10.5 (2Y3)
SB15: R72.1, U10.3 (2Y4)
SCLK0: J2.8, R57.2
SCLK1: J3.8, R58.2
SCLK2: J4.8, R59.2
SCLK3: J5.8, R60.2
SCLK4: J6.8, R61.2
SCLK5: J7.8, R62.2
SCLK6: J8.8, R63.2
SCLK7: J9.8, R64.2
SCLK8: J10.8, R65.2
SCLK9: J11.8, R66.2
SCLK10: J12.8, R67.2
SCLK11: J13.8, R68.2
SCLK12: J14.8, R69.2
SCLK13: J15.8, R70.2
SCLK14: J16.8, R71.2
SCLK15: J17.8, R72.2
SCLK_A: U8.21 (B1), U9.2 (1A1), U9.4 (1A2), U9.6 (1A3), U9.8 (1A4), U9.11 (2A1), U9.13 (2A2), U9.15 (2A3), U9.17 (2A4)
SCLK_B: U8.20 (B2), U10.2 (1A1), U10.4 (1A2), U10.6 (1A3), U10.8 (1A4), U10.11 (2A1), U10.13 (2A2), U10.15 (2A3), U10.17 (2A4)
SDO0: J2.6, J3.6, R1.1, U7.21 (B1)
SDO1: J4.6, J5.6, R2.1, U7.20 (B2)
SDO2: J6.6, J7.6, R3.1, U7.19 (B3)
SDO3: J8.6, J9.6, R4.1, U7.18 (B4)
SDO4: J10.6, J11.6, R5.1, U7.17 (B5)
SDO5: J12.6, J13.6, R6.1, U7.16 (B6)
SDO6: J14.6, J15.6, R7.1, U7.15 (B7)
SDO7: J16.6, J17.6, R8.1, U7.14 (B8)
VADJ: C1.1, C3.1, C5.1, C7.1, C9.1, C11.1, C13.1, C15.1, C17.1, C18.1, J1.G39 (VADJ), J1.H40 (VADJ), TP4.1, U1.1 (VCCA), U1.2 (DIR), U2.1 (VCCA), U3.1 (VCCA), U4.1 (VCCA), U4.2 (DIR), U5.1 (VCCA), U6.1 (VCCA), U7.1 (VCCA), U8.1 (VCCA), U8.2 (DIR)
WAKE0: J2.7, R10.2, U2.21 (B1)
WAKE1: J3.7, R13.2, U2.20 (B2)
WAKE2: J4.7, R16.2, U2.19 (B3)
WAKE3: J5.7, R19.2, U2.18 (B4)
WAKE4: J6.7, R22.2, U2.17 (B5)
WAKE5: J7.7, R25.2, U2.16 (B6)
WAKE6: J8.7, R28.2, U2.15 (B7)
WAKE7: J9.7, R31.2, U2.14 (B8)
WAKE8: J10.7, R34.2, U5.21 (B1)
WAKE9: J11.7, R37.2, U5.20 (B2)
WAKE10: J12.7, R40.2, U5.19 (B3)
WAKE11: J13.7, R43.2, U5.18 (B4)
WAKE12: J14.7, R46.2, U5.17 (B5)
WAKE13: J15.7, R49.2, U5.16 (B6)
WAKE14: J16.7, R52.2, U5.15 (B7)
WAKE15: J17.7, R55.2, U5.14 (B8)

Notes on the sheet:
16-channel backplane for the ADS7057 channel cards
One board. The FMC plug (ZedBoard LPC) is on the left. Eight SN74LVC8T245 level shifters (A side VADJ, any of 1.8 / 2.5 / 3.3 V; B side the board's 3.3 V) feed a 4 x 4 matrix of vertical 2x6 sockets. Slot k = 4 * row + column.
58 lines: 18 outputs (16 CS, 2 SCLK), 40 inputs (16 WAKE_N, 16 BIG_N, 8 SDO lanes; slots 2j and 2j+1 share lane j). SCLK of slots 0-7 and 8-15 each pass a SN74LVC244A with 22 R per branch. 100 k pull-ups keep CS, WAKE_N and BIG_N high on an empty slot.
Socket pads are not the card pin numbers (the header rows swap): card pin 1 CS -> pad 2, pin 2 BIG_N -> pad 1, pin 5 SDO -> pad 6, pin 7 SCLK -> pad 8, pin 8 WAKE_N -> pad 7. Insert each card with its components facing +X. PRSNT_M2C_L grounded, TDI tied to TDO.

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
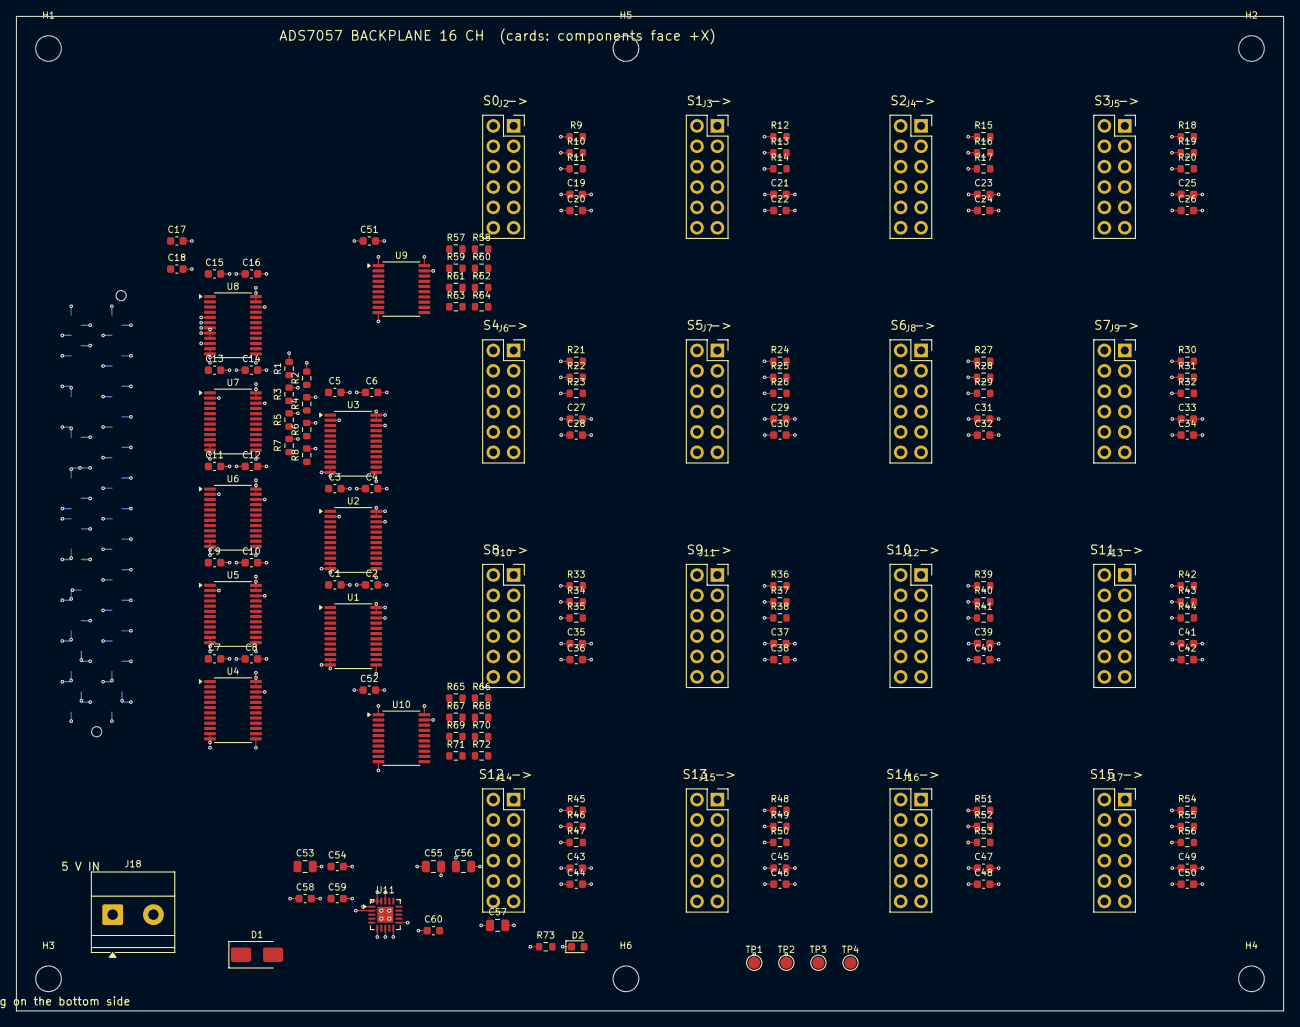
[picture p250: board BP16.kicad_pcb from above]

Board: 6 copper layers, 158.0 x 124.0 mm, 174 parts (1 on the bottom side), 157 nets.
