auselia/adc_test_board/hw/backplane/BP_Module.kicad_pcb

## KiCad design hw/backplane/BP_Module.kicad_pcb (2026-10-20)

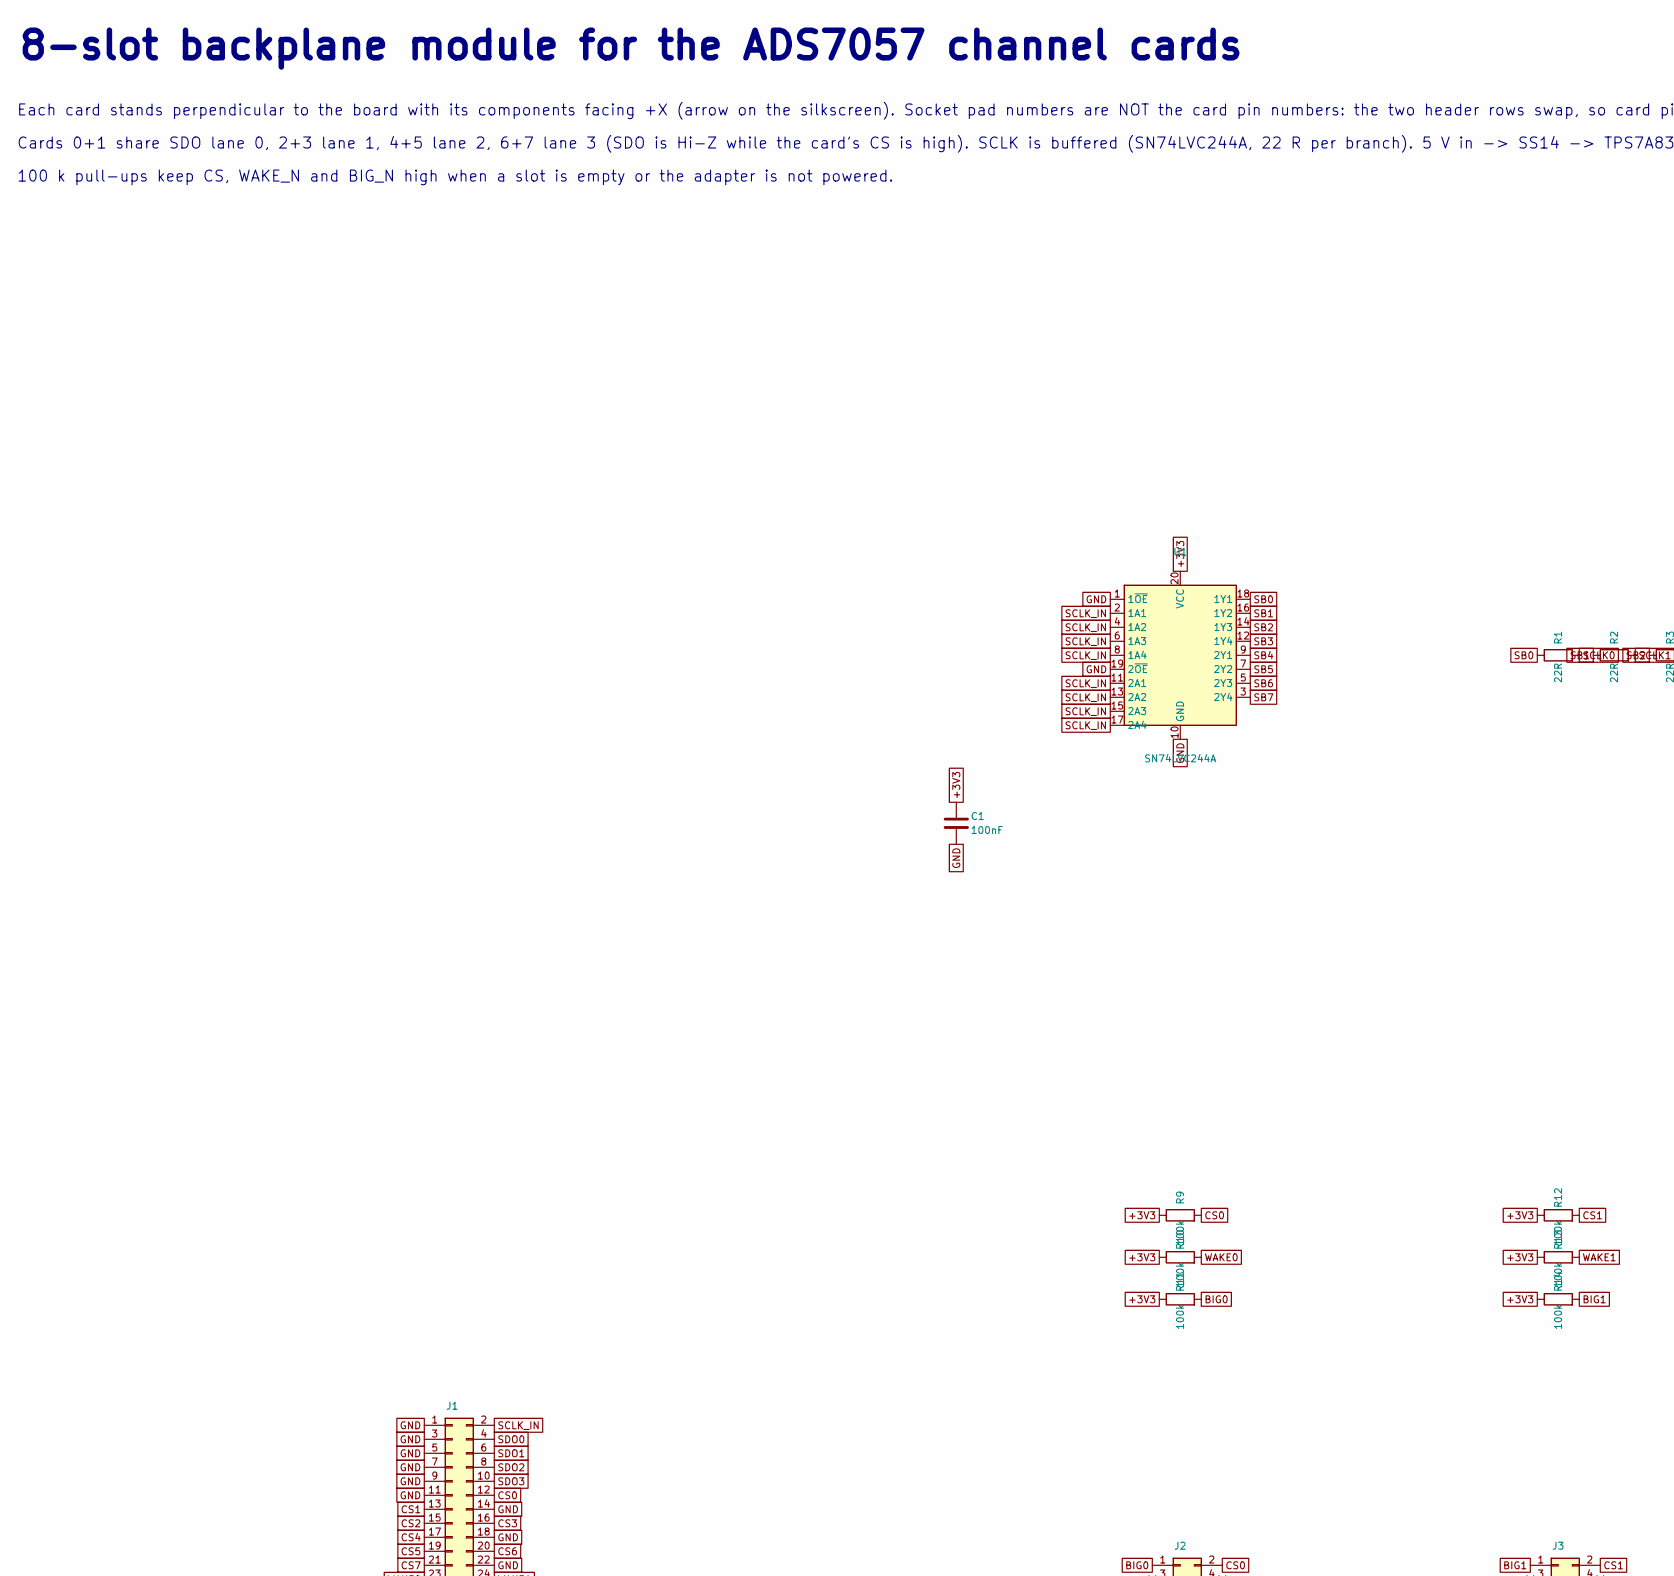
[picture p251: schematic BP_Module.kicad_sch, ADS7057 backplane module, 8 slots (16 channels = two module…, part in row 1, column 1]

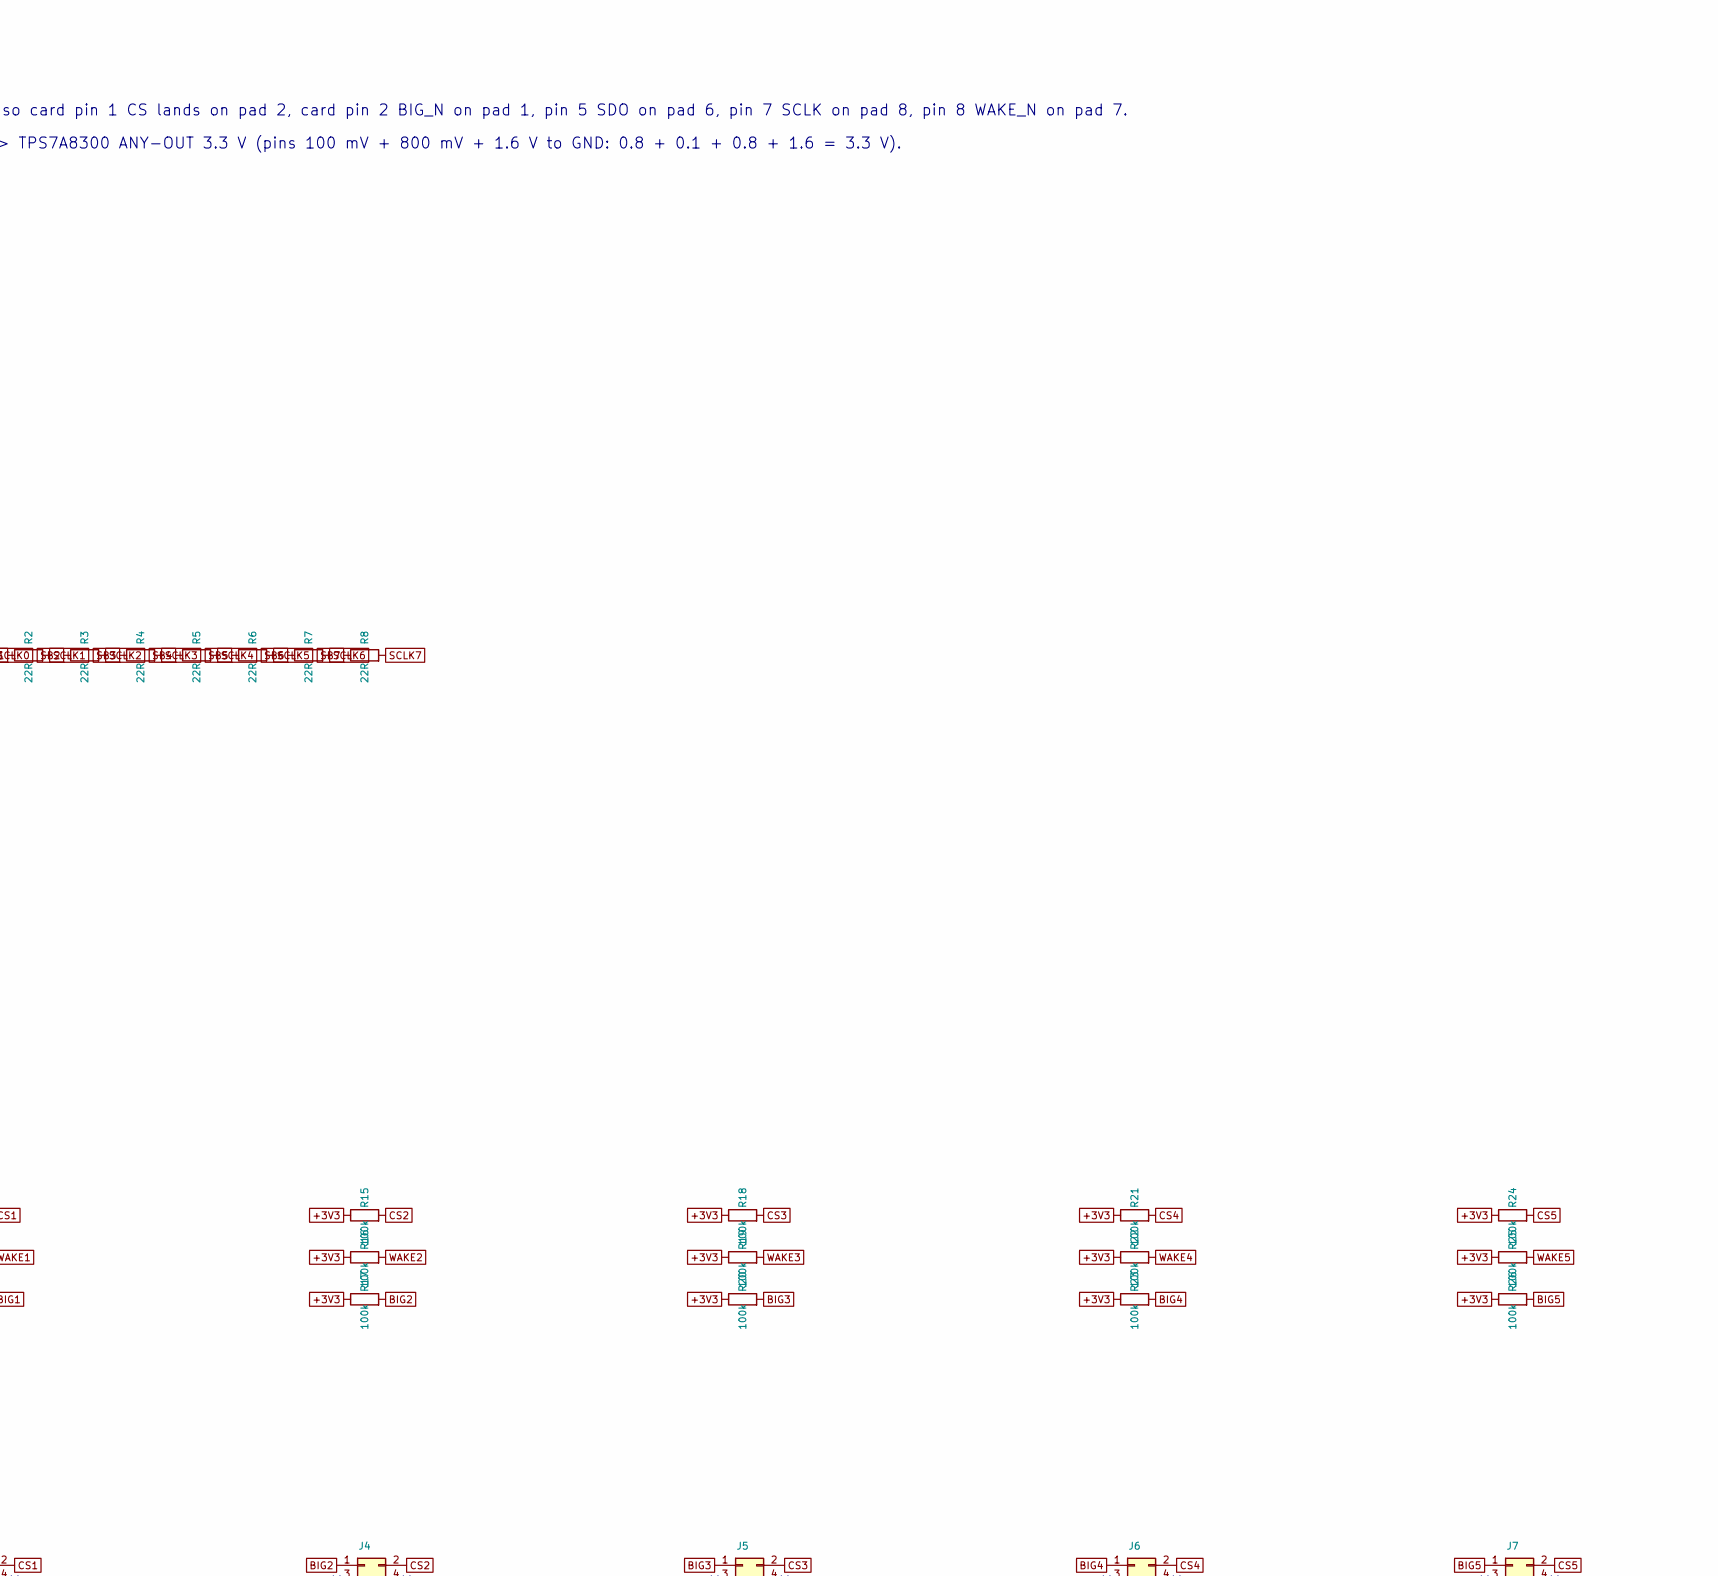
[picture p252: schematic BP_Module.kicad_sch, ADS7057 backplane module, 8 slots (16 channels = two module…, part in row 1, column 2]

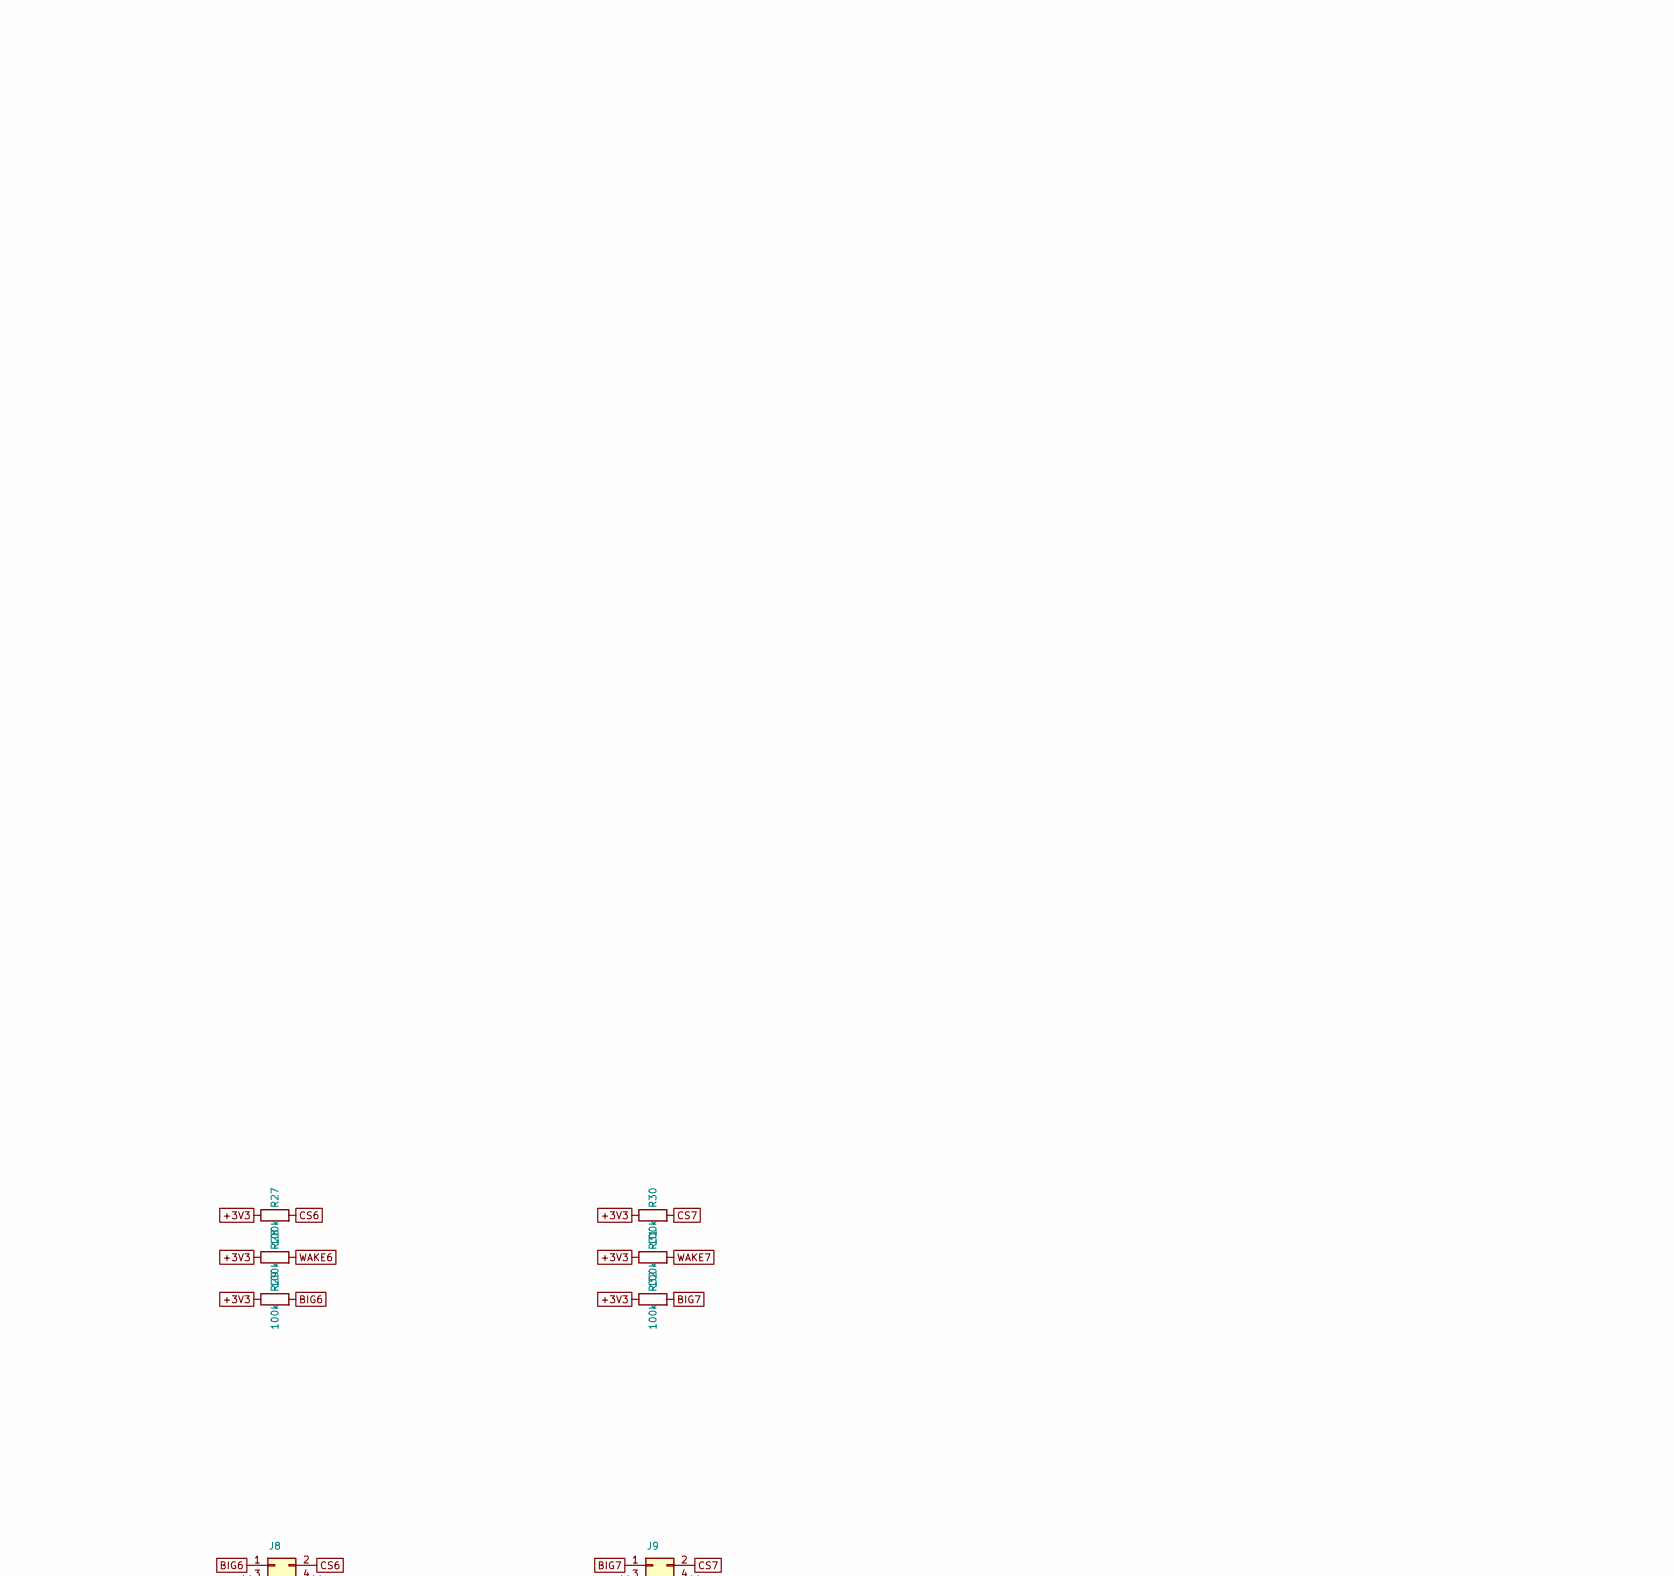
[picture p253: schematic BP_Module.kicad_sch, ADS7057 backplane module, 8 slots (16 channels = two module…, part in row 1, column 3]

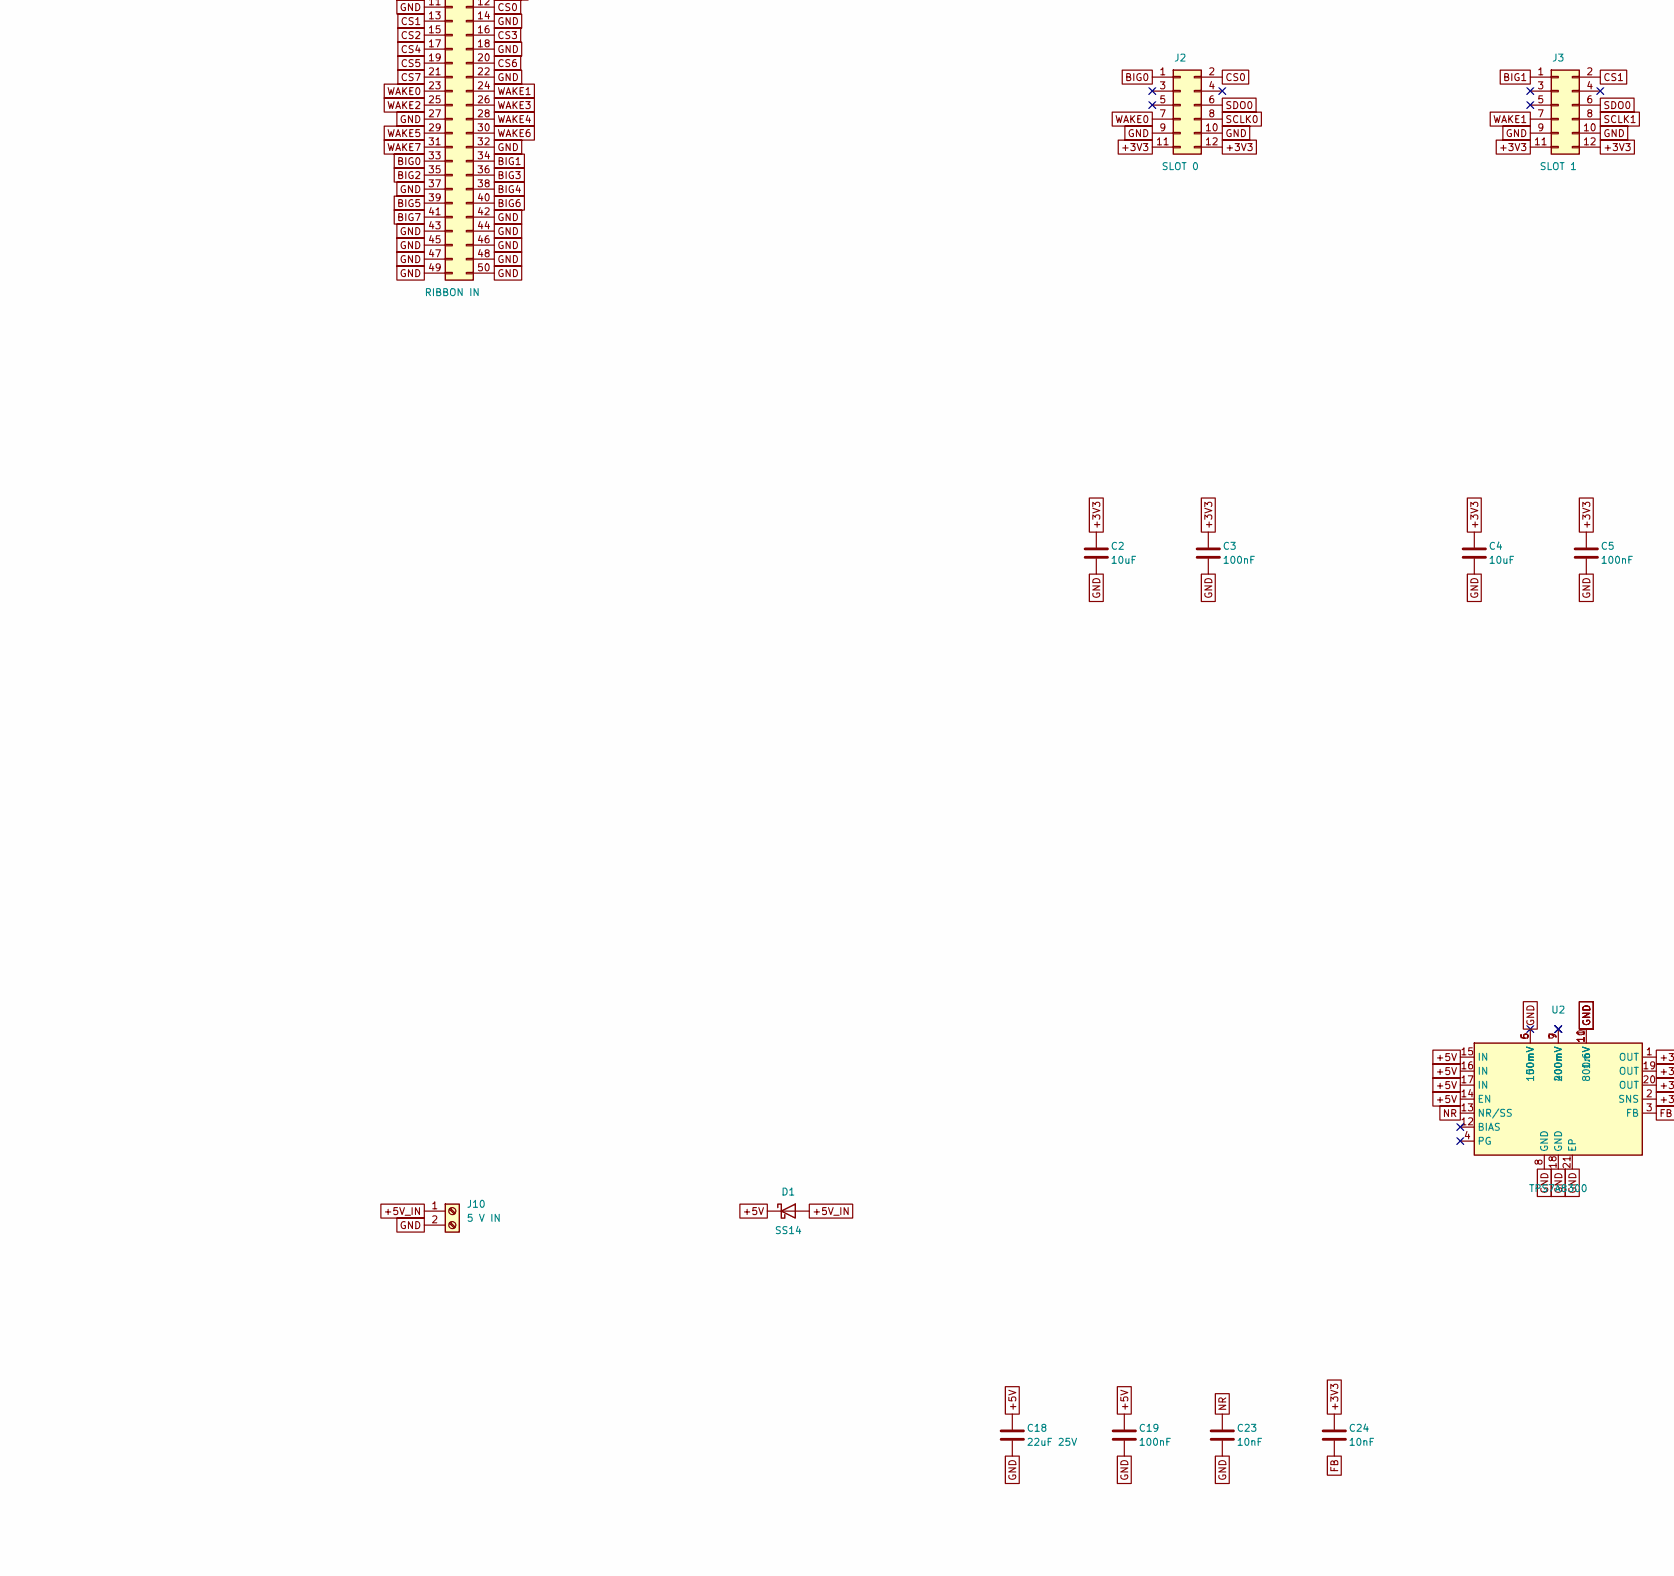
[picture p254: schematic BP_Module.kicad_sch, ADS7057 backplane module, 8 slots (16 channels = two module…, part in row 2, column 1]

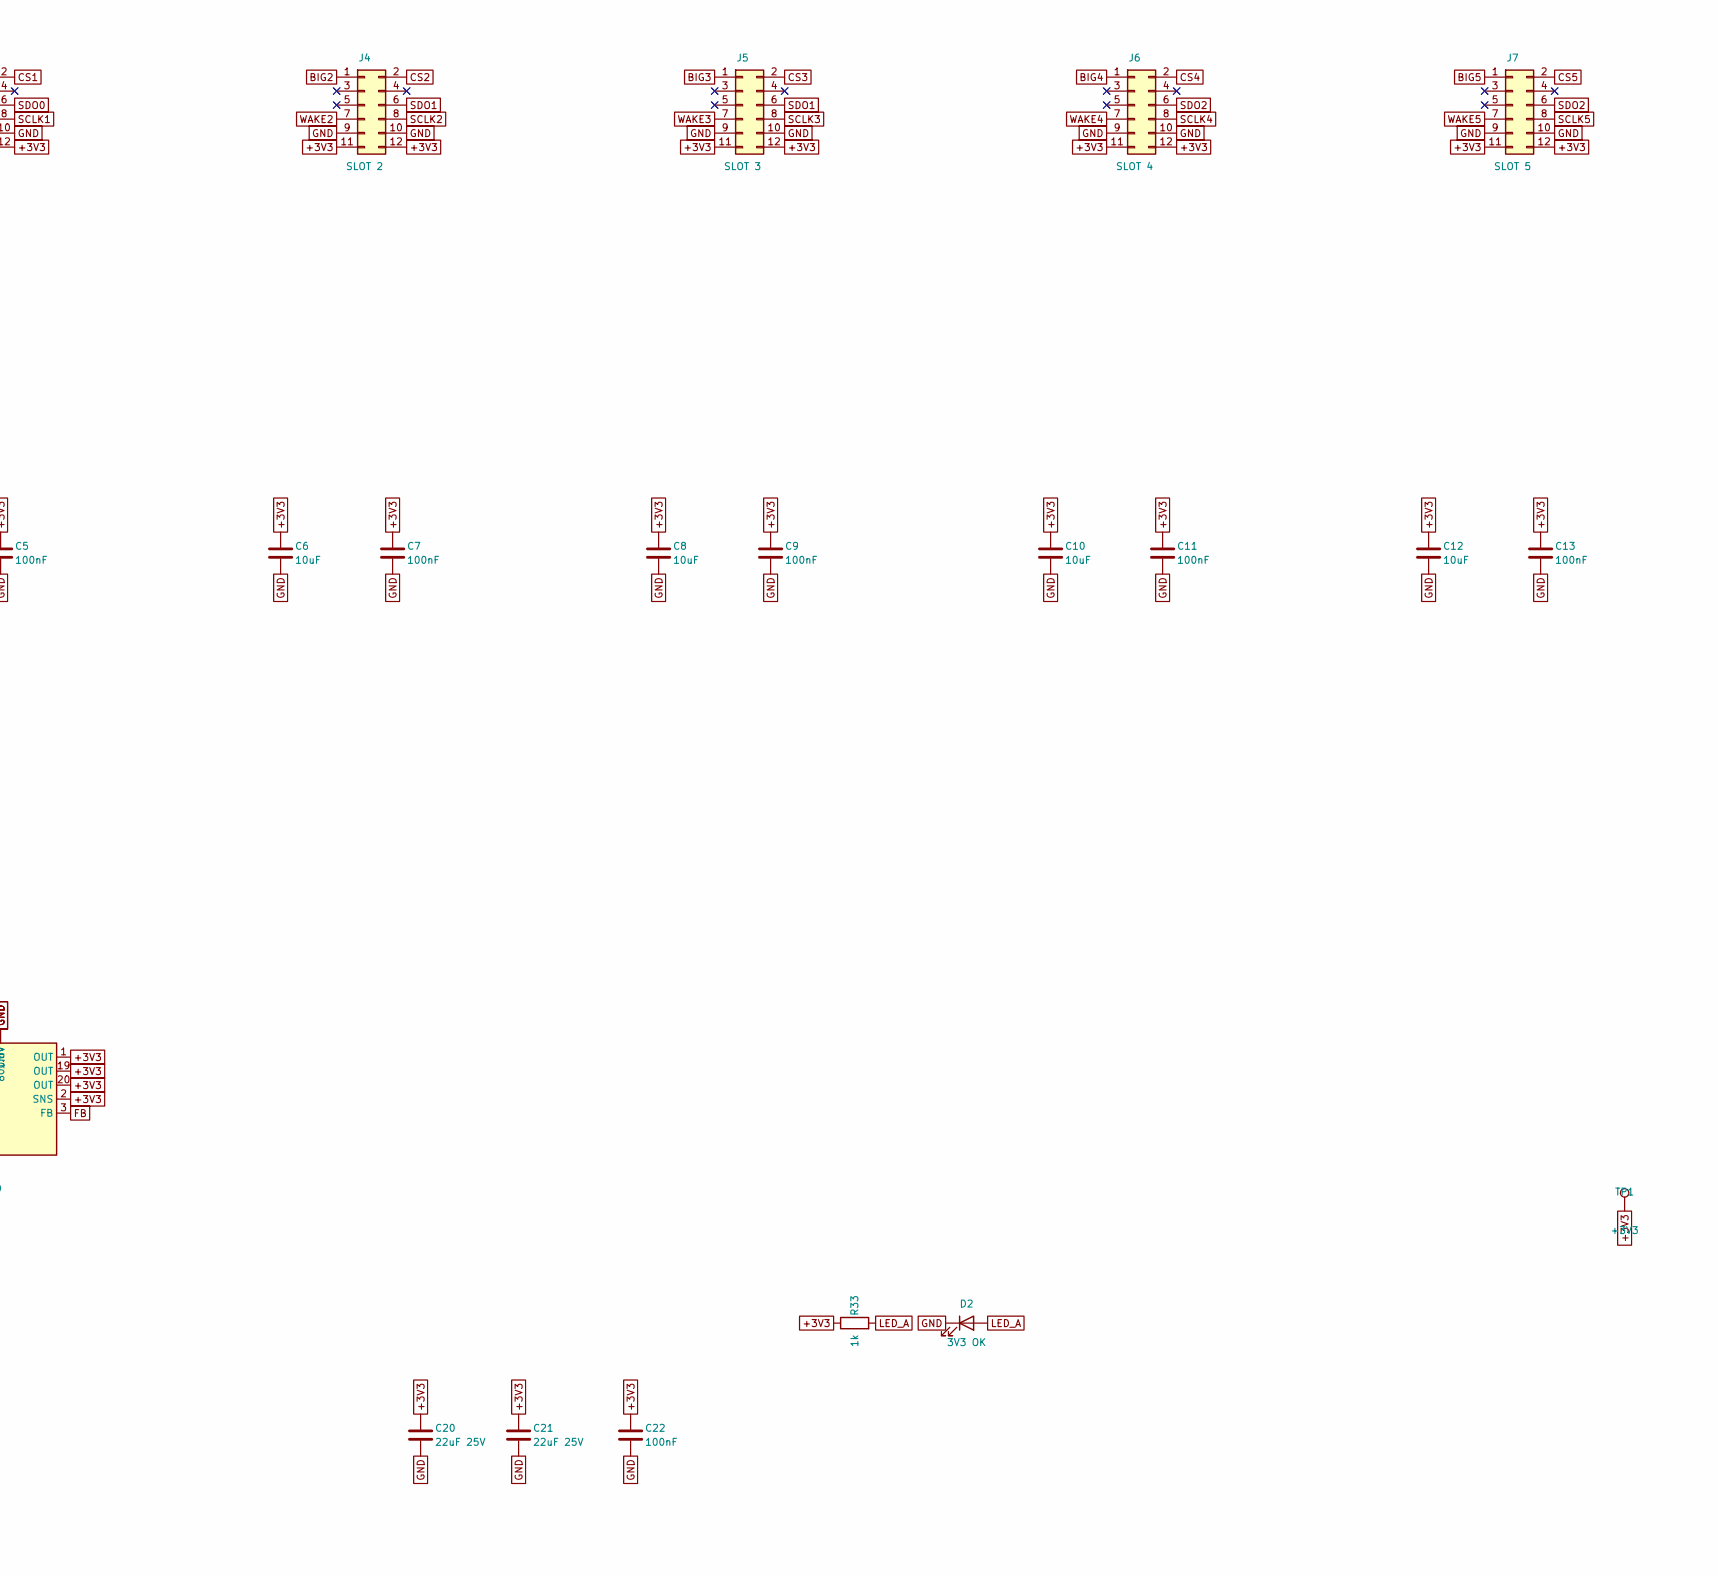
[picture p255: schematic BP_Module.kicad_sch, ADS7057 backplane module, 8 slots (16 channels = two module…, part in row 2, column 2]

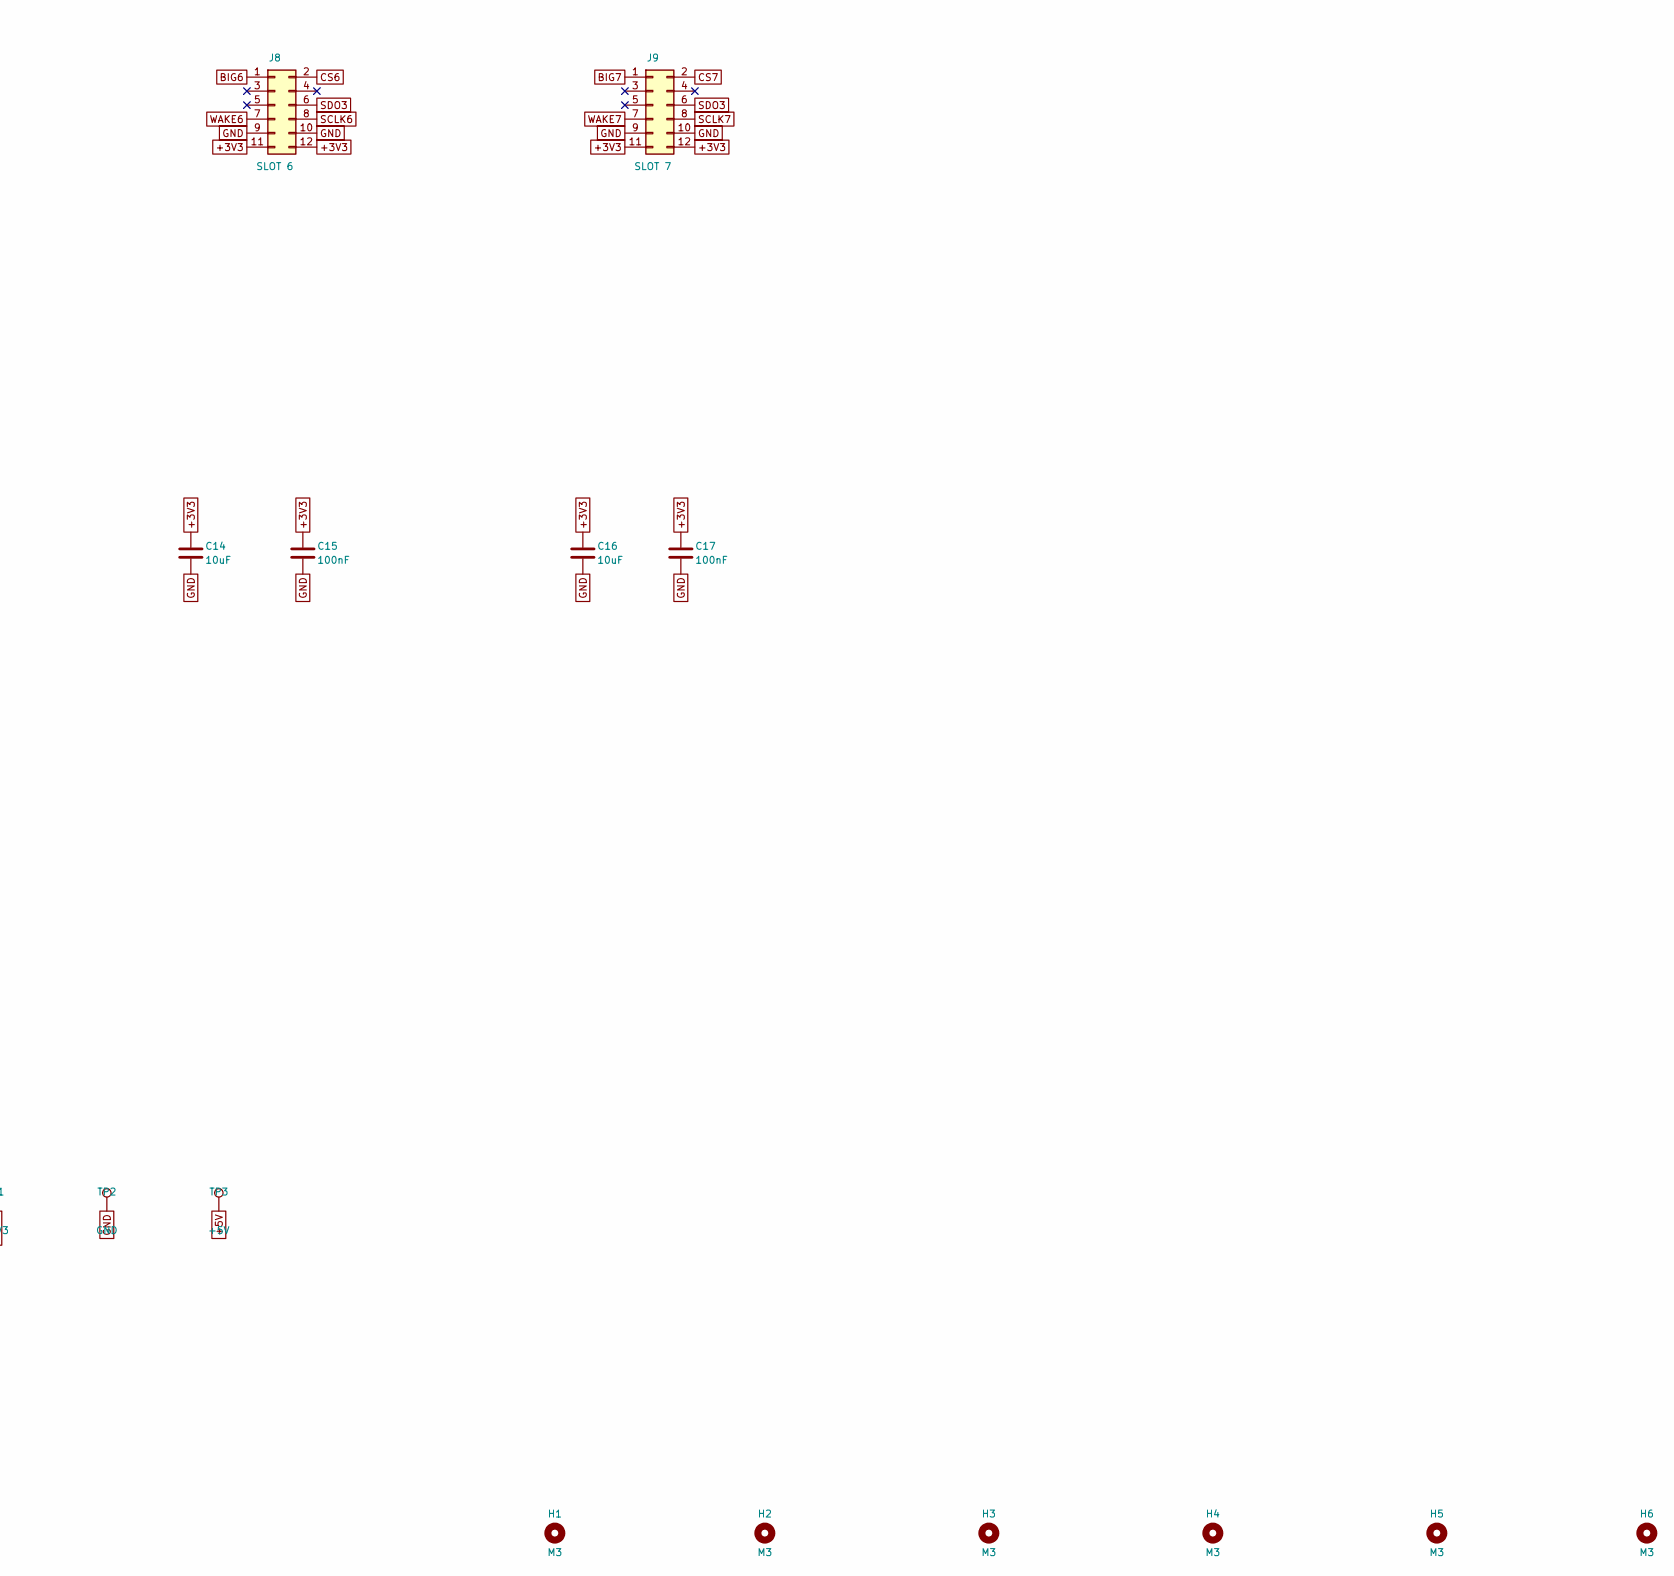
[picture p256: schematic BP_Module.kicad_sch, ADS7057 backplane module, 8 slots (16 channels = two module…, part in row 2, column 3]

Parts:
C1, C3, C5, C7, C9, C11, C13, C15, C17, C19, C22: 100nF; C_0603_1608Metric; LCSC C14663
C2, C4, C6, C8, C10, C12, C14, C16: 10uF; C_0603_1608Metric; LCSC C19702
C18, C20, C21: 22uF 25V; C_0805_2012Metric; LCSC C45783
C23, C24: 10nF; C_0603_1608Metric; LCSC C57112
D1: SS14; D_SMA; LCSC C2480
D2: 3V3 OK; LED_0603_1608Metric; LCSC C2286
H1, H2, H3, H4, H5, H6: M3; MountingHole_3.2mm_M3
J1: RIBBON IN; IDC-Header_2x25_P2.54mm_Vertical; LCSC C19193816
J2: SLOT 0; PinSocket_2x06_P2.54mm_Vertical; LCSC C36191
J3: SLOT 1; PinSocket_2x06_P2.54mm_Vertical; LCSC C36191
J4: SLOT 2; PinSocket_2x06_P2.54mm_Vertical; LCSC C36191
J5: SLOT 3; PinSocket_2x06_P2.54mm_Vertical; LCSC C36191
J6: SLOT 4; PinSocket_2x06_P2.54mm_Vertical; LCSC C36191
J7: SLOT 5; PinSocket_2x06_P2.54mm_Vertical; LCSC C36191
J8: SLOT 6; PinSocket_2x06_P2.54mm_Vertical; LCSC C36191
J9: SLOT 7; PinSocket_2x06_P2.54mm_Vertical; LCSC C36191
J10: 5 V IN; TerminalBlock_Phoenix_MKDS-1,5-2-5.08_1x02_P5.08mm_Horizont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; LCSC C8465
R1, R2, R3, R4, R5, R6, R7, R8: 22R; R_0603_1608Metric; LCSC C23345
R9, R10, R11, R12, R13, R14, R15, R16, R17, R18, R19, R20, R21, R22, R23, R24, R25, R26, R27, R28, R29, R30, R31, R32: 100k; R_0603_1608Metric; LCSC C25803
R33: 1k; R_0603_1608Metric; LCSC C21190
TP1: +3V3; TestPoint_Pad_D1.5mm
TP2: GND; TestPoint_Pad_D1.5mm
TP3: +5V; TestPoint_Pad_D1.5mm
U1: SN74LVC244A; TSSOP-20_4.4x6.5mm_P0.65mm; LCSC C7668
U2: TPS7A8300; QFN-20-1EP_3.5x3.5mm_P0.5mm_EP2x2mm; LCSC C544500

Connections:
+3V3: C1.1, C2.1, C3.1, C4.1, C5.1, C6.1, C7.1, C8.1, C9.1, C10.1, C11.1, C12.1, C13.1, C14.1, C15.1, C16.1, C17.1, C20.1, C21.1, C22.1, C24.1, J2.11, J2.12, J3.11, J3.12, J4.11, J4.12, J5.11, J5.12, J6.11, J6.12, J7.11, J7.12, J8.11, J8.12, J9.11, J9.12, R9.1, R10.1, R11.1, R12.1, R13.1, R14.1, R15.1, R16.1, R17.1, R18.1, R19.1, R20.1, R21.1, R22.1, R23.1, R24.1, R25.1, R26.1, R27.1, R28.1, R29.1, R30.1, R31.1, R32.1, R33.1, TP1.1, U1.20 (VCC), U2.1 (OUT), U2.2 (SNS), U2.19 (OUT), U2.20 (OUT)
+5V: C18.1, C19.1, D1.1 (K), TP3.1, U2.14 (EN), U2.15 (IN), U2.16 (IN), U2.17 (IN)
+5V_IN: D1.2 (A), J10.1
BIG0: J1.33, J2.1, R11.2
BIG1: J1.34, J3.1, R14.2
BIG2: J1.35, J4.1, R17.2
BIG3: J1.36, J5.1, R20.2
BIG4: J1.38, J6.1, R23.2
BIG5: J1.39, J7.1, R26.2
BIG6: J1.40, J8.1, R29.2
BIG7: J1.41, J9.1, R32.2
CS0: J1.12, J2.2, R9.2
CS1: J1.13, J3.2, R12.2
CS2: J1.15, J4.2, R15.2
CS3: J1.16, J5.2, R18.2
CS4: J1.17, J6.2, R21.2
CS5: J1.19, J7.2, R24.2
CS6: J1.20, J8.2, R27.2
CS7: J1.21, J9.2, R30.2
FB: C24.2, U2.3 (FB)
GND: C1.2, C2.2, C3.2, C4.2, C5.2, C6.2, C7.2, C8.2, C9.2, C10.2, C11.2, C12.2, C13.2, C14.2, C15.2, C16.2, C17.2, C18.2, C19.2, C20.2, C21.2, C22.2, C23.2, D2.1 (K), J1.1, J1.3, J1.5, J1.7, J1.9, J1.11, J1.14, J1.18, J1.22, J1.27, J1.32, J1.37, J1.42, J1.43, J1.44, J1.45, J1.46, J1.47, J1.48, J1.49, J1.50, J2.9, J2.10, J3.9, J3.10, J4.9, J4.10, J5.9, J5.10, J6.9, J6.10, J7.9, J7.10, J8.9, J8.10, J9.9, J9.10, J10.2, TP2.1, U1.1 (1~OE), U1.10 (GND), U1.19 (2~OE), U2.5 (50mV), U2.6 (100mV), U2.8 (GND), U2.10 (800mV), U2.11 (1.6V), U2.18 (GND), U2.21 (EP)
LED_A: D2.2 (A), R33.2
NR: C23.1, U2.13 (NR/SS)
SB0: R1.1, U1.18 (1Y1)
SB1: R2.1, U1.16 (1Y2)
SB2: R3.1, U1.14 (1Y3)
SB3: R4.1, U1.12 (1Y4)
SB4: R5.1, U1.9 (2Y1)
SB5: R6.1, U1.7 (2Y2)
SB6: R7.1, U1.5 (2Y3)
SB7: R8.1, U1.3 (2Y4)
SCLK0: J2.8, R1.2
SCLK1: J3.8, R2.2
SCLK2: J4.8, R3.2
SCLK3: J5.8, R4.2
SCLK4: J6.8, R5.2
SCLK5: J7.8, R6.2
SCLK6: J8.8, R7.2
SCLK7: J9.8, R8.2
SCLK_IN: J1.2, U1.2 (1A1), U1.4 (1A2), U1.6 (1A3), U1.8 (1A4), U1.11 (2A1), U1.13 (2A2), U1.15 (2A3), U1.17 (2A4)
SDO0: J1.4, J2.6, J3.6
SDO1: J1.6, J4.6, J5.6
SDO2: J1.8, J6.6, J7.6
SDO3: J1.10, J8.6, J9.6
WAKE0: J1.23, J2.7, R10.2
WAKE1: J1.24, J3.7, R13.2
WAKE2: J1.25, J4.7, R16.2
WAKE3: J1.26, J5.7, R19.2
WAKE4: J1.28, J6.7, R22.2
WAKE5: J1.29, J7.7, R25.2
WAKE6: J1.30, J8.7, R28.2
WAKE7: J1.31, J9.7, R31.2

Notes on the sheet:
8-slot backplane module for the ADS7057 channel cards
Each card stands perpendicular to the board with its components facing +X (arrow on the silkscreen). Socket pad numbers are NOT the card pin numbers: the two header rows swap, so card pin 1 CS lands on pad 2, card pin 2 BIG_N on pad 1, pin 5 SDO on pad 6, pin 7 SCLK on pad 8, pin 8 WAKE_N on pad 7.
Cards 0+1 share SDO lane 0, 2+3 lane 1, 4+5 lane 2, 6+7 lane 3 (SDO is Hi-Z while the card's CS is high). SCLK is buffered (SN74LVC244A, 22 R per branch). 5 V in -> SS14 -> TPS7A8300 ANY-OUT 3.3 V (pins 100 mV + 800 mV + 1.6 V to GND: 0.8 + 0.1 + 0.8 + 1.6 = 3.3 V).
100 k pull-ups keep CS, WAKE_N and BIG_N high when a slot is empty or the adapter is not powered.

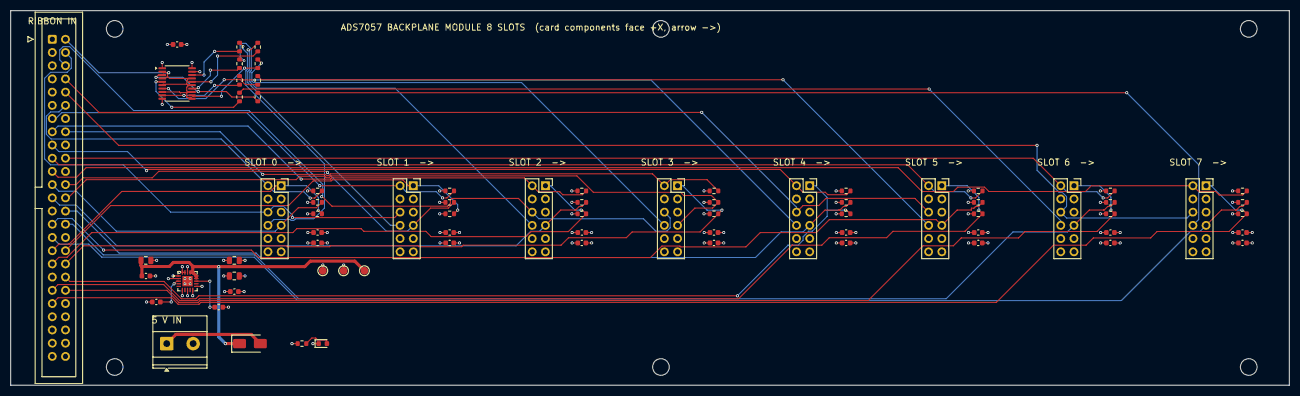
[picture p257: board BP_Module.kicad_pcb from above]

Board: 4 copper layers, 245.8 x 72.0 mm, 80 parts (0 on the bottom side), 52 nets.
