auselia/adc_test_board/sim/diff_vs_se_results.txt

A single-ended g250 4.10 (12.3 dB)
  gain re 250k (dB): 10000:-40.5 30000:-21.5 100000:-3.1 250000:0.0 500000:-2.8 1000000:-12.1 2000000:-24.0
  supply to ADC diff (mV per V): 10000:2.78 30000:3.39 100000:14.69 250000:27.98 500000:33.54 1000000:17.99 2000000:12.67
  own noise 100-500k at ADC: 49.9 uV rms = 0.12 LSB
A2 single-ended, VMID5 from AVDD g250 4.10 (12.3 dB)
  gain re 250k (dB): 10000:-40.5 30000:-21.5 100000:-3.1 250000:0.0 500000:-2.8 1000000:-12.1 2000000:-24.0
  supply to ADC diff (mV per V): 10000:3.03 30000:3.39 100000:14.68 250000:27.98 500000:33.54 1000000:17.99 2000000:12.67
  own noise 100-500k at ADC: 49.9 uV rms = 0.12 LSB
A3 single-ended, op-amp supply filter 2.2R+22uF g250 4.10 (12.3 dB)
  gain re 250k (dB): 10000:-40.5 30000:-21.5 100000:-3.1 250000:0.0 500000:-2.8 1000000:-12.1 2000000:-24.0
  supply to ADC diff (mV per V): 10000:2.57 30000:0.61 100000:0.51 250000:0.37 500000:0.22 1000000:0.06 2000000:0.02
  own noise 100-500k at ADC: 49.9 uV rms = 0.12 LSB
B differential g250 3.92 (11.9 dB)
  gain re 250k (dB): 10000:-40.4 30000:-21.3 100000:-2.9 250000:0.0 500000:-3.8 1000000:-13.5 2000000:-24.3
  supply to ADC diff (mV per V): 10000:0.09 30000:0.09 100000:0.07 250000:0.02 500000:0.00 1000000:0.00 2000000:0.00
  own noise 100-500k at ADC: 41.9 uV rms = 0.10 LSB
