auselia/adc_test_board/(commit log)

2026-10-12 ADS7057 test board: low-cost JLCPCB version
    SMA (perfboard) -> HPF 113 kHz -> gain 4.9 -> LPF 512 kHz -> THS4531 ->
    ADS7057 -> ZedBoard PMOD, plus LM393 window comparator (nWAKE) and a
    9 V -> 5 V -> 3.3 V supply. Built with the afe_pcb tool flow (Python
    schematic generator, Freerouting). DRC/ERC clean. Includes Gerbers,
    JLC BOM/CPL and a cost script (hw/tools/cost.py).
    [ADC_Test-B_Cu.gbl, ADC_Test-B_Mask.gbs, ADC_Test-B_Silkscreen.gbo, ADC_Test-Edge_Cuts.gm1, ADC_Test-F_Cu.gtl, ADC_Test-F_Mask.gts, ADC_Test-F_Paste.gtp, ADC_Test-F_Silkscreen.gto]
2026-10-12 README: cost summary for 2, 3 and 5 assembled boards
2026-10-12 Add MON output, nWAKE DNP cap, ceramic-stable AVDD LDO, M3 holes
    - J4 SMA MON: LPF_OUT through 51R (Basic C23197)
    - C31 0603 DNP on nWAKE near J3
    - AVDD: XC6206P332 (Basic, ceramic-stable) replaces AMS1117-3.3
    - 5 V AMS1117: 22 uF tantalum output per datasheet
    - H1/H2 M3 holes, CH silkscreen field, PMOD legend on the back
    - README: uses, regulator decision, MON/DNP
    [ADC_Test-B_Cu.gbl, ADC_Test-B_Mask.gbs, ADC_Test-B_Silkscreen.gbo, ADC_Test-Edge_Cuts.gm1, ADC_Test-F_Cu.gtl, ADC_Test-F_Mask.gts, ADC_Test-F_Paste.gtp, ADC_Test-F_Silkscreen.gto]
2026-10-12 Put through-hole parts back in the JLC assembly, apply JLC rotation offsets
    - BOM/CPL now include J1-J4 and RV1 (C496549, C492401, C60565, C34845)
    - CPL rotations: SOIC +270, SOT-23 -90, SOT-223 +180, tantalum +180
    - cost.py reads the BOM and compares JLC-soldered vs self-soldered THT
    - finish.py: removes dangling GND stubs, solid GND connection for
    starved thermal pads, joint counts exported by fab.sh
    - README: cost table for 2/3/5 boards, through-hole section
    [ADC_Test-B_Cu.gbl, ADC_Test-B_Mask.gbs, ADC_Test-B_Silkscreen.gbo, ADC_Test-Edge_Cuts.gm1, ADC_Test-F_Cu.gtl, ADC_Test-F_Mask.gts, ADC_Test-F_Paste.gtp, ADC_Test-F_Silkscreen.gto]
2026-10-12 Silkscreen labels and logo, SMA 3D model, ngspice check
    - front labels: SENSOR IN, SCOPE OUT, WAKE LEVEL, +9V/GND, CH box
    - Auselia mark and name on the front, title on the back
    - SMA footprint: 132134-11 (same pads, KiCad ships its 3D model)
    - sim/adc_chain.py: DC, AC, noise and comparator window check
    - README: silkscreen legend and simulation results
    [ADC_Test-B_Cu.gbl, ADC_Test-B_Mask.gbs, ADC_Test-B_Silkscreen.gbo, ADC_Test-Edge_Cuts.gm1, ADC_Test-F_Cu.gtl, ADC_Test-F_Mask.gts, ADC_Test-F_Paste.gtp, ADC_Test-F_Silkscreen.gto]
2026-10-12 Calibrate cost on the real JLCPCB quote, fix CPL rotations from the placement viewer
    - real 5-board quote: PCB $4.00 + PCBA $110.36 (no X-ray, no extended fee for THT)
    - CPL: U5 180, C29 0, J2 90, J3 90 (viewer showed these rotated)
    - BOM: one line per connector part (JLC warned about duplicate SMA lines)
    - cost.py reproduces the quote, README documents it
    [ADC_Test_BOM_JLC.csv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]
2026-10-12 CPL: shift RV1 to match JLC's model origin
    The JLC placement viewer drew the trimmer 2.5 mm right and 1 mm low,
    overhanging the board edge. Offset in hw/tools/jlc_files.py (POS_OFF).
    [ADC_Test_CPL_JLC.csv]
2026-10-13 Vendor-model verification suite, LTspice netlist, SPI power-up notes
    - sim/vendor_chain.py: DC, AC, noise, Monte Carlo (150 runs), burst transient,
    ADC acquisition settling, cable load. OPA365 is TI's model.
    - THS4531 vendor model fails in ngspice; LTspice netlist provided
    - README: verification table, bring-up steps, SPI frame notes
    (24-SCLK offset calibration at power-up, one-frame output latency)
2026-10-13 README: verification table, bring-up steps, SPI power-up notes
    - 24-SCLK offset calibration in the first frame, one-frame output latency
    - sim/models/SOURCES.md
2026-10-15 1:1 print sheet of the board and the manual plan
    - hw/tools/print_1to1.sh/.py: Letter sheet with a 100 mm scale bar, top, reference
    designators, bottom (needs PyMuPDF)
    - hw/preview/ADC_Test_print_1to1_letter.pdf
    - doc/manual_plan.md: plan for the hardware manual, following manual_method.md
2026-10-15 Add 54-step hardware manual (doc/), figures from board and simulation data
2026-10-15 Manual: fix divider title overflow, add 3:1 top-view render page after step 44
    [adc_part_d.py, adc_part_e.py, m4lib.py]
2026-10-15 Sensor head board with bias-T (HEAD IN), two separate boards, manual v0.2
    - ADC_Head: perfboard charge amp (OPA365, 47 pF, 1M) on 10 x 22 mm, powered through the coax
    - ADC_Test: 64 x 32 mm, new HEAD IN SMA with bias-T (L2, R26, C32, C33, R27), SENSOR IN kept
    - build scripts take BOARD=head, two sets of fab files, cost model for two orders
    - sim/head_bias_t.py (OPA365 model), sim/ths4531_stability_estimate.py
    - manual v0.2: board figures regenerated, new section 9 (steps 55 to 60), top view page
    [ADC_Head-B_Cu.gbl, ADC_Head-B_Mask.gbs, ADC_Head-B_Silkscreen.gbo, ADC_Head-Edge_Cuts.gm1, ADC_Head-F_Cu.gtl, ADC_Head-F_Mask.gts, ADC_Head-F_Paste.gtp, ADC_Head-F_Silkscreen.gto]
2026-10-15 One SMA input: the bias-T sits on SENSOR IN (J1), HEAD IN removed; board back to 57 x 32 mm, re-placed and re-routed; manual and README updated
    [ADC_Head-B_Cu.gbl, ADC_Head-B_Mask.gbs, ADC_Head-B_Silkscreen.gbo, ADC_Head-Edge_Cuts.gm1, ADC_Head-F_Cu.gtl, ADC_Head-F_Mask.gts, ADC_Head-F_Paste.gtp, ADC_Head-F_Silkscreen.gto]
2026-10-15 Solder jumper JP1 in the head power feed (cut it to use a generator on SENSOR IN); re-routed, files and manual regenerated
    [ADC_Head-B_Cu.gbl, ADC_Head-B_Mask.gbs, ADC_Head-B_Silkscreen.gbo, ADC_Head-Edge_Cuts.gm1, ADC_Head-F_Cu.gtl, ADC_Head-F_Mask.gts, ADC_Head-F_Paste.gtp, ADC_Head-F_Silkscreen.gto]
2026-10-15 Manual: rendered views of the sensor head (top 4:1, angled, 1:1)
2026-10-15 5 V input (USB-C and header, SS14 each, ferrite), 18 test points, no 9 V battery, AMS1117 and tantalum removed; chain re-simulated at the 4.6 V rail; manual and README updated
    [ADC_Head-B_Cu.gbl, ADC_Head-B_Mask.gbs, ADC_Head-B_Silkscreen.gbo, ADC_Head-Edge_Cuts.gm1, ADC_Head-F_Cu.gtl, ADC_Head-F_Mask.gts, ADC_Head-F_Paste.gtp, ADC_Head-F_Silkscreen.gto]
2026-10-15 Head: + wire pad on the centre line (sets the piezo position), Auselia mark on the back; manual section 10 (questions and answers), clearer settling graph, head front and back views; real JLCPCB quot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
    [ADC_Head-B_Cu.gbl, ADC_Head-B_Mask.gbs, ADC_Head-B_Silkscreen.gbo, ADC_Head-Edge_Cuts.gm1, ADC_Head-F_Cu.gtl, ADC_Head-F_Mask.gts, ADC_Head-F_Paste.gtp, ADC_Head-F_Silkscreen.gto]
2026-10-15 Low-power 3.3 V revision plan (doc/lowpower_plan.md) and first look at the real AE captures (sim/listener_first_look.py)
2026-10-15 G1: 3.3 V chain, listener on real captures, bias-T at 3.3 V, charge amp estimate; ZedBoard PMOD supply; always-on decision
2026-10-16 v3 low-power 3.3 V board: 125 x 21.5 mm narrow layout, PMOD-powered, listener (WAKE_N/BIG_N), routed to 0 unconnected
    Manual and README still describe the v2 (5 V, USB-C) board and need regeneration.
    [ADC_Head-B_Cu.gbl, ADC_Head-B_Mask.gbs, ADC_Head-B_Silkscreen.gbo, ADC_Head-Edge_Cuts.gm1, ADC_Head-F_Cu.gtl, ADC_Head-F_Mask.gts, ADC_Head-F_Paste.gtp, ADC_Head-F_Silkscreen.gto]
2026-10-16 v3 manual (v0.3), README, renders, 1:1 print for the narrow 3.3 V board
2026-10-16 Refresh previews of the v3 main board
2026-10-16 Listener filter fix found by the netlist simulation: R36 10k, C41 22 pF, R39/R40 15k; sim/netlist_verify.py; manual and README updated
    [ADC_Head-B_Cu.gbl, ADC_Head-B_Mask.gbs, ADC_Head-B_Silkscreen.gbo, ADC_Head-Edge_Cuts.gm1, ADC_Head-F_Cu.gtl, ADC_Head-F_Mask.gts, ADC_Head-F_Paste.gtp, ADC_Head-F_Silkscreen.gto]
2026-10-16 Manual: tighten step 32
    [adc_part_d.py]
2026-10-20 Study notes and slide assets: head, bias-T, high-pass, gain stage, low-pass
2026-10-20 Backplane route A: FMC adapter + 8-slot module (generator, KiCad boards, JLCPCB BOM/CPL/Gerbers), plan updated
    [BP_Module.kicad_pcb, BP_Module.kicad_sch, BP_Module_BOM_JLC.csv, BP_Module_pos_kicad.csv, FMC_Adapter.kicad_pcb, FMC_Adapter.kicad_sch, FMC_Adapter_BOM_JLC.csv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]
2026-10-20 Slides 7 to 13: derivation PDFs, circuit and graph SVGs, slide text
2026-10-20 Single-ended vs coupled differential chain comparison (ngspice) and supply-filter fix
    [diff_vs_se_results.txt]
2026-10-20 Power: 5-pin SMU header J7 replaces JP2/JP4/JP5/JP6 and the 2-pin header; top silkscreen with TP and IC numbers; slides and README updated
    [ADC_Head-B_Cu.gbl, ADC_Head-B_Mask.gbs, ADC_Head-B_Silkscreen.gbo, ADC_Head-Edge_Cuts.gm1, ADC_Head-F_Cu.gtl, ADC_Head-F_Mask.gts, ADC_Head-F_Paste.gtp, ADC_Head-F_Silkscreen.gto]
2026-10-20 Single-board 16-channel backplane: generator and placement (not routed), status noted
    [BP16.kicad_pcb, BP16.kicad_sch]
2026-10-26 Head: two M2 mounting holes (board 10 x 27 mm); JLC CPL: J7 rotation 0 and centre offset, J3 centre offset
    [ADC_Head-B_Cu.gbl, ADC_Head-B_Mask.gbs, ADC_Head-B_Silkscreen.gbo, ADC_Head-Edge_Cuts.gm1, ADC_Head-F_Cu.gtl, ADC_Head-F_Mask.gts, ADC_Head-F_Paste.gtp, ADC_Head-F_Silkscreen.gto]
2026-10-26 CPL: J3 centre offset 1.27 mm toward the board edge so the body sits flush
    [ADC_Test_CPL_JLC.csv]
2026-10-26 Back silkscreen: PMOD legend moved, staggered test point names; CPL: U6 and U9 rotation 180
    [ADC_Head-B_Cu.gbl, ADC_Head-B_Mask.gbs, ADC_Head-B_Silkscreen.gbo, ADC_Head-Edge_Cuts.gm1, ADC_Head-F_Cu.gtl, ADC_Head-F_Mask.gts, ADC_Head-F_Paste.gtp, ADC_Head-F_Silkscreen.gto]
2026-10-26 Silk: TP and JP labels centred on their pads, J7 pin legend, tidy back panel (AFE Test Board with logo, TP table, PMOD and J7 legends)
    [ADC_Head-B_Cu.gbl, ADC_Head-B_Mask.gbs, ADC_Head-B_Silkscreen.gbo, ADC_Head-Edge_Cuts.gm1, ADC_Head-F_Cu.gtl, ADC_Head-F_Mask.gts, ADC_Head-F_Paste.gtp, ADC_Head-F_Silkscreen.gto]
2026-10-26 Head: +/- silk, U8 CPL rotation 0; main board silk says v1
    [ADC_Head-B_Cu.gbl, ADC_Head-B_Mask.gbs, ADC_Head-B_Silkscreen.gbo, ADC_Head-Edge_Cuts.gm1, ADC_Head-F_Cu.gtl, ADC_Head-F_Mask.gts, ADC_Head-F_Paste.gtp, ADC_Head-F_Silkscreen.gto]
2026-10-26 Manual: power header J7 and JP3, silkscreen, CPL fixes, TP and IC labels; board data refreshed
    [adc_common.py, adc_part_a.py, adc_part_b.py, adc_part_d.py, adc_part_e.py, adc_part_f.py, adc_part_h.py]
2026-10-26 Back silkscreen spread out; Auselia / AFE Test Board v1 title
    [ADC_Head-B_Cu.gbl, ADC_Head-B_Mask.gbs, ADC_Head-B_Silkscreen.gbo, ADC_Head-Edge_Cuts.gm1, ADC_Head-F_Cu.gtl, ADC_Head-F_Mask.gts, ADC_Head-F_Paste.gtp, ADC_Head-F_Silkscreen.gto]
2026-10-26 Back silk: Oct 2026
    [ADC_Head-B_Cu.gbl, ADC_Head-B_Mask.gbs, ADC_Head-B_Silkscreen.gbo, ADC_Head-Edge_Cuts.gm1, ADC_Head-F_Cu.gtl, ADC_Head-F_Mask.gts, ADC_Head-F_Paste.gtp, ADC_Head-F_Silkscreen.gto]
2026-11-04 Bring-up guide: white printer-friendly cover with the mark and signal rings, coloured wordmark, faint mark in the footer, no header logo
